koteos/RANDOM/10-EKOT-1074-170619A-UBF-PI/DOC/WhatsApp Image 2026-09-30 at 3.54.33 PM.jpeg

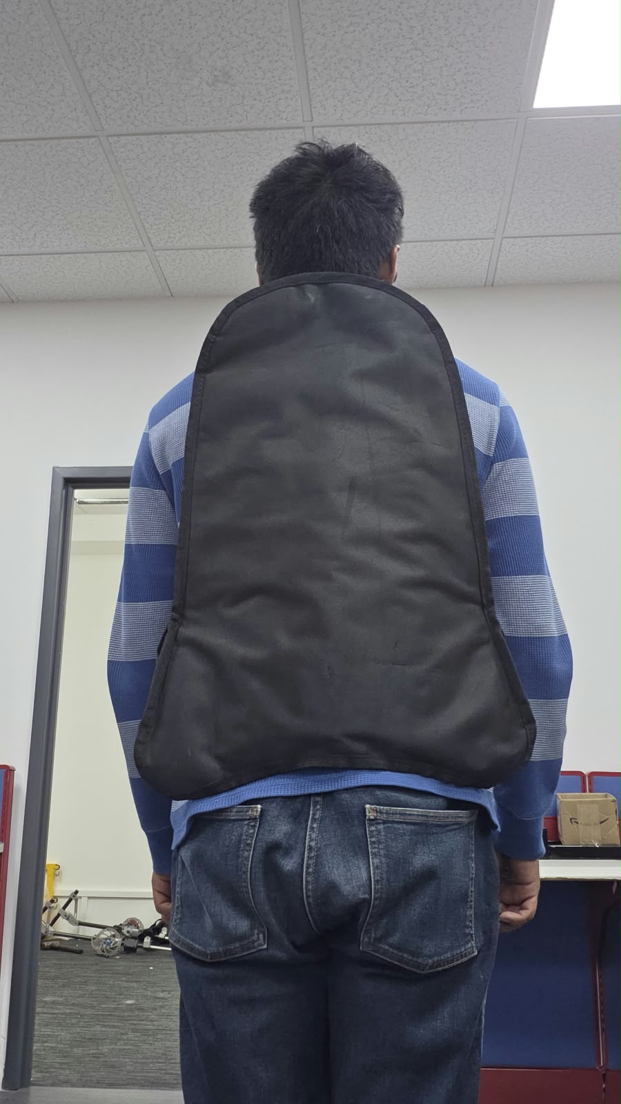
10-EKOT-1074-170619A-UBF-PI/DOC/WhatsApp Image 2026-09-30 at 3.54.33 PM.jpeg
