koteos/RANDOM/10-EKOT-1074-170619A-UBF-PI/V1.6_PANACEA/readme-and-terms-of-use-3d-cad-models.docx

EN Your CAD data on 13.03.2026 from Festo:

Dear customer,

attached please find the following file of our 2D/3D-CAD download portal powered by CADENAS:

identification number: 2674 SG-M10

STEP, 2674 SG-M10, 2674_SG-M10.stp

Please also check terms of use at:

https://www.cadenas.de/terms-of-use-3d-cad-models

Best regards

Festo SE & Co. KG

CAD Service

design_tool@festo.com
