koteos/RANDOM/10-EKOT-1074-170619A-UBF-PI/V1.4_SE_FABRICO/3D/LISTA_TORNILLERIA.txt

TORNILLERIA

- 10 Tornillo  M2 x 12 o 15

- 25 Tornillo  M3 x 5
- 10 Tornillo  M3 x 10
- 10 Tornillo  M3 x 16

- 4  Tornillo  M4 x 5
- 4  Tornillo  M4 x 10
- 10 Tornillo  M4 x 12

- 5  Tornillos M5 x 30

- 10 Tornillos M6 x 20
- 2  Tornillo  M6 x 25

- 4 hombros 6  x 25
- 4 Hombros 6  x 20 
- 2 Hombros 12 x 10

- 2 Prisionero M3

- 2  Tuercas M10
- 20 Tuercas M5

- 8 bujes roscados interior m6
- broca 2mm
- caja de prisioneros
