koteos/RANDOM/10-EKOT-1074-170619A-UBF-PI/V1.0/DOC/Kotemah® COBHAN - Propuesta Técnica -.pptx

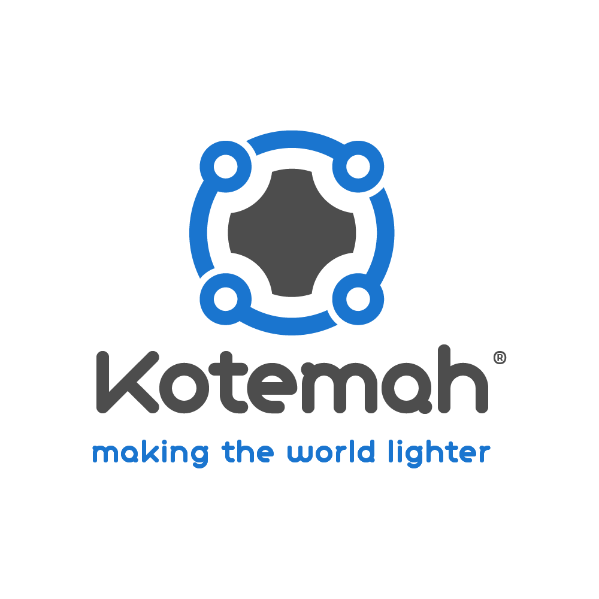
[picture p9: figure]

## Slide 2

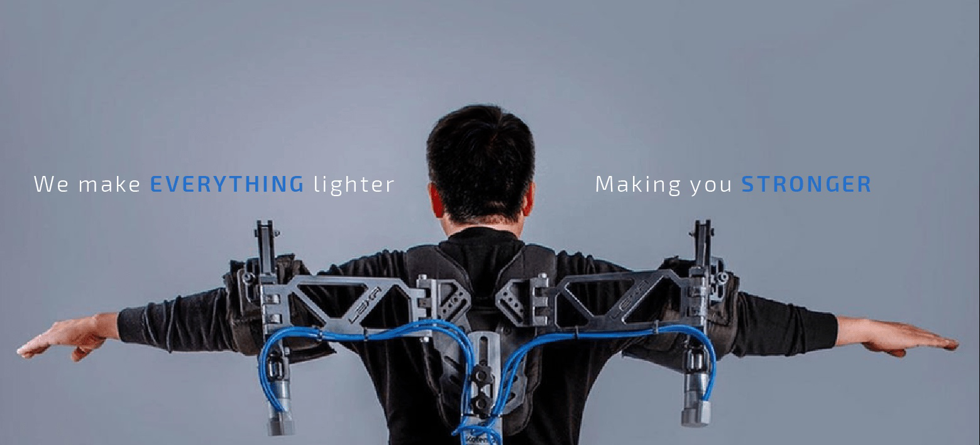
[picture p10: figure]

## Slide 3

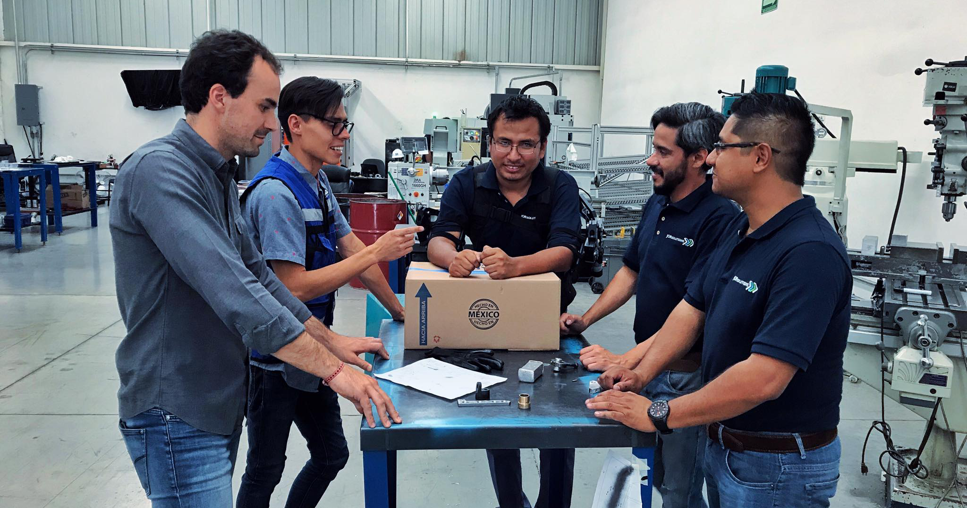
[picture p11: figure]

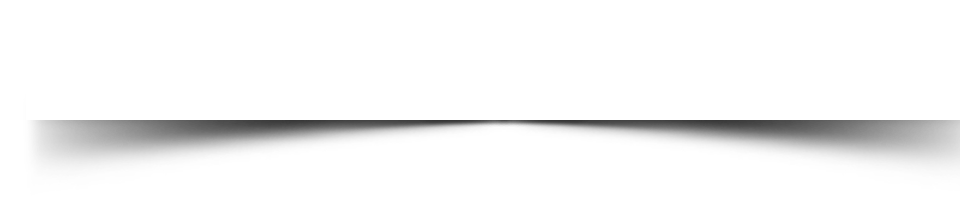
[picture p12: figure]

5 años

haciendo a México más ligero °

## Slide 4

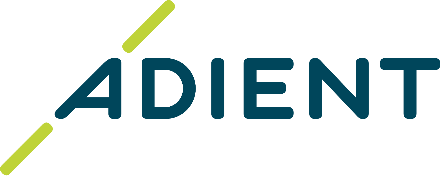
[picture p13: figure]
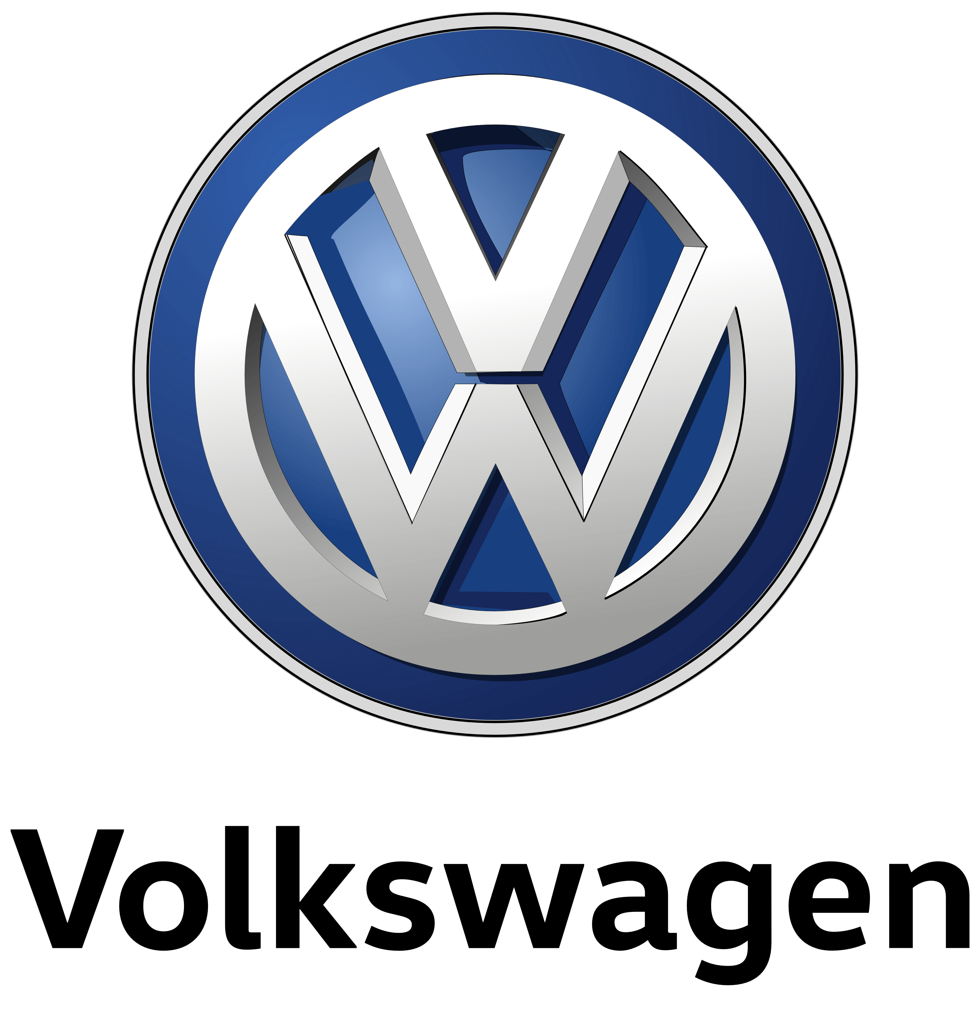
[picture p14: figure]
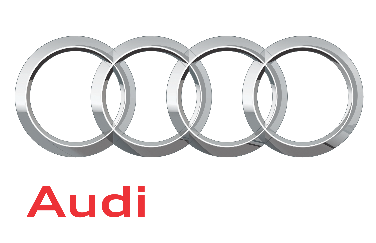
[picture p15: figure]
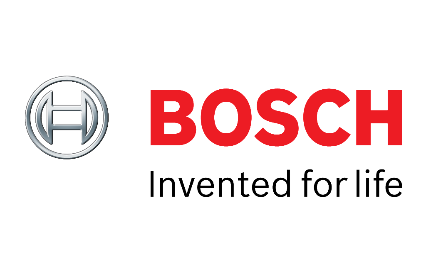
[picture p16: figure]
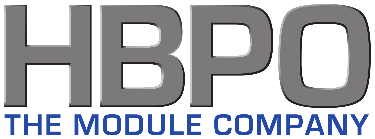
[picture p17: figure]
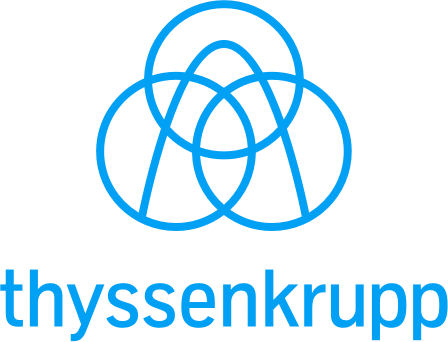
[picture p18: figure]

## Slide 5

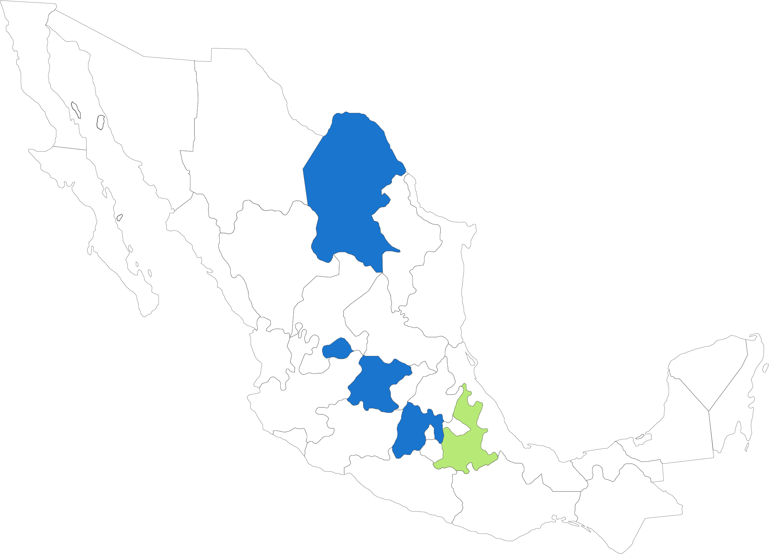
[picture p19: figure]
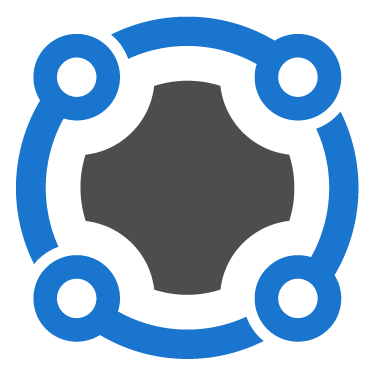
[picture p20: figure]

México

## Slide 6

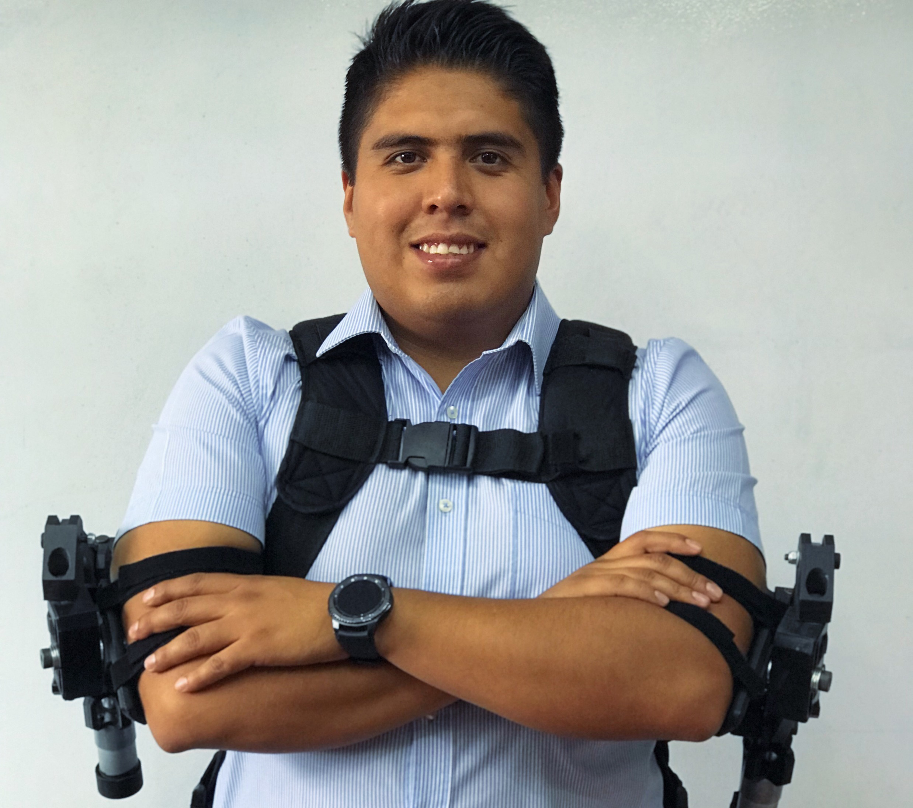
[picture p21: figure]
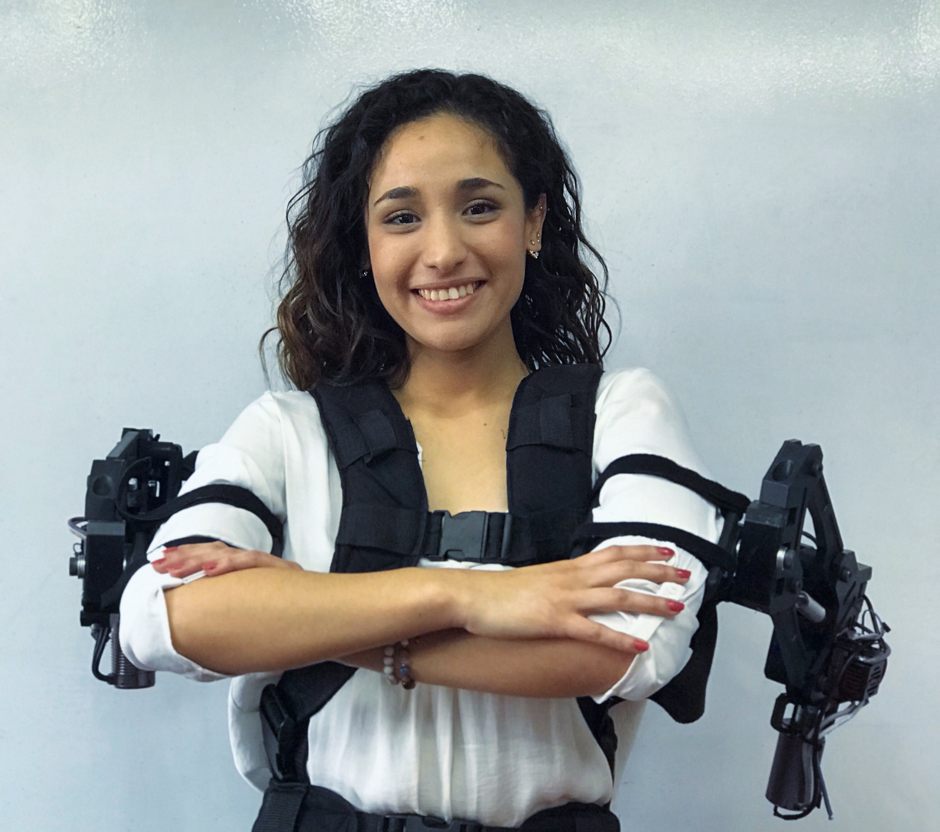
[picture p22: figure]
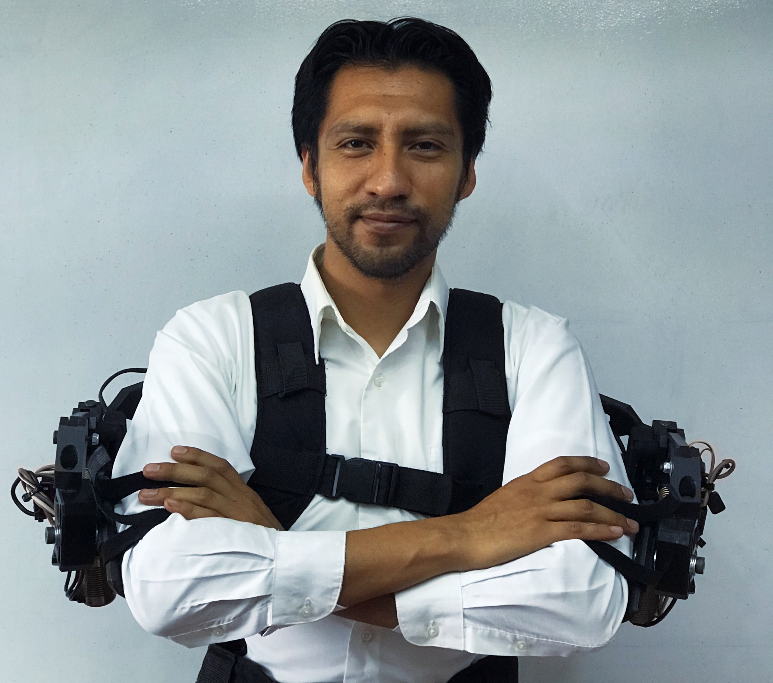
[picture p23: figure]
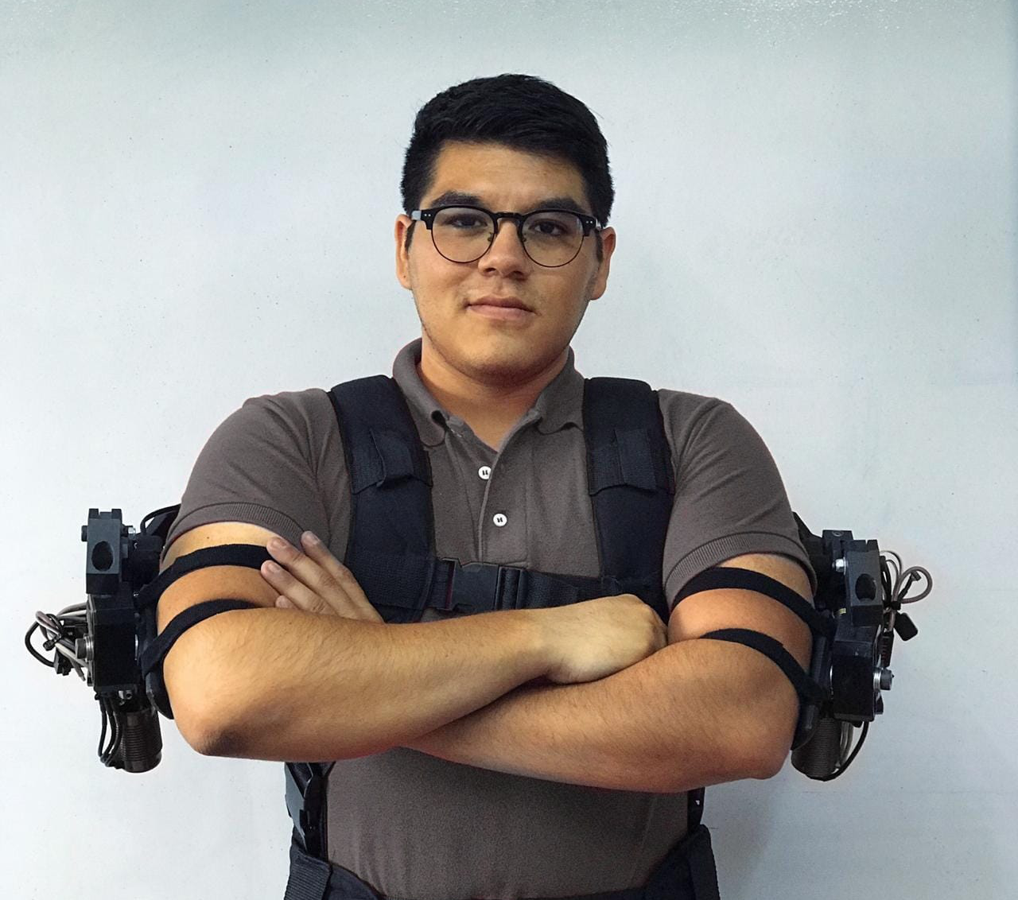
[picture p24: figure]
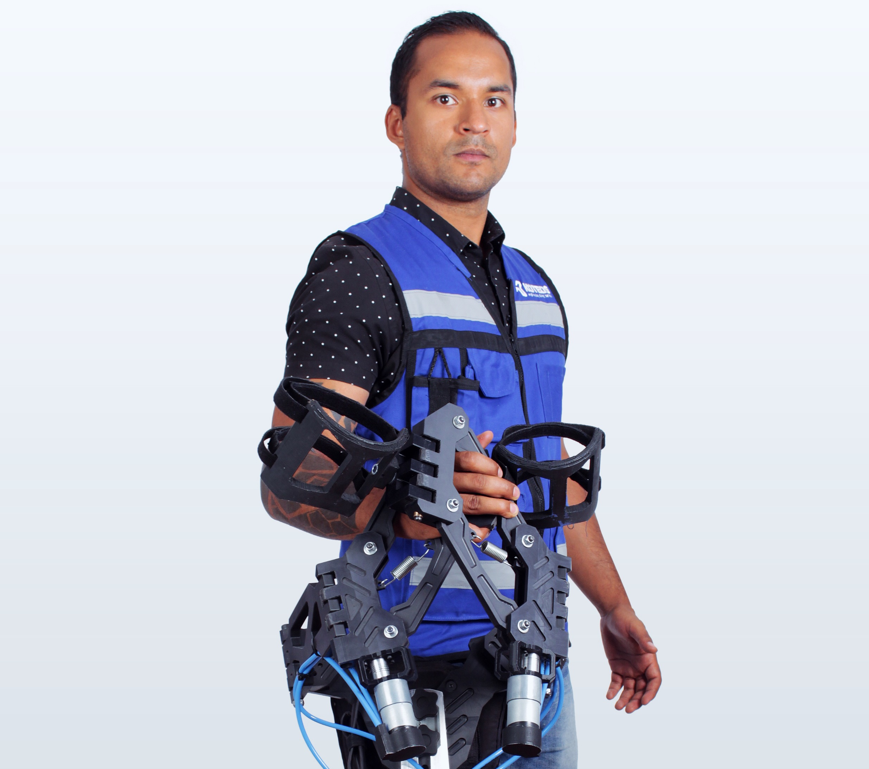
[picture p25: figure]

SOMOS EXPERTOS

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
Martín
Ventas Consultivas

Lizeth
Ergonomía

Antonio
Análisis

Carlos
Investigación y Desarrollo

Abissai
Proyectos

EN LIFTING

## Slide 7

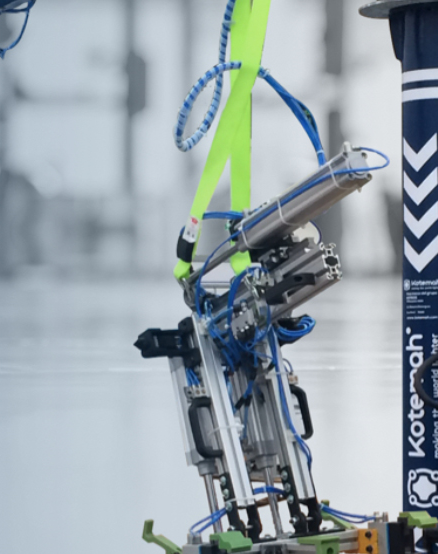
[picture p26: figure]

ASISTENTE DE CARGA

PARA BANCA FRONTAL CONDUCTOR

Ing. Josafat E. Badillo Gallegos
Advanced Manufacturing Engineer
ADIENT

## Slide 8

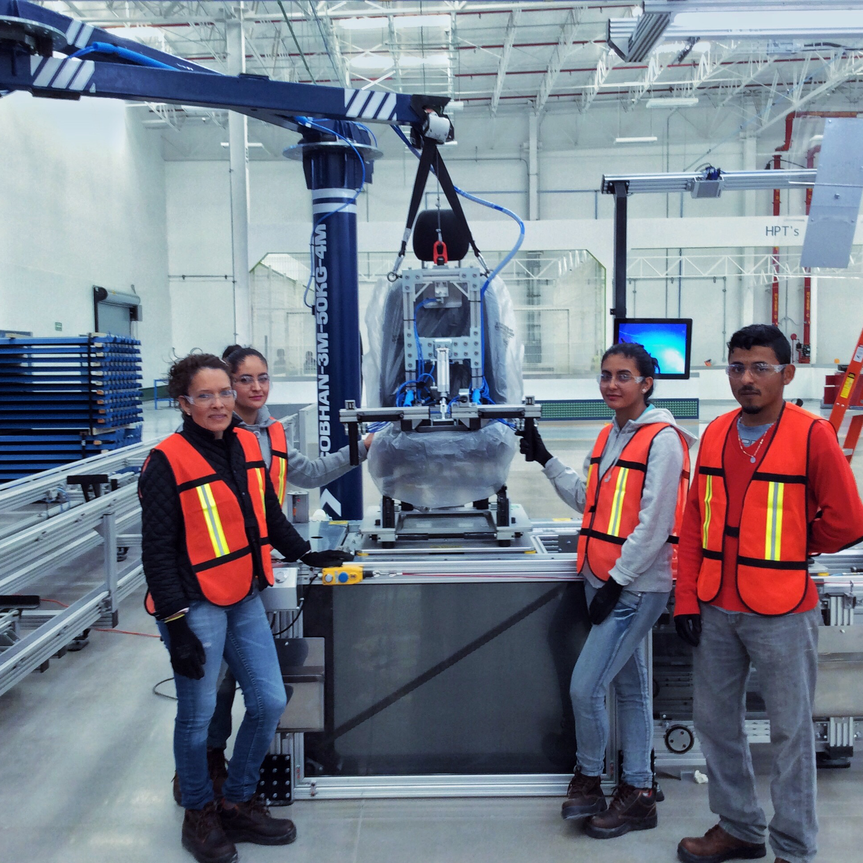
[picture p27: figure]

COBHAn

El favorito para líneas de ensamble

Asistencia: Hasta 200 Kg
Altura: Hasta 4 metros
Alcance: Hasta 6 metros
Área de Manipulación: 320°

## Slide 9

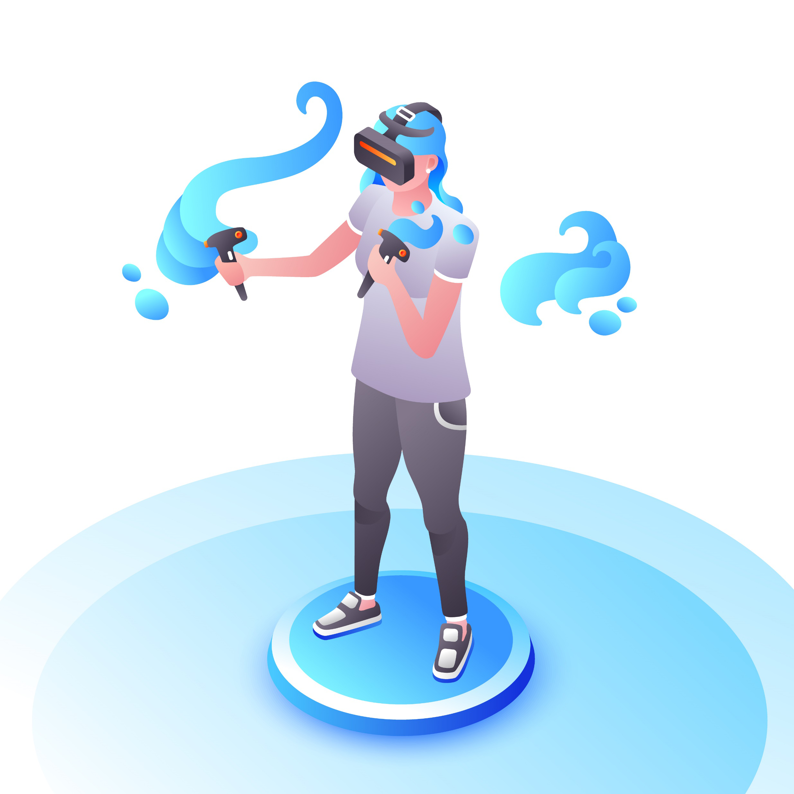
[picture p28: figure]
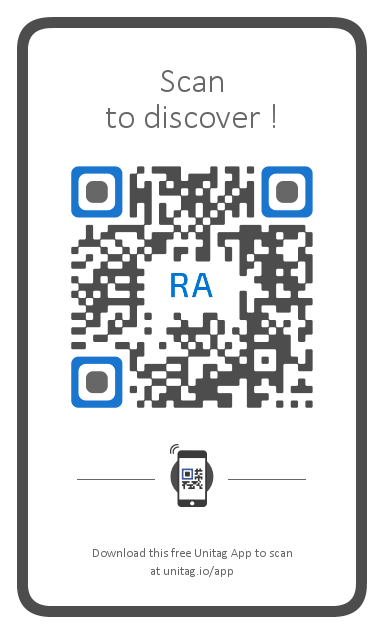
[picture p29: figure]

## Slide 10

COBHAn

El favorito para líneas de ensamble

VISTA GENERAL

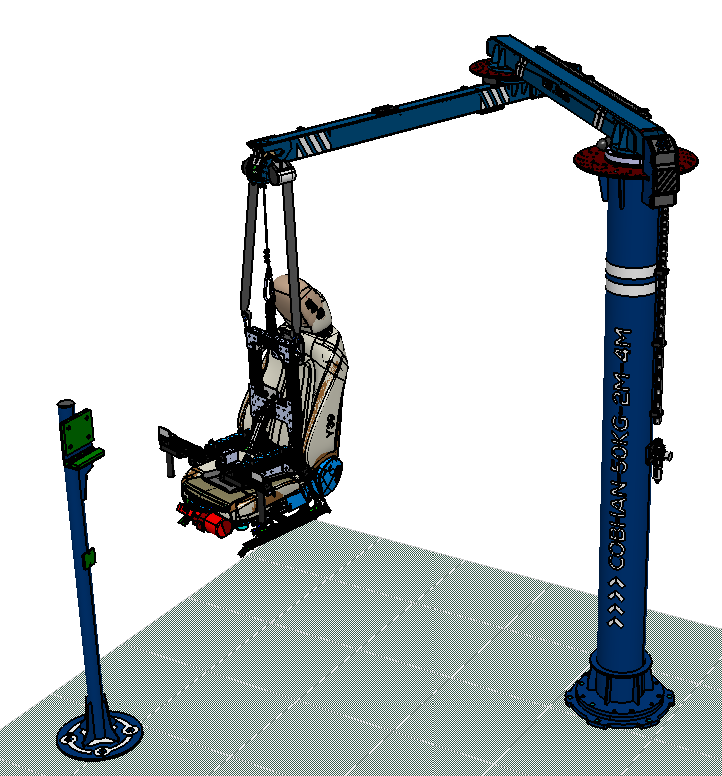
[picture p30: figure]

*AQUI VA LA CAPTURA DE PANTALLA
DE TU MANIPULADOR EN VISTA GENERAL*
*SIN COTAS*

## Slide 11

COBHAn

El favorito para líneas de ensamble

COMPONENTES PRINCIPALES

*AQUI VA TU CAPTURA DE PANTALLA QUE INDIQUE LOS COMPONENTES DE TU MANIPULADOR*
*CON COTAS*

## Slide 12

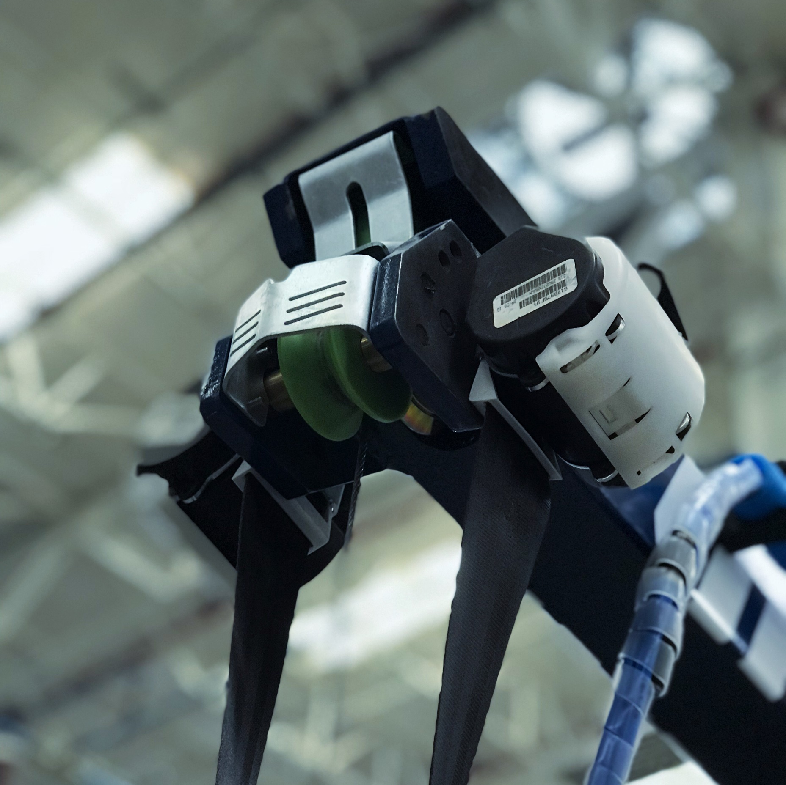
[picture p31: figure]

SEGURIDAD

## Slide 13

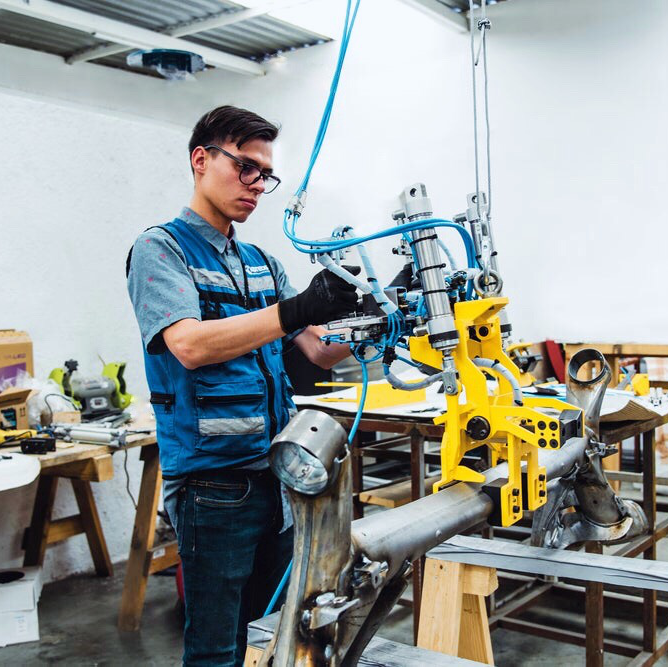
[picture p32: figure]

Gripper

## Slide 14

Gripper

VISTA GENERAL

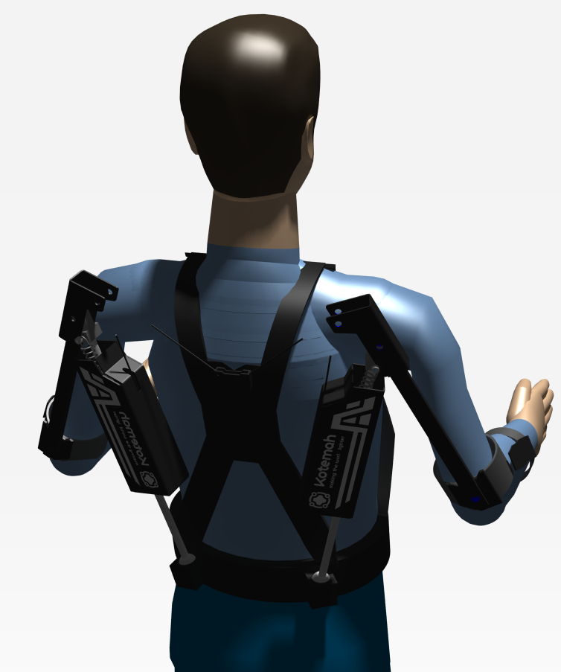
[picture p33: figure]

LeXA LiGHT

## Slide 15

Gripper

COMPONENTES PRINCIPALES

NUEVA EXTENSIÓN DE ALUMINIO QUE PERMITIRÁ MANTENER EL GRIPPER A UNA DISTANCIA NO MAYOR DE 30CM DEL CUERPO Y A UNA ALTURA DE 105 CM DEL PISO.

REUBICACIÓN DE BOTONERAS

REUBICACIÓN DE SELECTORES

REUBICACIÓN DE BOTONERAS

## Slide 16

## Slide 17

Gripper

DESCRIPCION DE PROPUESTA

CONTARÁ CON DOS PARES DE MANUBRIOS/BOTONERAS.

CON LOS MANUBRIOS “A” SE MANIPULARÁ EL GRIPPER PARA LLEGAR AL RACK Y CARGAR EL PRODUCTO. (POSICIÓN BAJA)

UNA VEZ SUJETO EL PRODUCTO, EL OPERADOR PRESIONARÁ EL BOTÓN SUBIR, Y PROCEDERÁ A TOMAR EL GRIPPER CON LOS MANUBRIOS “B”
(POSICIÓN ALTA).

ALTERNAR EL USO DE LOS MANDOS EVITARÁ QUE EL OPERADOR ESTIRE LOS BRAZOS ARRIBA DE LOS 107 CM.

A

B

## Slide 18

Gripper

AUMENTO DE AREA DE PRESION (BOTONES)

PROPUESTA 1.:
VULCANIZAR GATILLOS PARA LOGRAR ENSANCHAR EL AREA DE PRESION DE LA BOTONERA.
(SUJETO A PREUBAS DE ADHERENCIA DEL VULCANIZADO AL GATILLO).

PROPUESTA 2:
FABRICACION DE GATILLOS PERSONALIZADOS.
PODRÍA IMPLICAR COSTO MAYOR.

## Slide 19

¡Gracias!
Juntos podemos hacer a
ADIENT más ligero

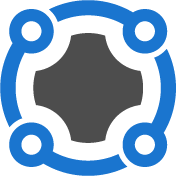
[picture p34: figure]
