koteos/RANDOM/10-EKOT-1074-170619A-UBF-PI/DOC/BOTONES.JPG

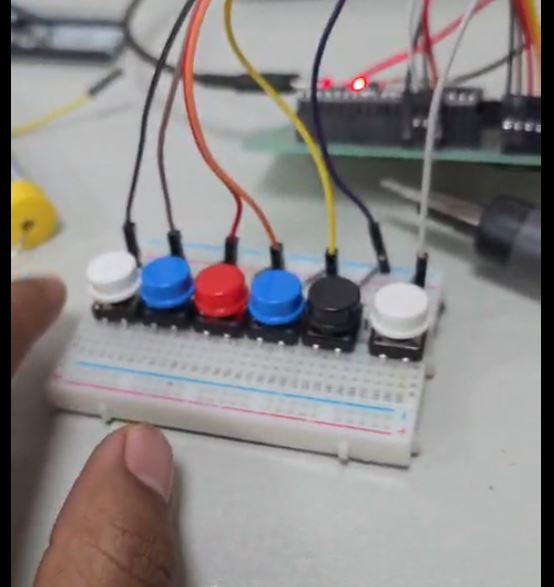
10-EKOT-1074-170619A-UBF-PI/DOC/BOTONES.JPG
