koteos/RANDOM/10-EKOT-1074-170619A-UBF-PI/DOC/LEXA_CHALECO.jpg

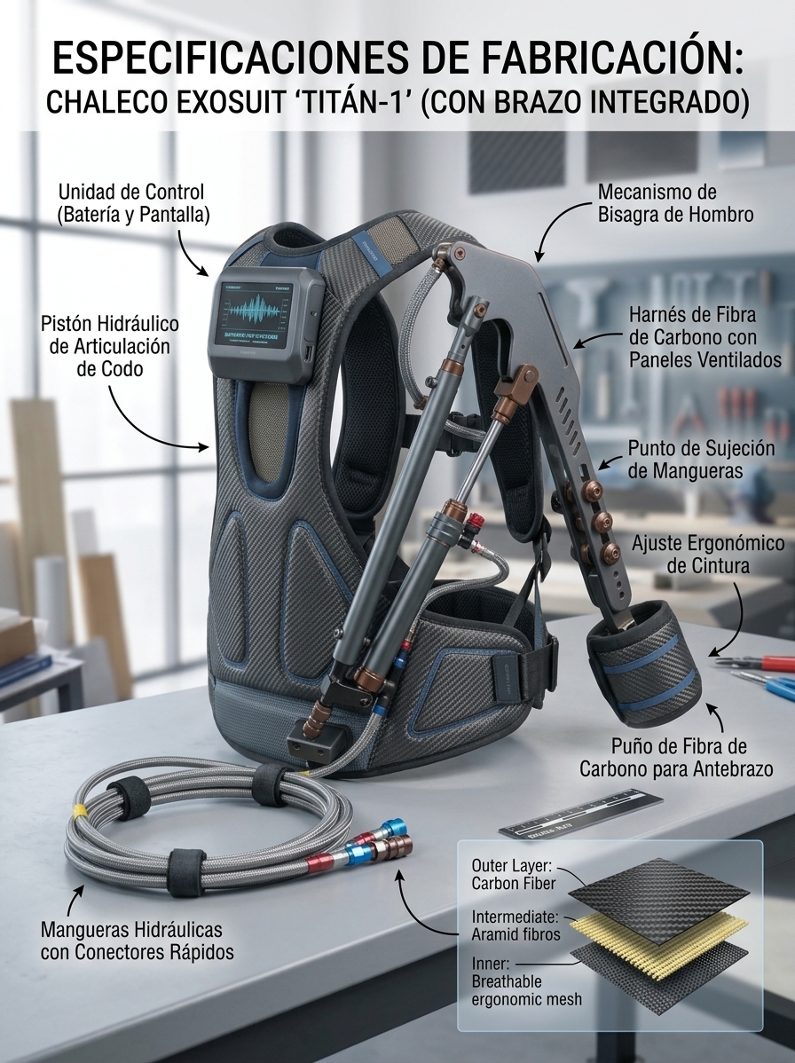
10-EKOT-1074-170619A-UBF-PI/DOC/LEXA_CHALECO.jpg
