koteos/RANDOM/10-EKOT-1074-170619A-UBF-PI/DOC/WhatsApp Image 2026-09-28 at 1.29.09 PM.jpeg

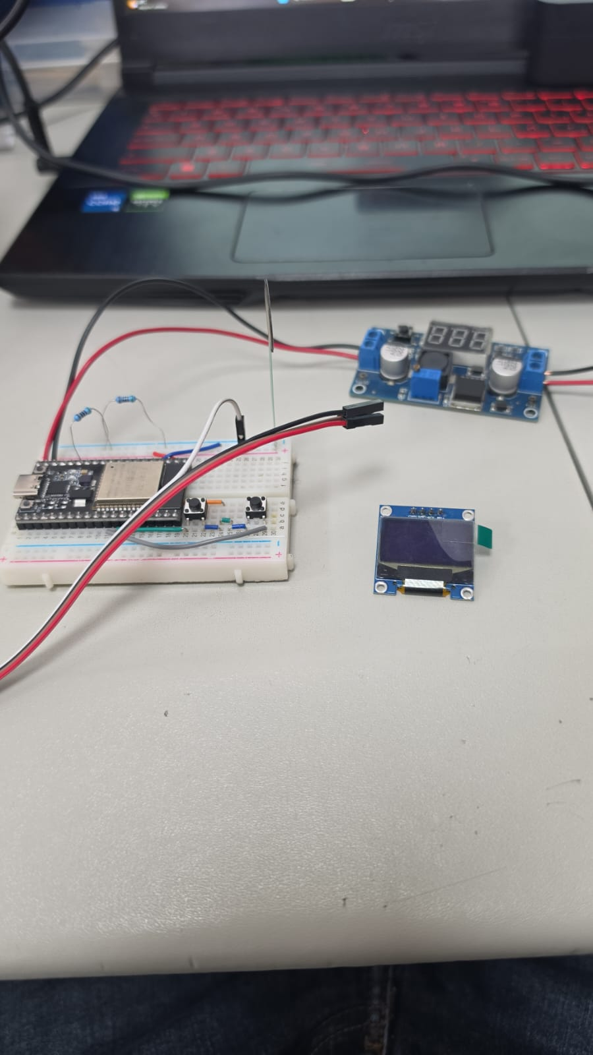
10-EKOT-1074-170619A-UBF-PI/DOC/WhatsApp Image 2026-09-28 at 1.29.09 PM.jpeg
