koteos/RANDOM/10-EKOT-1074-170619A-UBF-PI/DOC/WhatsApp Image 2026-09-29 at 4.07.12 PM.jpeg

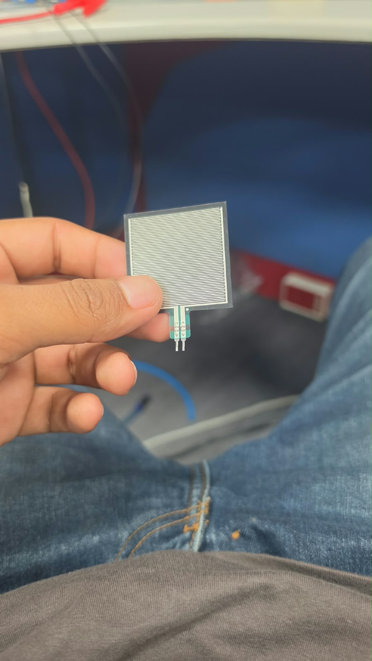
10-EKOT-1074-170619A-UBF-PI/DOC/WhatsApp Image 2026-09-29 at 4.07.12 PM.jpeg
