koteos/RANDOM/10-EKOT-1074-170619A-UBF-PI/V1.4_SE_FABRICO/DOC/RESORTE_CALCULO_55_ESPIRAS.JPG

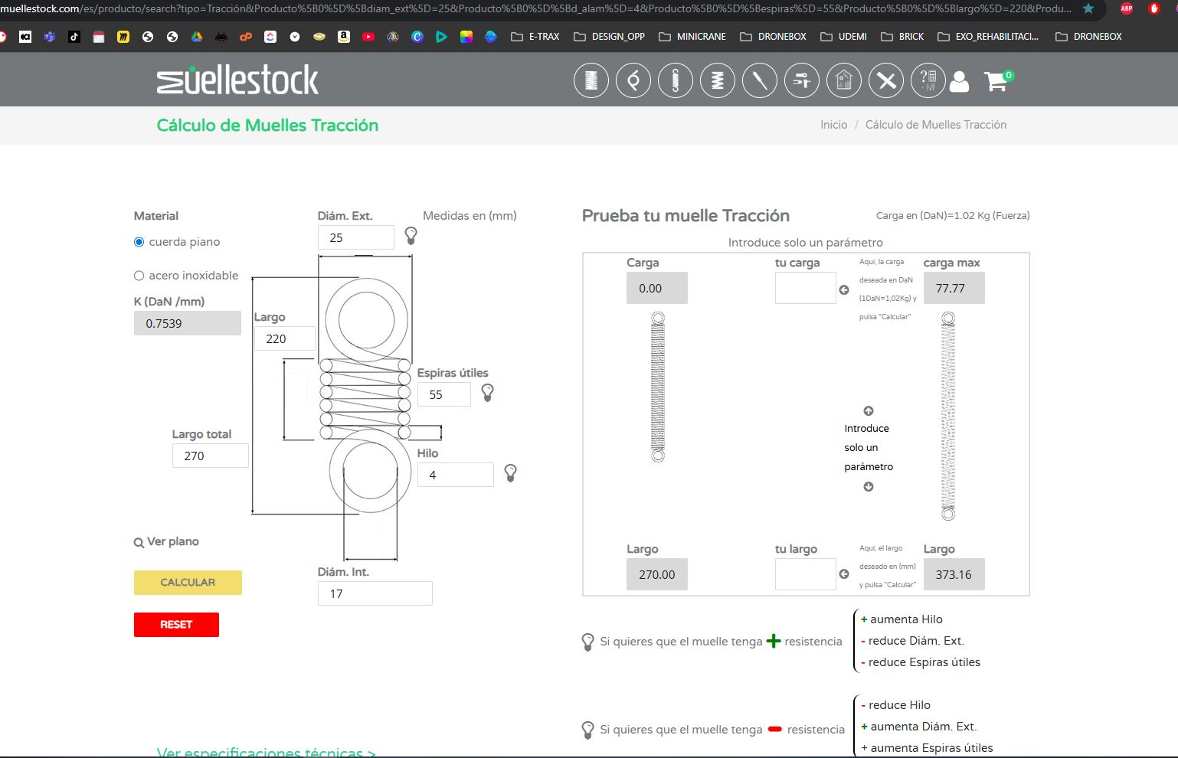
10-EKOT-1074-170619A-UBF-PI/V1.4_SE_FABRICO/DOC/RESORTE_CALCULO_55_ESPIRAS.JPG
