koteos/RANDOM/EKOT-1360-170921A-LEXA_WAIST_SUPPORT/V.06/DOC/RENDER2/COSTAL_HOMBRO.jpg

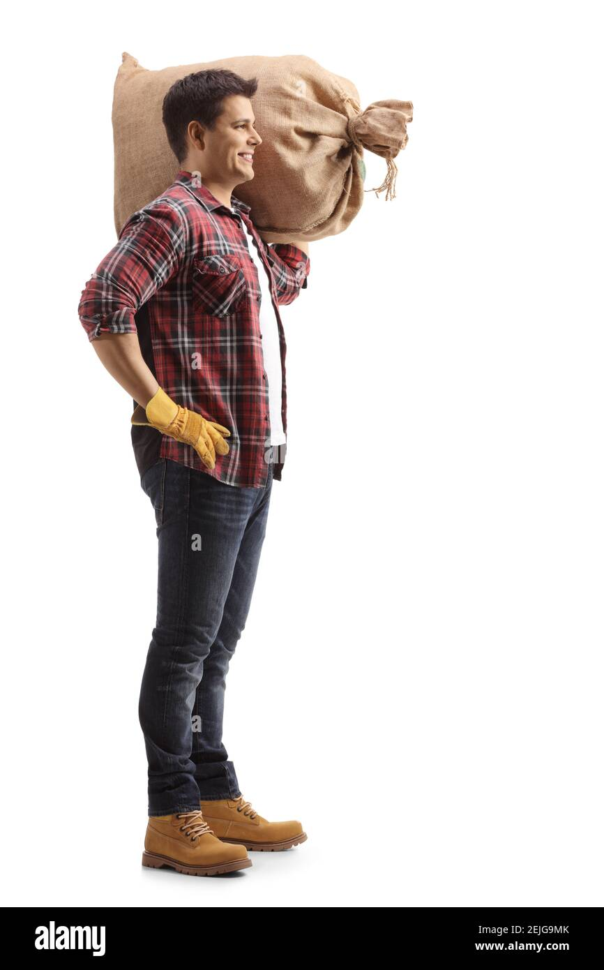
EKOT-1360-170921A-LEXA_WAIST_SUPPORT/V.06/DOC/RENDER2/COSTAL_HOMBRO.jpg
