koteos/RANDOM/EKOT-1360-170921A-LEXA_WAIST_SUPPORT/V.06/DOC/RENDER2/D4.JPG

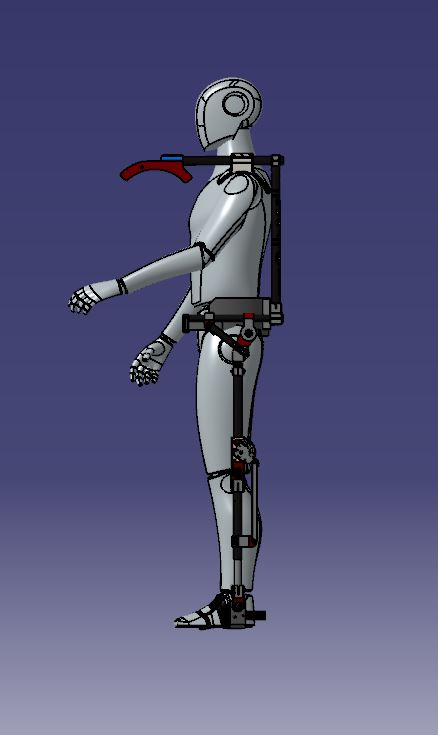
EKOT-1360-170921A-LEXA_WAIST_SUPPORT/V.06/DOC/RENDER2/D4.JPG
