koteos/RANDOM/EKOT-1360-170921A-LEXA_WAIST_SUPPORT/V.06/DOC/RENDER/EXO_COMPLETE.png

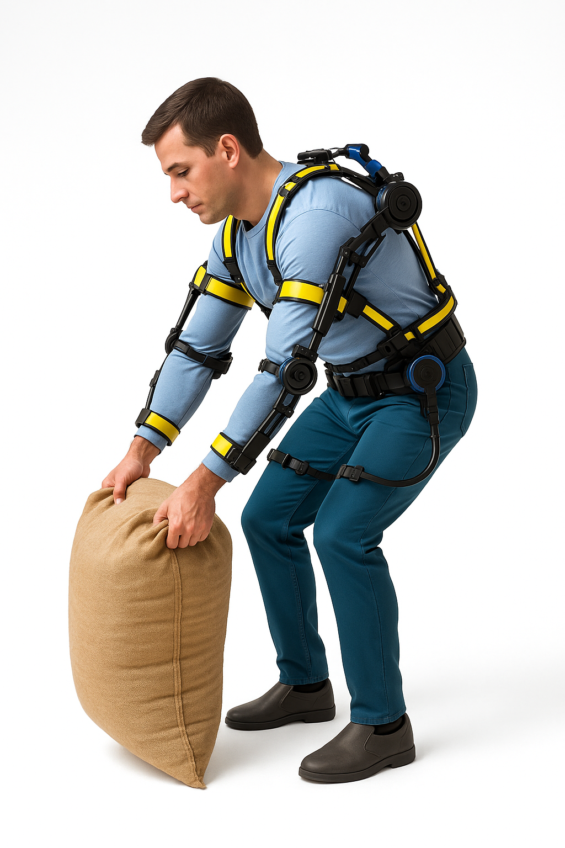
EKOT-1360-170921A-LEXA_WAIST_SUPPORT/V.06/DOC/RENDER/EXO_COMPLETE.png
