koteos/RANDOM/Gravedad_Cero_Electrico_filtro_v1/gravedad_cero.jpeg

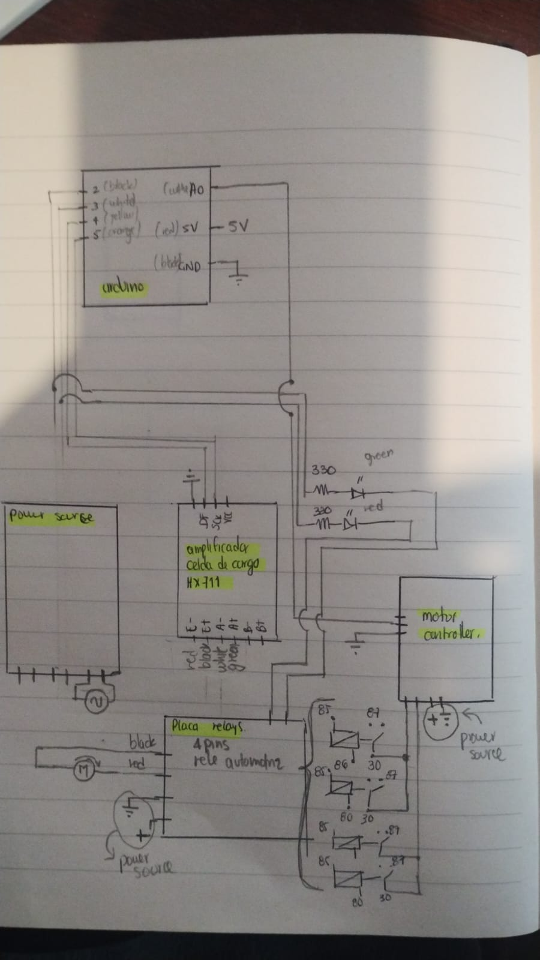
Gravedad_Cero_Electrico_filtro_v1/gravedad_cero.jpeg
