koteos/RANDOM/IMAGE_CLEAR/fotos_originales/motor.JPG

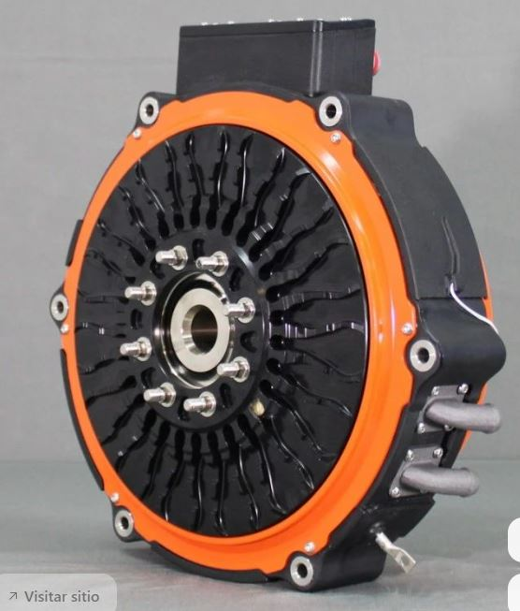
IMAGE_CLEAR/fotos_originales/motor.JPG
