koteos/RANDOM/INICIO.jpg

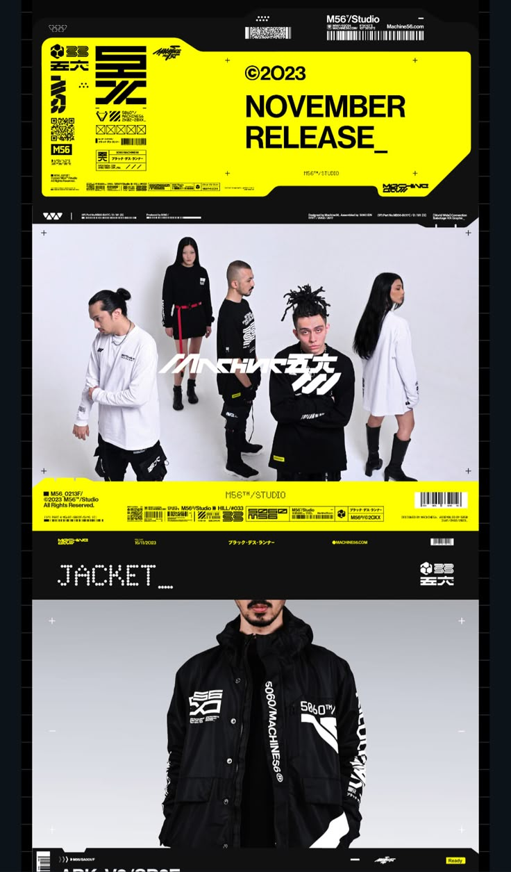
INICIO.jpg
