koteos/RANDOM/pancho.jpeg

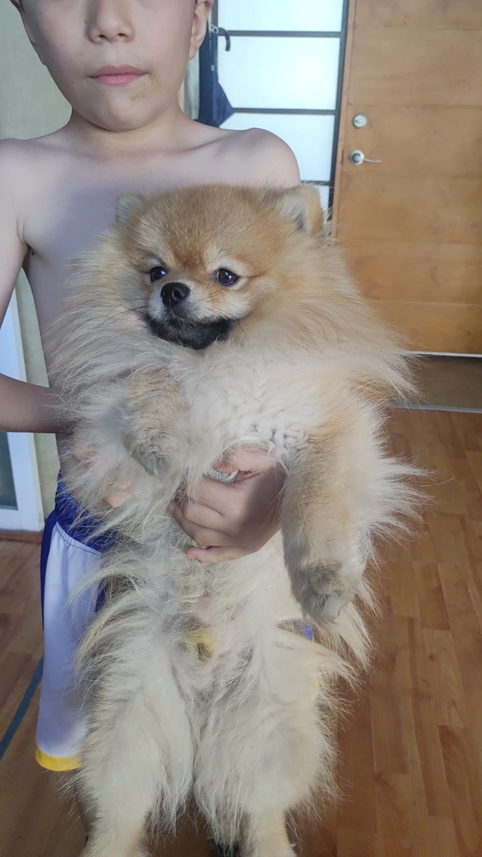
pancho.jpeg
