koteos/RANDOM/PIERNAS_EXO/Against Reference Model.png

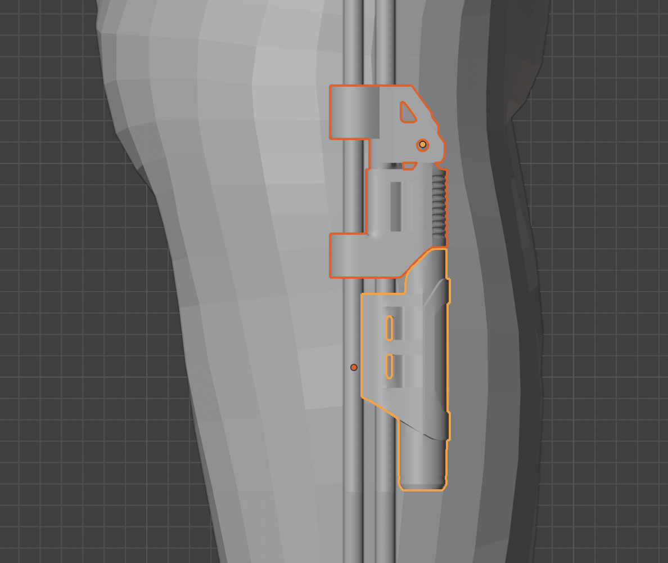
PIERNAS_EXO/Against Reference Model.png
