koteos/RANDOM/PIERNAS_EXO/Exploded Diagram.png

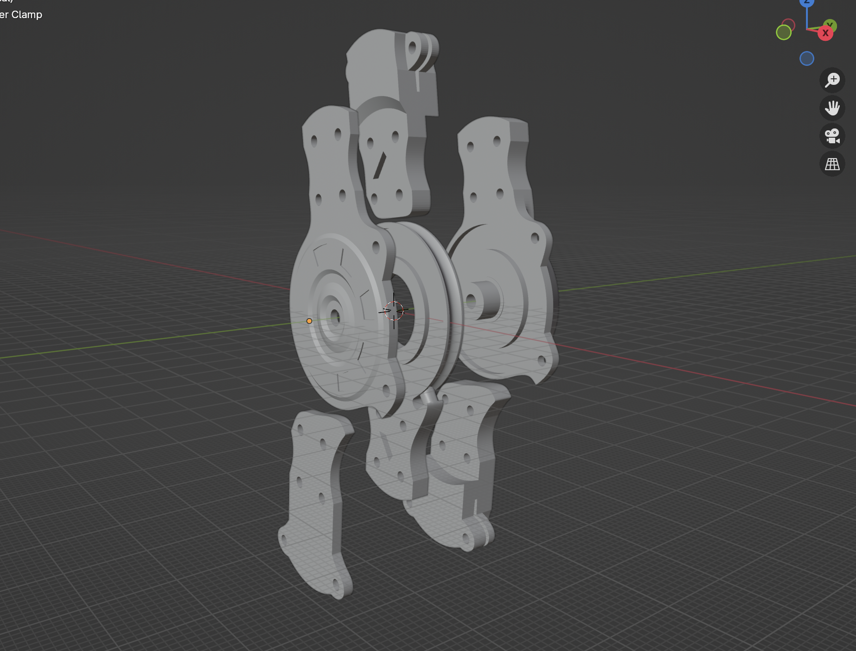
PIERNAS_EXO/Exploded Diagram.png
