koteos/RANDOM/PIERNAS_EXO/Files.png

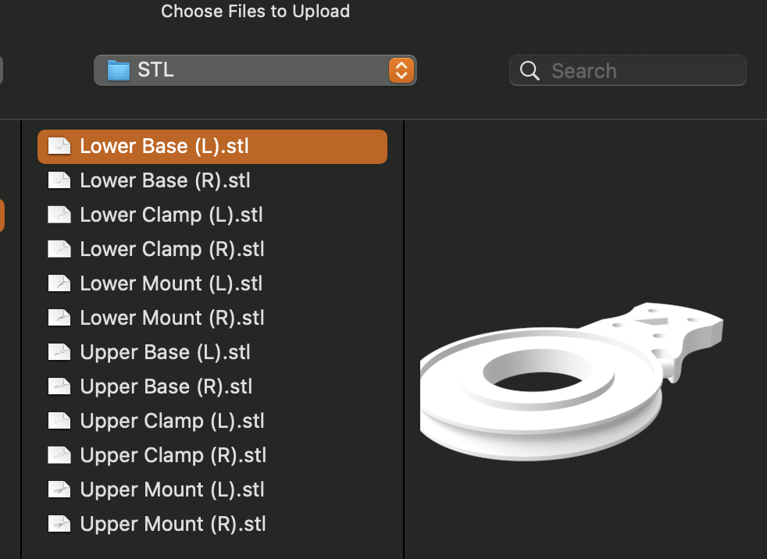
PIERNAS_EXO/Files.png
