koteos/RANDOM/PIERNAS_EXO/Image of Blender.png

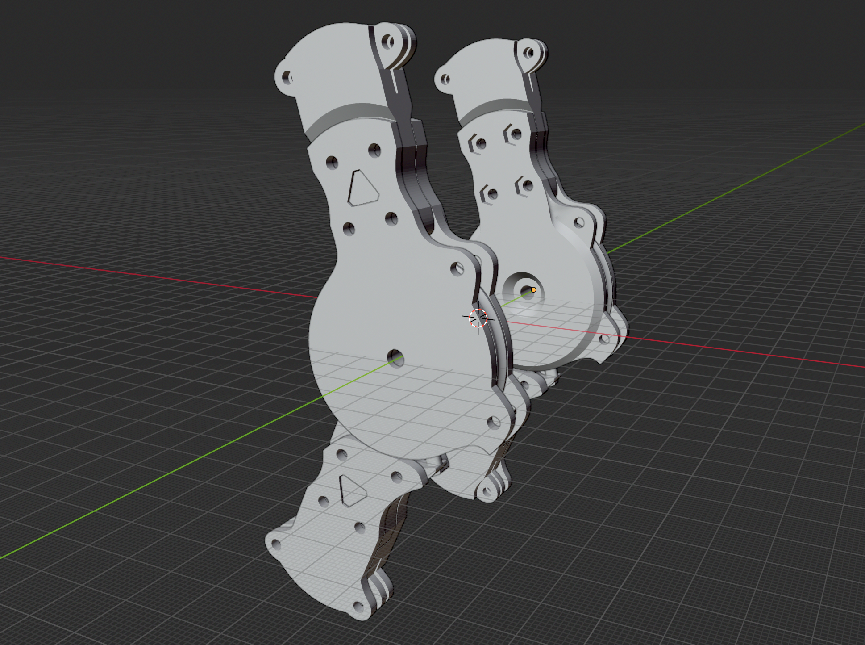
PIERNAS_EXO/Image of Blender.png
