koteos/RANDOM/PIERNAS_EXO/Knee Wire Frame (1).png

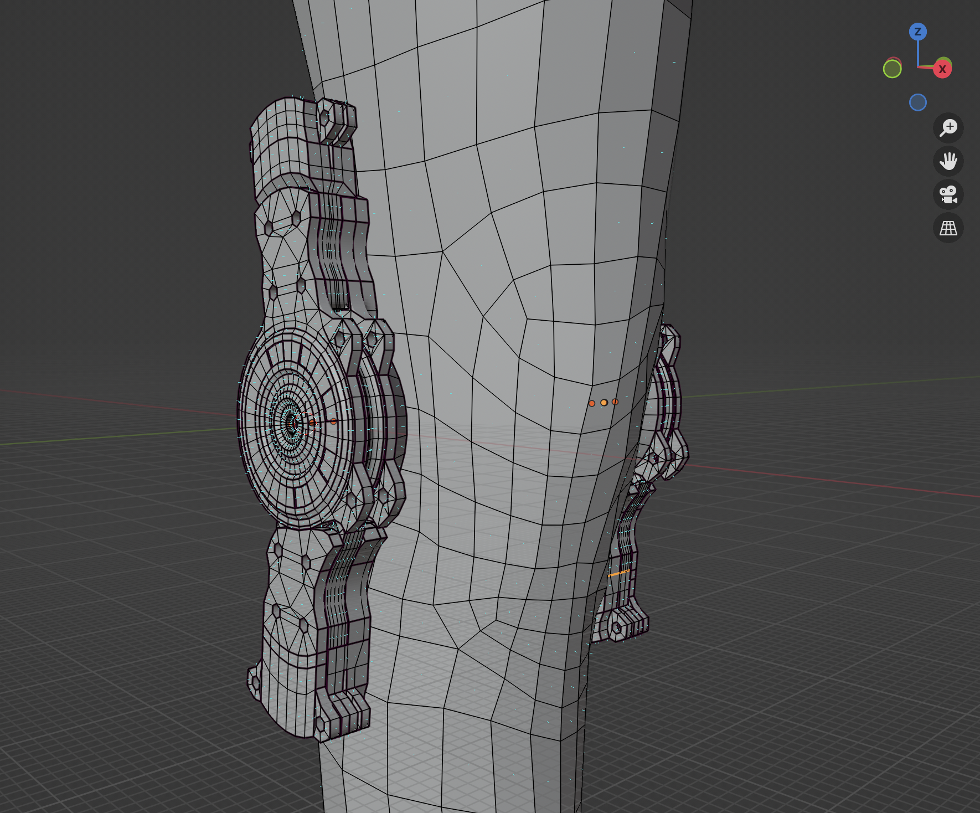
PIERNAS_EXO/Knee Wire Frame (1).png
