koteos/RANDOM/PIERNAS_EXO/Recommended Slicing Layout (R).png

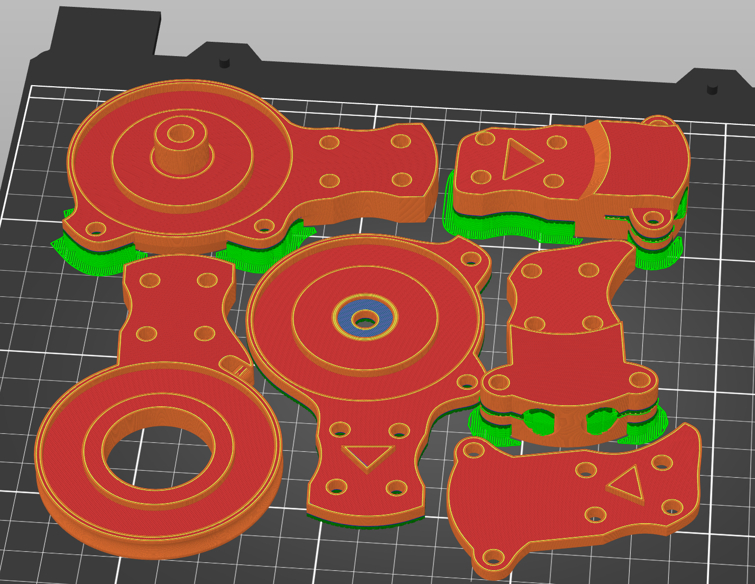
PIERNAS_EXO/Recommended Slicing Layout (R).png
