koteos/RANDOM/PIERNAS_EXO/Spring Covers & Mount.png

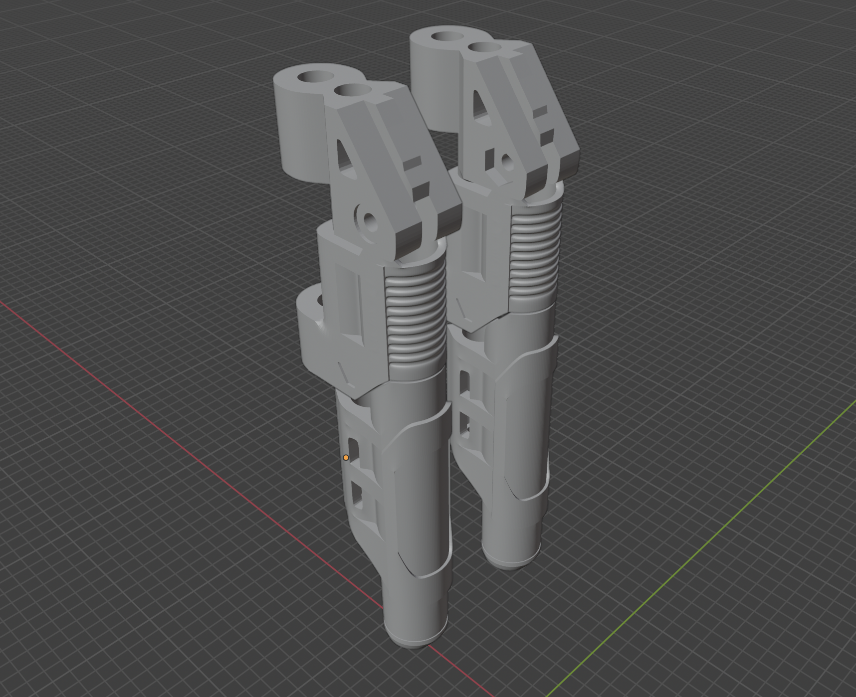
PIERNAS_EXO/Spring Covers & Mount.png
