koteos/RANDOM/PIERNAS_EXO/Spring No Extend.jpg

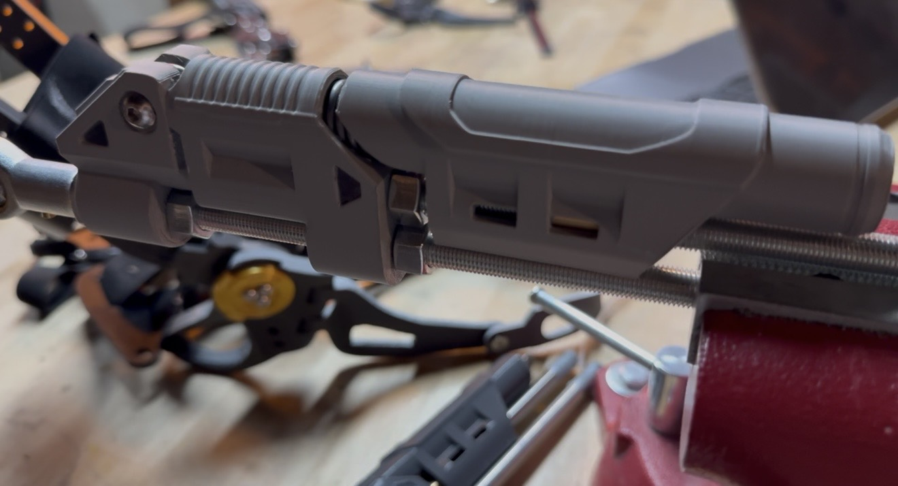
PIERNAS_EXO/Spring No Extend.jpg
