koteos/RANDOM/PIERNAS_EXO/Spring Slight Extend.jpg

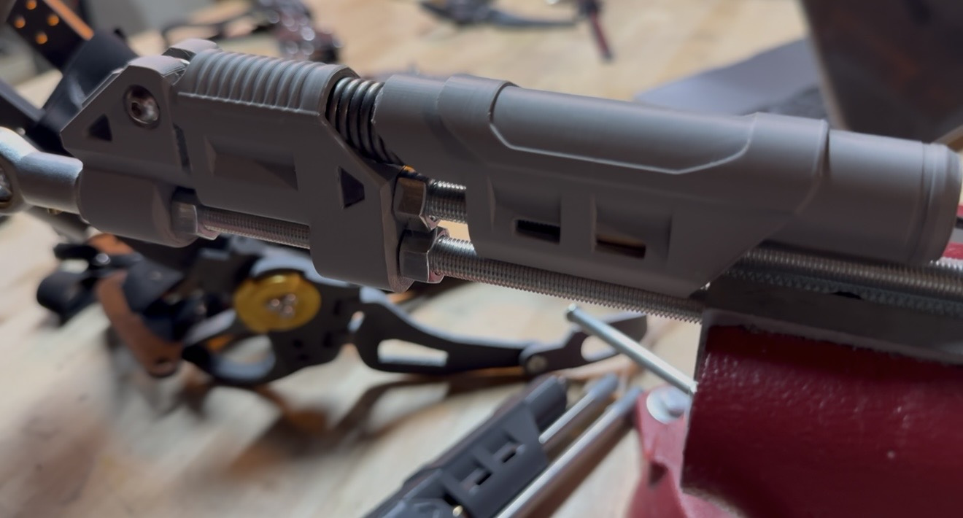
PIERNAS_EXO/Spring Slight Extend.jpg
