koteos/RANDOM/PIERNAS_EXO/tempImageO1IdrG.jpg

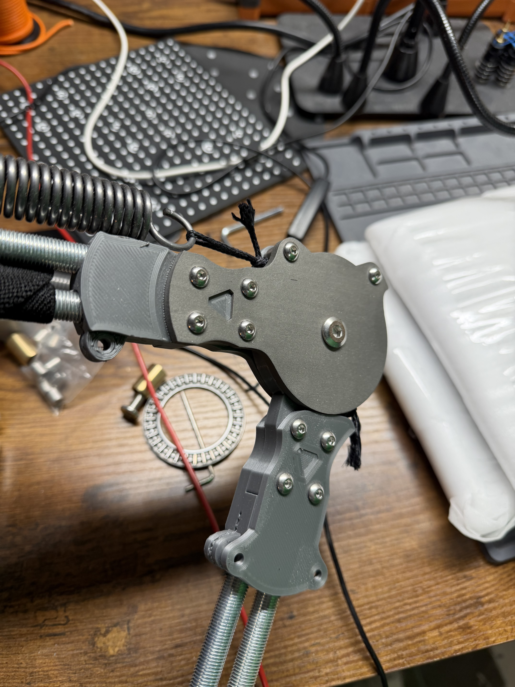
PIERNAS_EXO/tempImageO1IdrG.jpg
