koteos/RANDOM/PIERNAS_EXO/tempImagePTBHhn.jpg

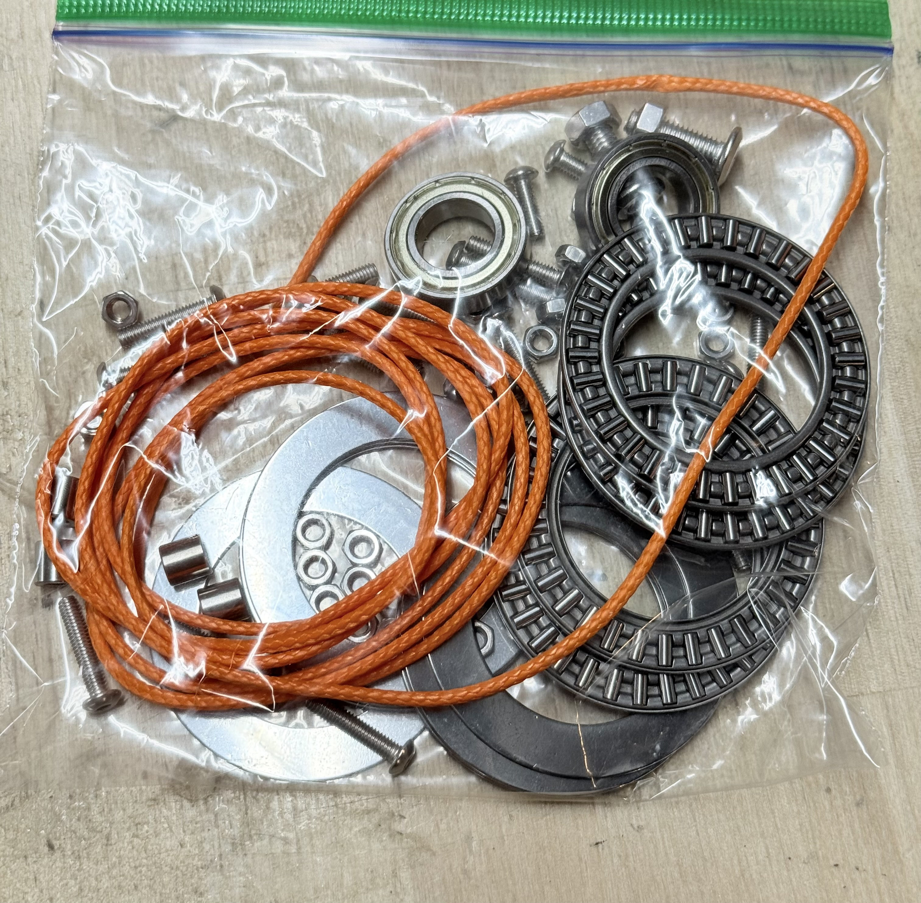
PIERNAS_EXO/tempImagePTBHhn.jpg
