koteos/RANDOM/PIMP-1889-250226A-AWARETRACK/V1.0/DOC/AWARETRACK_RENDER_01.png

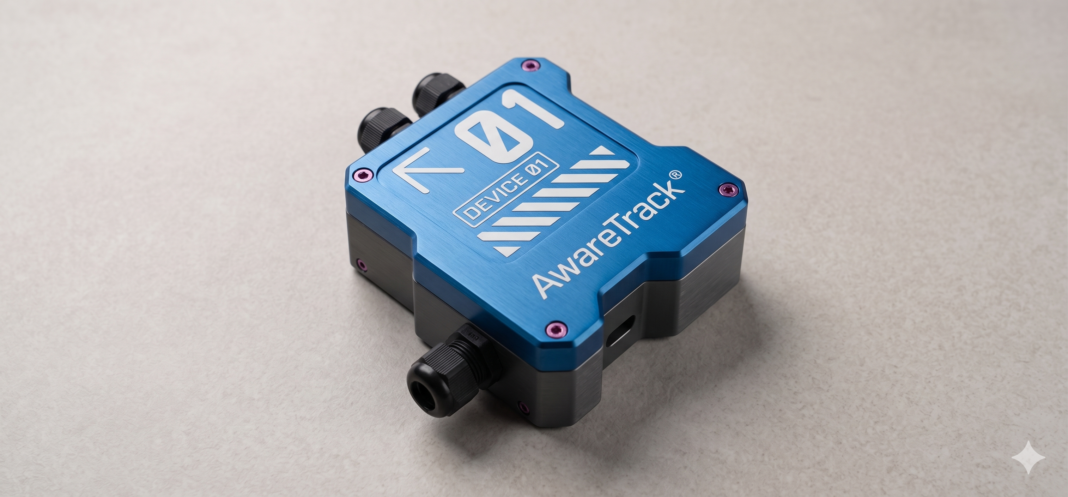
PIMP-1889-250226A-AWARETRACK/V1.0/DOC/AWARETRACK_RENDER_01.png
