koteos/RANDOM/sign1.JPG

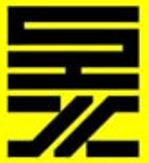
sign1.JPG
