koteos/RANDOM/sign3.jpg

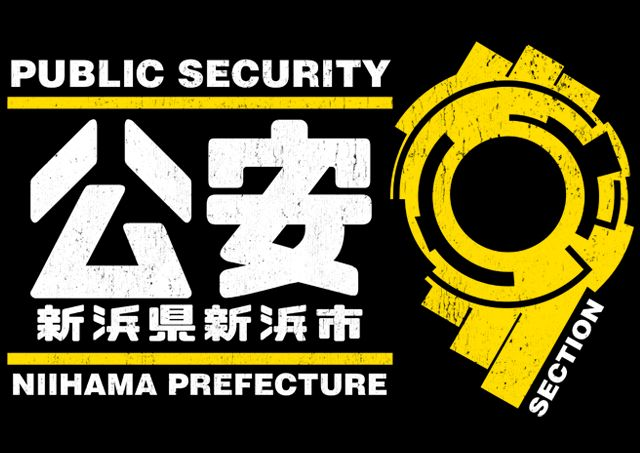
sign3.jpg
