koteos/RANDOM/EKOT-1360-170921A-LEXA_WAIST_SUPPORT/DOC/COSTEO LEXA.xlsx

Sheet: RESUMEN
 |  | COSTOS LEXA 1069 Y 1360
CONCEPTO | MONTO
MATERIAL | $7720.87
FABRICACION | $21561.24
DISEÑO (R&D) | $42531.50
ENSAMBLE (R&D) | $81092.00
MONTAJE
GASTOS
COVID
EPP
TOTAL | $152905.61

Sheet: MATERIAL
 |  |  | MATERIAL
FECHA | A FAVOR DE | CONCEPTO | MONTO
2021-08-19 | ROD | MATERIAL | $208.00
2021-08-26 | ROD | COMPONENTES GUITARRA EXO | $275.00
2021-08-26 | IGUS | MATERIAL | $4994.22
2021-08-27 | MISUMI | MATERIAL | $1082.97
2021-09-09 | AMAZON | TENSOR DE ALAMBRE M5 | $242.50
2021-09-09 | COMEX | LATAS PINTURA SPRAY NEGRO,TRANSPARENTE, AZUL CIELO | $267.00
2021-09-10 | RESORTES | RESORTES TENSOR 6 | $90.00
2021-09-10 | FERRETERIA | CABLE ACERO | $33.00
2021-09-10 | FERRETERIA | PERROS PARA CABLE | $84.00
2021-09-10 | FERRETERIA | TUERCAS MARIPOSAS | $100.00
2021-09-28 | RAM | TORLLERÍA | $149.00
2021-09-28 | PINTURAS Y MUROS | ESTOPA | $26.00
2021-09-28 | RETENES Y BALEROS | ROTULA GE12E | $45.00
2021-09-28 | LBO | SOLERA 6063 T-5 3.18X50.8MM | $124.18
 |  | TOTAL | $7720.87

Sheet: FABRICACIÓN
 |  |  | FABRICACIÓN
FECHA | A FAVOR DE | CONCEPTO | MONTO
2021-08-25 | DANIELA | 50% CHALECO ANTICIPO | $1000.00
2021-08-27 | MIPSA | CORTE LASER | $3593.68
2021-09-01 | DANIELA | 50% CHALECO FINIQUITO | $1000.00
2021-09-14 | FENIX | PRE21_202 | $500.00
2021-09-10 | MIPSA | COT 301648 | $1167.00
2021-09-20 | MIPSA | COT 301808 | $540.56
2021-09-06 | ERNESTO ASYS | ANTICIPO | $5000.00
 | ERNESTO ASYS | FINIQUITO | $8760.00
 |  | TOTAL | $21561.24

Sheet: DISEÑO
 |  |  | FABRICACIÓN
FECHA | A FAVOR DE | HORAS | MONTO
SEM 34 Y 35 2021 | ANTONIO | 56 | $11704.00
2021-08-20 | MARIO | 4 | $836.00
2021-08-23 | MARIO | 9.5 | $1985.50
2021-08-24 | MARIO | 9 | $1881.00
2021-08-25 | MARIO | 9 | $1881.00
2021-08-26 | MARIO | 9 | $1881.00
2021-08-27 | MARIO | 9 | $1881.00
2021-08-30 | MARIO | 3 | $627.00
2021-08-31 | MARIO | 9 | $1881.00
2021 | MARCO | 56 | $11704.00
2021 | JOSE R | 30 | $6270.00
 |  | TOTAL | $42531.50

Sheet: ENSAMBLE
 |  |  | FABRICACIÓN
FECHA | A FAVOR DE | HORAS | MONTO
2021 | ANTONIO | 110 | $22990.00
2021 | MARIO | 115 | $24035.00
2021 | MARCO | 113 | $23617.00
2021 | JOSE R | 50 | $10450.00
 |  | TOTAL | $81092.00
