koteos/RANDOM/EKOT-1360-170921A-LEXA_WAIST_SUPPORT/DOC/AVANCE DE FABRICACIÓN 1360.xlsm

Sheet: PORTADA
 |  |  | SEGUIMIENTO DE FABRICACIÓN |  |  |  | Instrucciones de uso y recomendaciones:
 |  |  |  |  |  |  | 1. Llena los campos generales de las celdas grises.
Proyecto | 1360 | Descripción | Exoesqueleto Waist Support |  |  |  | 2. Selecciona del cuadro el tipo de producto ( Si el producto no se encuentra en la lista deja el cuadro con "-", todo deberá llenarse manualmente)
Fecha | 07.12.2021 | Cliente | KOTEOS |  | Realizó | M.Gutiérrez | 3. Confirma dando click en el cuadro que corresponda
 |  |  |  |  |  |  | 4. Las celdas de porcentaje de avance y total$ se irán actualizando conforme se vayan llenando los campos de las hojas en cuestión, puedes acceder a ellas dando click en los botones verdes
SELECCIONAR TIPO DE PRODUCTO: |  |  | Exoesqueleto
FABRICACIÓN EXOESQUELETO |  |  |  |  | 77.27% |  | 5. Algunas de las paginas que se llenan automáticamente son : COLUMNA, BRAZO, ANTEBRAZO, NEUMATICA ACCESORIOS Y TORNILLERÍA. | ASYS
 |  |  |  |  |  |  |  | DISPOMEX
 |  |  |  |  |  |  | 6. Algunos de los campos que se llenan en cada hoja automaticamente son: # de pieza/serie, Denominación, Foto, Cantidad, Precio y Total | MAQUINADOS SERRA (INTERMAQ)
 |  |  |  |  |  |  |  | DIMSA
 |  |  |  |  |  |  | 7. ABSOLUTAMENTE TODOS LOS CAMPOS SE PUEDEN LLENAR Y MODIFCAR MANUALMENTE
 |  |  |  |  |  |  | 8. El modulo de avance de fabricación se debe llenar con "1" si ya está completada la fase y "0" si aún no está completada la fase
 |  |  |  |  |  |  | ESTE EXCEL SIRVE DE BASE/ MACHOTE, NO EXISTE UN COMANDO QUE BORRE REGISTROS PASADOS SOLO CON SELECCIONAR Y CONFIRMAR UN PRODUCTO DIFERENTE CADA QUE SE REALICE PARA UN NUEVO PROYECTO, POR LO QUE SE RECOMIENDA DESCARGAR ESTE DOCUMENTO BASE EN BLANCO CADA QUE SE NECESITE LLENAR PARA UN NUEVO PROYECTO.
ACCESORIOS |  |  |  |  | 50.00%
TORNILLERÍA |  |  |  |  | 50.00%
AVANCE TOTAL |  |  |  |  | 59.09%
TOTAL $ |  |  |  |  | #REF!
Nombre, firma y fecha del Líder de Proyecto |  |  |  | Nombre, firma y fecha del Líder de Op.

Sheet: 1360
SEGUIMIENTO DE FABRICACIÓN: MAQUINADOS
Proyecto No. |  | 1370 |  |  |  | Descripción | Exoesqueleto Waist Support
Fecha |  | 07.12.2021 |  |  |  | Cliente | KOTEOS |  |  | Realizó |  | M.Gutiérrez
FABRICACIÓN EXOESQUELETO |  |  |  |  |  |  | AVANCE TOTAL |  |  |  |  | 77.27 |  | % | TOTAL $ | $0.00
# PIEZA | DENOMINACIÓN | AVANCE DE FABRICACIÓN |  |  |  |  | FOTO | Número de Dibujo Interno | Cantidad | Fecha INICIO | Fecha ESTIMADA | Fecha ENTREGA | Proveedor | Precio | Total | Observaciones
 |  | Corte | Maquinado | Barrenado | Acabado | TOTAL
 |  | 25% | 50% | 75% | 100%
101 | AJUSTE DE TALLA | 1 | 1 | 0 | 0 | 50 |  |  | 1 |  |  |  |  |  | $0.00 |  | 50
102 | PLACA PECHO | 1 | 1 | 1 | 1 | 100 |  |  | 1 |  |  |  |  |  | $0.00 | Falta entregar soportes para adaptación de textil | 100
103 | TUBO SUPERIOR | 1 | 1 | 1 | 1 | 100 |  |  | 2 |  |  |  |  |  | $0.00 | Esta en taller, falta cortar dimensión exacta | 100
104 | CONJUNTO BASE | 1 | 1 | 0 | 0 | 50 |  |  | 2 |  |  |  |  |  | $0.00 |  | 50
105 | RESORTE | 1 | 1 | 1 | 1 | 100 |  |  |  |  |  |  |  |  | $0.00 |  | 100
106 | TAMBOR | 1 | 1 | 1 | 1 | 100 |  |  |  |  |  |  |  |  | $0.00 |  | 100
107 | XRU1008 | 1 | 1 | 1 | 1 | 100 |  |  |  |  |  |  |  |  | $0.00 |  | 100
108 | BISAGRA | 1 | 1 | 0 | 0 | 50 |  |  |  |  |  |  |  |  | $0.00 |  | 50
109 | CONTRA BISAGRA | 1 | 1 | 0 | 0 | 50 |  |  |  |  |  |  |  |  | $0.00 |  | 50
110 | SOPORTE MUSLO | 1 | 1 | 1 | 1 | 100 |  |  |  |  |  |  |  |  | $0.00 |  | 100
111 | SOPORTE COJIN | 1 | 1 | 0 | 0 | 50 |  |  |  |  |  |  |  |  | $0.00 |  | 50
112 |  |  |  |  |  | 0 |  |  |  |  |  |  |  |  | $0.00 |  | 0
113 |  |  |  |  |  | 0 |  |  |  |  |  |  |  |  | $0.00 |  | 0
124 |  |  |  |  |  | 0 |  |  |  |  |  |  |  |  | $0.00 |  | 0
124 |  |  |  |  |  | 0 |  |  |  |  |  |  |  |  | $0.00 |  | 0
124 |  |  |  |  |  | 0 |  |  |  |  |  |  |  |  | $0.00 |  | 0
124 |  |  |  |  |  | 0 |  |  |  |  |  |  |  |  | $0.00 |  | 0
124 |  |  |  |  |  | 0 |  |  |  |  |  |  |  |  | $0.00 |  | 0

Sheet: ACCESORIOS
SEGUIMIENTO DE FABRICACIÓN: ACCESORIOS
Proyecto No. |  | 1360 |  |  |  | Descripción | Exoesqueleto Waist Support
Fecha |  | 07.12.2021 |  |  |  | Cliente | KOTEOS |  |  | Realizó |  | M.Gutiérrez
0 |  |  |  |  |  |  | AVANCE TOTAL |  |  |  |  | 50.00 |  | % | TOTAL $ | $0.00
# SERIE | DENOMINACIÓN | AVANCE DE FABRICACIÓN |  |  |  |  | FOTO | Número de Dibujo Interno | Cantidad | Fecha INICIO | Fecha ESTIMADA | Fecha ENTREGA | Proveedor |  |  | Observaciones
 |  | Pedido | En proceso | Enviado | Recibido | TOTAL |  |  |  |  |  |  |  | Precio | Total
 |  | 25% | 50% | 75% | 100%
1 | RODILLERA | 1 | 1 | 1 | 1 | 100 |  |  |  |  |  |  |  |  | $0.00 |  | 100
2 | TEXTILES | X | X | X | X | 0 |  |  |  |  |  |  |  |  | $0.00 |  | 0
3 |  |  |  |  |  | 0 |  |  |  |  |  |  |  |  | $0.00 |  | 0
4 |  |  |  |  |  | 0 |  |  |  |  |  |  |  |  | $0.00 |  | 0
 |  |  |  |  |  | 0 |  |  |  |  |  |  |  |  | $0.00 |  | 0
 |  |  |  |  |  | 0 |  |  |  |  |  |  |  |  | $0.00 |  | 0
 |  |  |  |  |  | 0 |  |  |  |  |  |  |  |  | $0.00 |  | 0
 |  |  |  |  |  | 0 |  |  |  |  |  |  |  |  | $0.00 |  | 0
 |  |  |  |  |  | 0 |  |  |  |  |  |  |  |  | $0.00 |  | 0
 |  |  |  |  |  | 0 |  |  |  |  |  |  |  |  | $0.00 |  | 0
 |  |  |  |  |  | 0 |  |  |  |  |  |  |  |  | $0.00 |  | 0
 |  |  |  |  |  | 0 |  |  |  |  |  |  |  |  | $0.00 |  | 0
 |  |  |  |  |  | 0 |  |  |  |  |  |  |  |  | $0.00 |  | 0
 |  |  |  |  |  | 0 |  |  |  |  |  |  |  |  | $0.00 |  | 0
 |  |  |  |  |  | 0 |  |  |  |  |  |  |  |  | $0.00 |  | 0
 |  |  |  |  |  | 0 |  |  |  |  |  |  |  |  | $0.00 |  | 0
 |  |  |  |  |  | 0 |  |  |  |  |  |  |  |  | $0.00 |  | 0
 |  |  |  |  |  | 0 |  |  |  |  |  |  |  |  | $0.00
 |  |  |  |  |  | 0 |  |  |  |  |  |  |  |  | $0.00
 |  |  |  |  |  | 0 |  |  |  |  |  |  |  |  | $0.00
 |  |  |  |  |  | 0 |  |  |  |  |  |  |  |  | $0.00
 |  |  |  |  |  | 0 |  |  |  |  |  |  |  |  | $0.00
 |  |  |  |  |  | 0 |  |  |  |  |  |  |  |  | $0.00
 |  |  |  |  |  | 0 |  |  |  |  |  |  |  |  | $0.00
 |  |  |  |  |  | 0 |  |  |  |  |  |  |  |  | $0.00
 |  |  |  |  |  | 0 |  |  |  |  |  |  |  |  | $0.00
 |  |  |  |  |  | 0 |  |  |  |  |  |  |  |  | $0.00
 |  |  |  |  |  | 0 |  |  |  |  |  |  |  |  | $0.00

Sheet: TORNILLERÍA
SEGUIMIENTO DE FABRICACIÓN: TORNILLERÍA
Proyecto No. |  | 1360 |  |  |  | Descripción | Exoesqueleto Waist Support
Fecha |  | 07.12.2021 |  |  |  | Cliente | KOTEOS |  |  | Realizó |  | M.Gutiérrez
0 |  |  |  |  |  |  | AVANCE TOTAL |  |  |  |  | 50.00 |  | % | TOTAL $ | $0.00
# SERIE | DENOMINACIÓN | AVANCE DE FABRICACIÓN |  |  |  |  | FOTO | Número de Dibujo Interno | Cantidad | Fecha INICIO | Fecha ESTIMADA | Fecha ENTREGA | Proveedor |  |  | Observaciones
 |  | Pedido | En proceso | Enviado | Recibido | TOTAL |  |  |  |  |  |  |  | Precio | Total
 |  | 25% | 50% | 75% | 100%
1 | TORNILLERIA | 1 | 1 | 0 | 0 | 50 |  |  |  |  |  |  |  |  | $0.00 |  | 50
 |  |  |  |  |  | 0 |  |  |  |  |  |  |  |  | $0.00 |  | 0
 |  |  |  |  |  | 0 |  |  |  |  |  |  |  |  | $0.00 |  | 0
 |  |  |  |  |  | 0 |  |  |  |  |  |  |  |  | $0.00 |  | 0
 |  |  |  |  |  | 0 |  |  |  |  |  |  |  |  | $0.00 |  | 0
 |  |  |  |  |  | 0 |  |  |  |  |  |  |  |  | $0.00 |  | 0
 |  |  |  |  |  | 0 |  |  |  |  |  |  |  |  | $0.00 |  | 0
 |  |  |  |  |  | 0 |  |  |  |  |  |  |  |  | $0.00 |  | 0
 |  |  |  |  |  | 0 |  |  |  |  |  |  |  |  | $0.00 |  | 0
 |  |  |  |  |  | 0 |  |  |  |  |  |  |  |  | $0.00 |  | 0
 |  |  |  |  |  | 0 |  |  |  |  |  |  |  |  | $0.00 |  | 0
 |  |  |  |  |  | 0 |  |  |  |  |  |  |  |  | $0.00 |  | 0
 |  |  |  |  |  | 0 |  |  |  |  |  |  |  |  | $0.00 |  | 0
 |  |  |  |  |  | 0 |  |  |  |  |  |  |  |  | $0.00 |  | 0
 |  |  |  |  |  | 0 |  |  |  |  |  |  |  |  | $0.00 |  | 0
 |  |  |  |  |  | 0 |  |  |  |  |  |  |  |  | $0.00 |  | 0
 |  |  |  |  |  | 0 |  |  |  |  |  |  |  |  | $0.00 |  | 0
 |  |  |  |  |  | 0 |  |  |  |  |  |  |  |  | $0.00
 |  |  |  |  |  | 0 |  |  |  |  |  |  |  |  | $0.00
 |  |  |  |  |  | 0 |  |  |  |  |  |  |  |  | $0.00
 |  |  |  |  |  | 0 |  |  |  |  |  |  |  |  | $0.00
 |  |  |  |  |  | 0 |  |  |  |  |  |  |  |  | $0.00
 |  |  |  |  |  | 0 |  |  |  |  |  |  |  |  | $0.00
 |  |  |  |  |  | 0 |  |  |  |  |  |  |  |  | $0.00
 |  |  |  |  |  | 0 |  |  |  |  |  |  |  |  | $0.00
 |  |  |  |  |  | 0 |  |  |  |  |  |  |  |  | $0.00
 |  |  |  |  |  | 0 |  |  |  |  |  |  |  |  | $0.00
 |  |  |  |  |  | 0 |  |  |  |  |  |  |  |  | $0.00
 |  |  |  |  |  | 0 |  |  |  |  |  |  |  |  | $0.00
