koteos/RANDOM/10-EKOT-1074-170619A-UBF-PI/V1.4_SE_FABRICO/FAB/CORTE_DOBLEZ/1074.000.000.000.ENSAMBLE_GENERAL_Y01.dxf

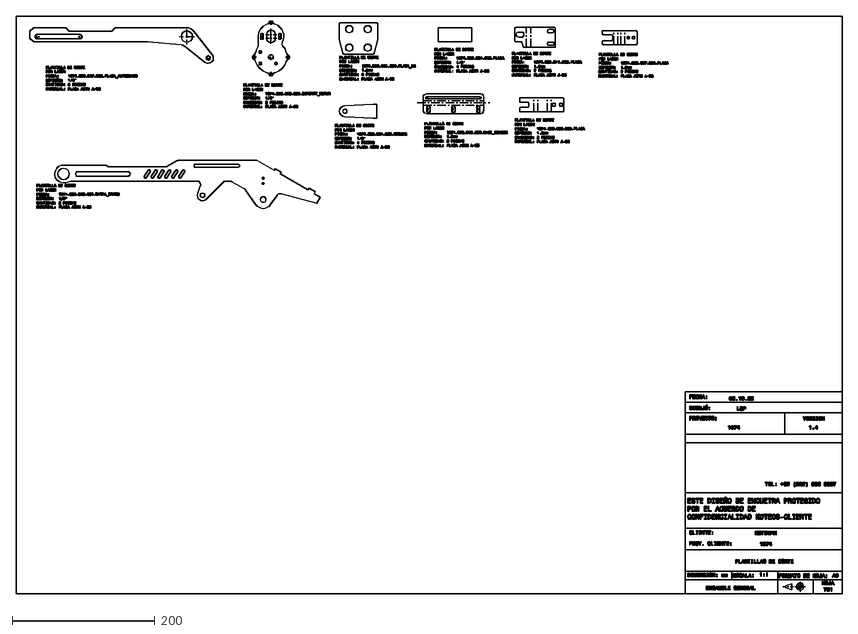
[picture p93: CAD file, 2026-03-17]
10-EKOT-1074-170619A-UBF-PI/V1.4_SE_FABRICO/FAB/CORTE_DOBLEZ/1074.000.000.000.ENSAMBLE_GENERAL_Y01.dxf
1159.0 x 810.8
