koteos/RANDOM/EKOT-1360-170921A-LEXA_WAIST_SUPPORT/3DN/1360.000.000.000.ENSAMBLE_GENERAL.stp

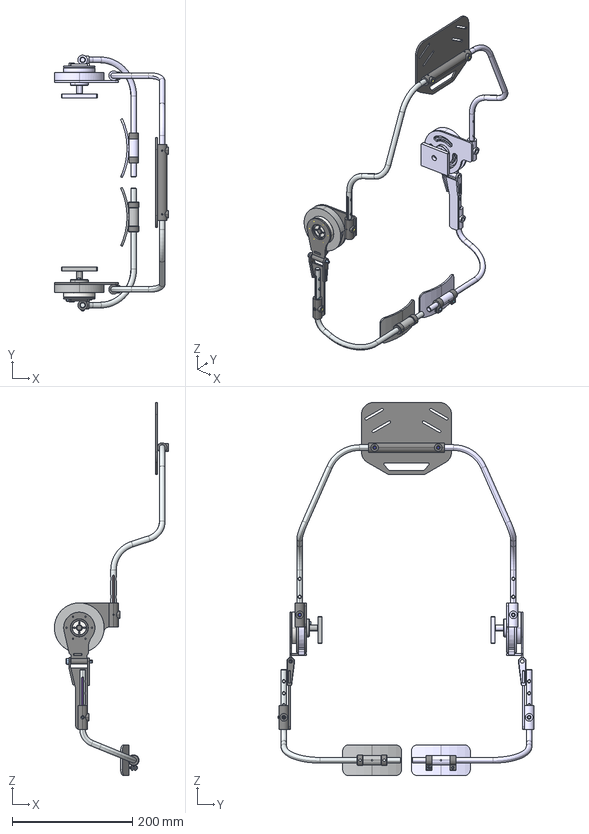
[picture p94: CAD file, 2026-03-27]
EKOT-1360-170921A-LEXA_WAIST_SUPPORT/3DN/1360.000.000.000.ENSAMBLE_GENERAL.stp
190.3 x 425.9 x 621.1 mm
1360.000.001.001.BASE
1360.000.001.002.REDONDO
1360.000.001.003.TOPE
1360.000.007.004.001.BUJE.1
1360.000.007.004.002.BROCHE_TALLA
1360.000.002.000.RESORTE_HELICOIDAL
1360.000.003.000.TAMBOR
1360.000.004.001.BISAGRA
1360.000.004.003.BISAGRA_BUJE
EJES x 2
1360.000.004.002.BISAGRA_TOPE
1360.000.005.001.PLACA
1360.000.005.002.PLACA
1360.000.005.003.SM
1360.000.007.004.001.BUJE
1360.000.005.004.002.REDONDO
1360.000.006.000.SOPORTE_MUSLO
1360.000.007.001.ROLADO_COJIN
1360.000.007.002.BUJE
1360.000.008.001.TUBO
1360.000.008.002.PLACA_PECHO
1360.000.008.003.BUJE_TALLA
1360.000.008.003.REDONDO x 2
Symmetry of 1360.000.008.001.TUBO
1360.000.009.000.COP_CADERA
1360.000.010.000.PLACA_FAJA
1360.000.011.000.BUJE_AJUSTE x 2
1360.000.012.000.ABRAZADERA x 2
item_8000760_tornillo_gota_de_sebo_m3x8_detalle_3 x 2
tornillo_iso_7379-m5x30
tornillo_din_7991-m3x10-8_8
din_912-m3x0_5-30-10_9
tornillo_iso_7380-m4x10-12_9
X RU1008 CRBF108 AT UU CC0P5 Cross Roller Bearing (DISCO_EXTERIOR)
X RU1008 CRBF108 AT UU CC0P5 Cross Roller Bearing (DISCO_INTERIOR)
X RU1008 CRBF108 AT UU CC0P5 Cross Roller Bearing (EMPAQUE)
Symmetry of 1360.000.010.000.PLACA_FAJA
Symmetry of 1360.000.009.000.COP_CADERA
Symmetry of 1360.000.001.001.BASE
Symmetry of 1360.000.001.002.REDONDO
Symmetry of 1360.000.001.003.TOPE
Symmetry of 1360.000.007.004.001.BUJE.1
Symmetry of 1360.000.007.004.002.BROCHE_TALLA
Symmetry of 1360.000.002.000.RESORTE_HELICOIDAL
Symmetry of 1360.000.003.000.TAMBOR
Symmetry of 1360.000.004.001.BISAGRA
Symmetry of 1360.000.004.003.BISAGRA_BUJE
Symmetry of EJES
Symmetry of 1360.000.004.002.BISAGRA_TOPE
Symmetry of 1360.000.005.001.PLACA
Symmetry of 1360.000.005.002.PLACA
Symmetry of 1360.000.005.003.SM
Symmetry of 1360.000.007.004.001.BUJE
Symmetry of 1360.000.005.004.002.REDONDO
Symmetry of 1360.000.006.000.SOPORTE_MUSLO
Symmetry of 1360.000.007.001.ROLADO_COJIN
Symmetry of 1360.000.007.002.BUJE
Symmetry of X RU1008 CRBF108 AT UU CC0P5 Cross Roller Bearing (DISCO_EXTERIOR)
Symmetry of X RU1008 CRBF108 AT UU CC0P5 Cross Roller Bearing (DISCO_INTERIOR)
Symmetry of X RU1008 CRBF108 AT UU CC0P5 Cross Roller Bearing (EMPAQUE)
