koteos/RANDOM/10-EKOT-1074-170619A-UBF-PI/V1.4_SE_FABRICO/FAB/IMPRESION/1074.000.016.000.TAPA_MOTOR.stp

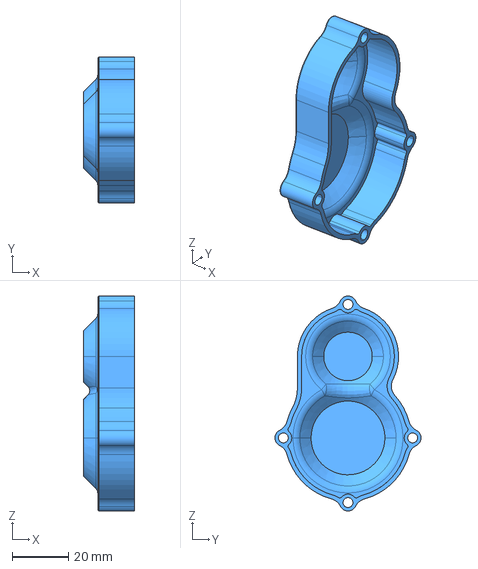
[picture p95: CAD file, 2026-03-17]
10-EKOT-1074-170619A-UBF-PI/V1.4_SE_FABRICO/FAB/IMPRESION/1074.000.016.000.TAPA_MOTOR.stp
18.0 x 52.0 x 76.5 mm
