koteos/RANDOM/10-EKOT-1074-170619A-UBF-PI/V1.4_SE_FABRICO/FAB/MAQUINADO_SOLDADURA/1074.000.026.000.BRAZO.igs

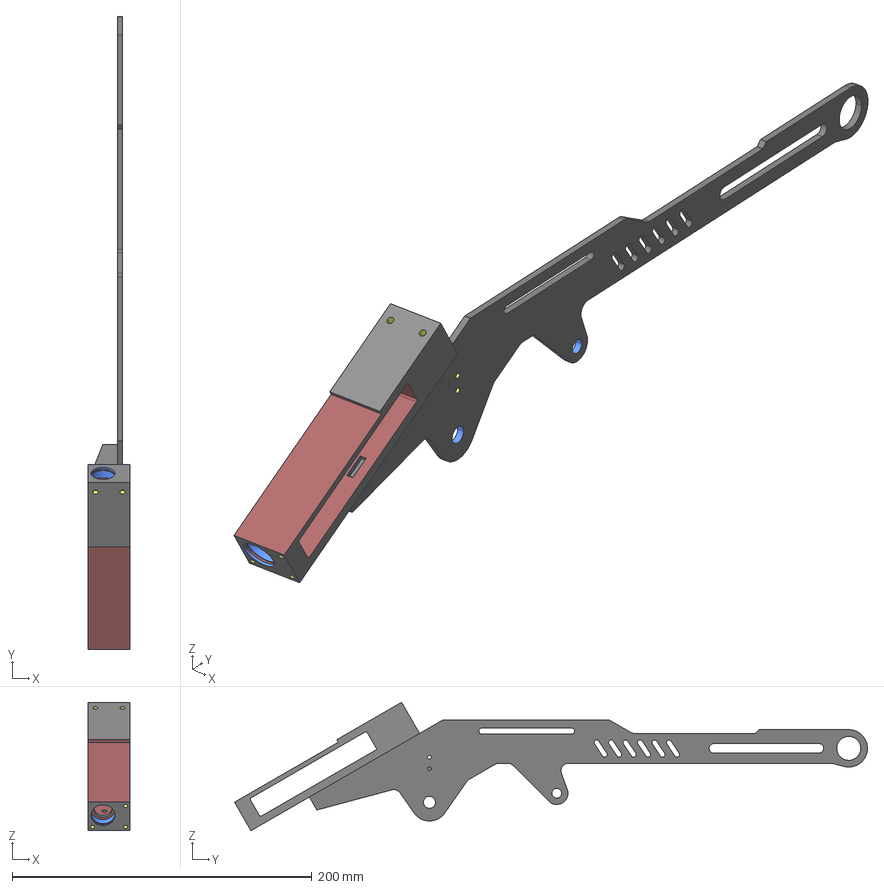
[picture p96: CAD file, 2026-03-17]
10-EKOT-1074-170619A-UBF-PI/V1.4_SE_FABRICO/FAB/MAQUINADO_SOLDADURA/1074.000.026.000.BRAZO.igs
28.0 x 422.7 x 85.8 mm
