koteos/RANDOM/10-EKOT-1074-170619A-UBF-PI/V1.5_CON_TAPAS_MOTOR/FAB/MAQUINADO_SOLDADURA/1074.000.028.000.TUERCA_HUSILLO1.igs

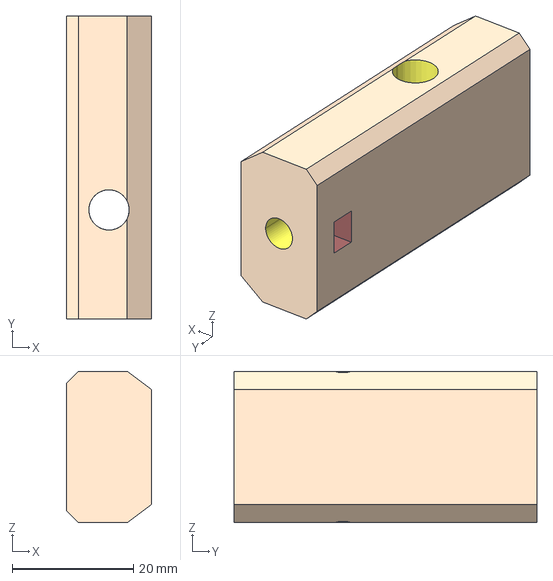
[picture p97: CAD file, 2026-03-17]
10-EKOT-1074-170619A-UBF-PI/V1.5_CON_TAPAS_MOTOR/FAB/MAQUINADO_SOLDADURA/1074.000.028.000.TUERCA_HUSILLO1.igs
14.0 x 50.0 x 25.0 mm
