koteos/RANDOM/10-EKOT-1074-170619A-UBF-PI/V1.6_PANACEA/PIEZA_26.dxf

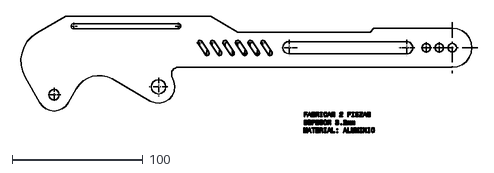
[picture p98: CAD file, 2026-03-27]
10-EKOT-1074-170619A-UBF-PI/V1.6_PANACEA/PIEZA_26.dxf
353.5 x 89.0
