koteos/RANDOM/10-EKOT-1074-170619A-UBF-PI/V1.8_PANACEA_LIGTH/FAB/CORTE_DOBLEZ/1074.000.000.000.1_Y01.dxf

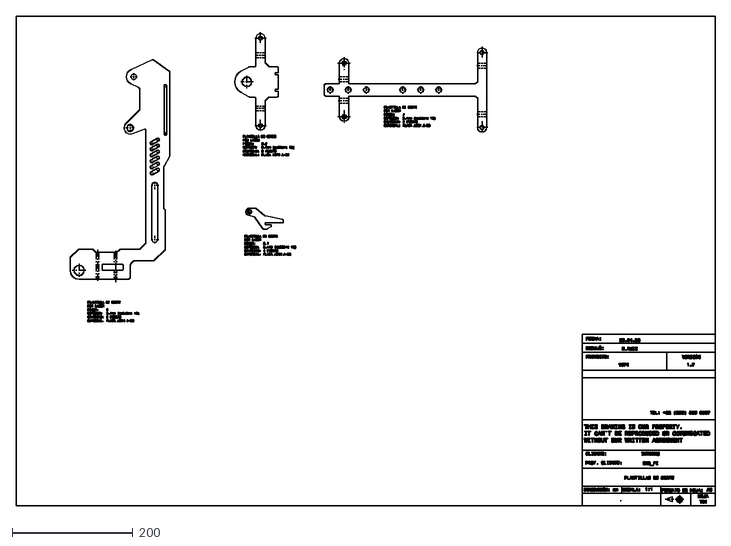
[picture p99: CAD file, 2026-04-23]
10-EKOT-1074-170619A-UBF-PI/V1.8_PANACEA_LIGTH/FAB/CORTE_DOBLEZ/1074.000.000.000.1_Y01.dxf
1159.0 x 810.8
