koteos/RANDOM/EKOT-1360-170921A-LEXA_WAIST_SUPPORT/3DN/1360.001.000.000.SOPORTE_POLEA_PIERNA_VERSION_LIGAS.stp

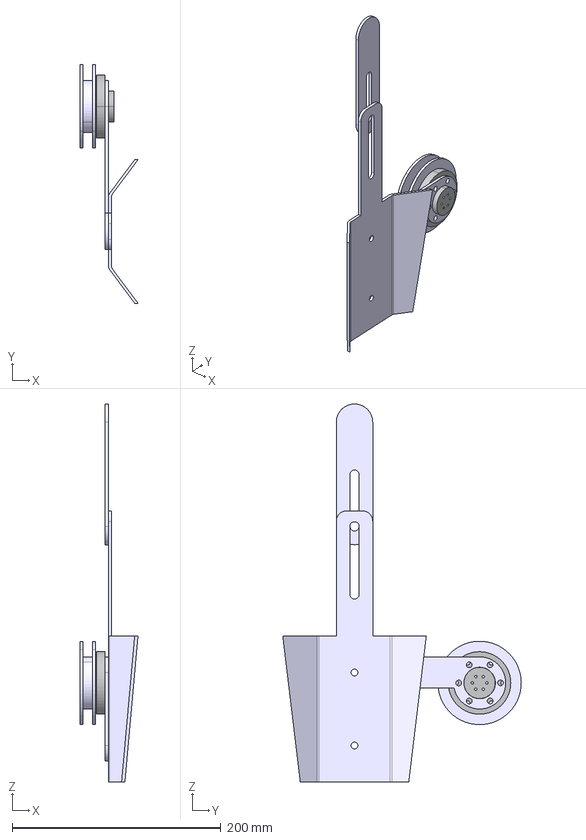
[picture p100: CAD file, 2026-03-27]
EKOT-1360-170921A-LEXA_WAIST_SUPPORT/3DN/1360.001.000.000.SOPORTE_POLEA_PIERNA_VERSION_LIGAS.stp
55.6 x 228.7 x 362.5 mm
1360.001.001.000.SOPORTE_PIERNA
1360.001.002.000.ESLABON
1360.001.003.000.SOPORTE_POLEA
1360.001.004.000.POLEA
1069F.201.001.000.ANILLO_EXTERIOR
1069F.201.002.000.BUJE x 2
1069F.201.003.000.NUCLEO_ENTERO.1
1069F.201.004.000.TAPA
