koteos/RANDOM/EKOT-1360-170921A-LEXA_WAIST_SUPPORT/DXF/1360.000.000.000.C.WAIST_SUPPORT_Y01.dxf

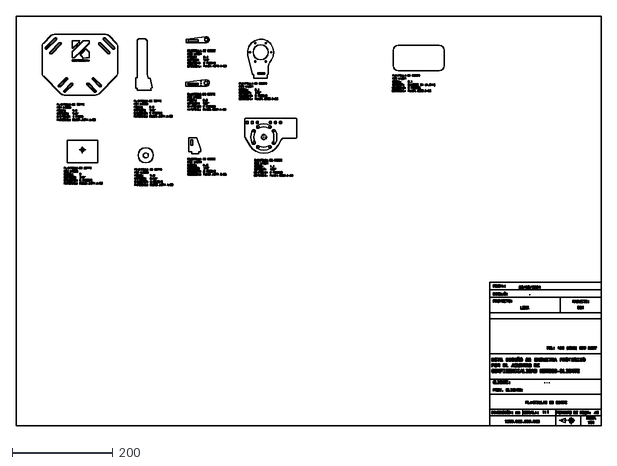
[picture p101: CAD file, 2026-03-27]
EKOT-1360-170921A-LEXA_WAIST_SUPPORT/DXF/1360.000.000.000.C.WAIST_SUPPORT_Y01.dxf
1159.0 x 810.8
