koteos/RANDOM/EKOT-1360-170921A-LEXA_WAIST_SUPPORT/FAB/FAB_A/1360 CORTE/PLANTILLA DE CORTE PLACA PECHO.dxf

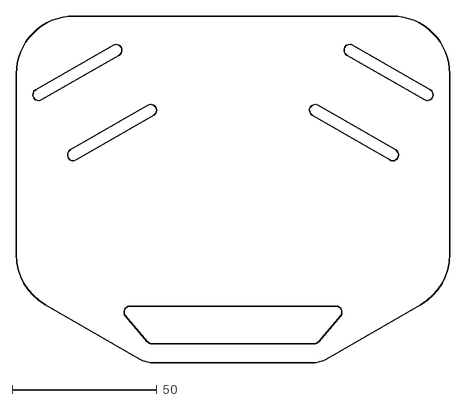
[picture p102: CAD file, 2026-03-27]
EKOT-1360-170921A-LEXA_WAIST_SUPPORT/FAB/FAB_A/1360 CORTE/PLANTILLA DE CORTE PLACA PECHO.dxf
150.0 x 120.0
