koteos/RANDOM/EKOT-1360-170921A-LEXA_WAIST_SUPPORT/FAB/FAB_A/1360 PLANOS DE FABRICACION/FAB/FAB/1360.000.007.000.SOPORTE_COJIN.stp

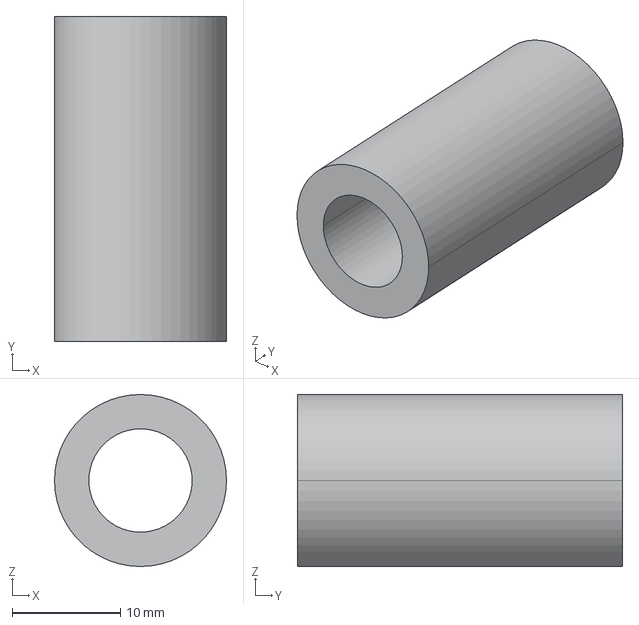
[picture p103: CAD file, 2026-03-27]
EKOT-1360-170921A-LEXA_WAIST_SUPPORT/FAB/FAB_A/1360 PLANOS DE FABRICACION/FAB/FAB/1360.000.007.000.SOPORTE_COJIN.stp
15.9 x 30.0 x 15.9 mm
