koteos/RANDOM/EKOT-1360-170921A-LEXA_WAIST_SUPPORT/FAB/FAB_A/2D FINAL VERSION/1360 PLANTILLAS DE CORTE/1360 PLANTILLAS DE CORTE DXF/1360.000.010.000.PLACA_FAJA.dxf

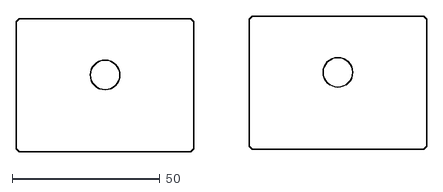
[picture p104: CAD file, 2026-03-27]
EKOT-1360-170921A-LEXA_WAIST_SUPPORT/FAB/FAB_A/2D FINAL VERSION/1360 PLANTILLAS DE CORTE/1360 PLANTILLAS DE CORTE DXF/1360.000.010.000.PLACA_FAJA.dxf
138.7 x 45.9
