koteos/RANDOM/EKOT-1360-170921A-LEXA_WAIST_SUPPORT/FAB/FAB_B/1360.000.006.000.SOPORTE_MUSLO.stp

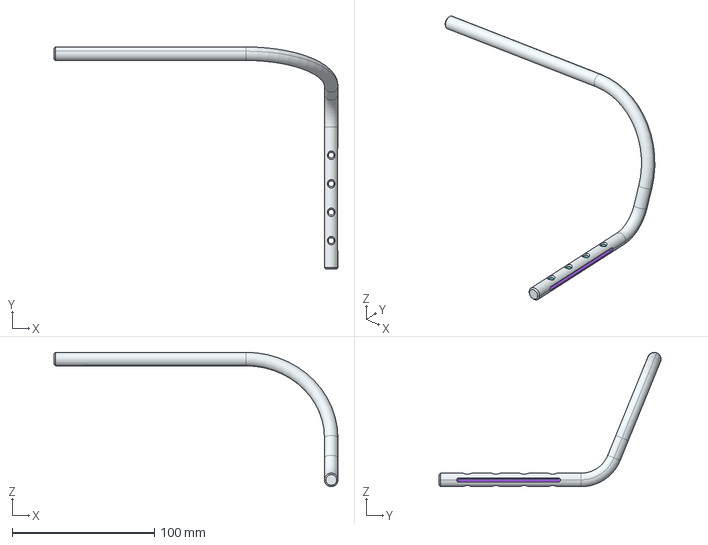
[picture p105: CAD file, 2026-03-27]
EKOT-1360-170921A-LEXA_WAIST_SUPPORT/FAB/FAB_B/1360.000.006.000.SOPORTE_MUSLO.stp
199.8 x 156.2 x 94.5 mm
