koteos/RANDOM/EKOT-1360-170921A-LEXA_WAIST_SUPPORT/FAB/FAB_C/PDF/MAQUINADO/1360.000.011.000.BUJE_AJUSTE.stp

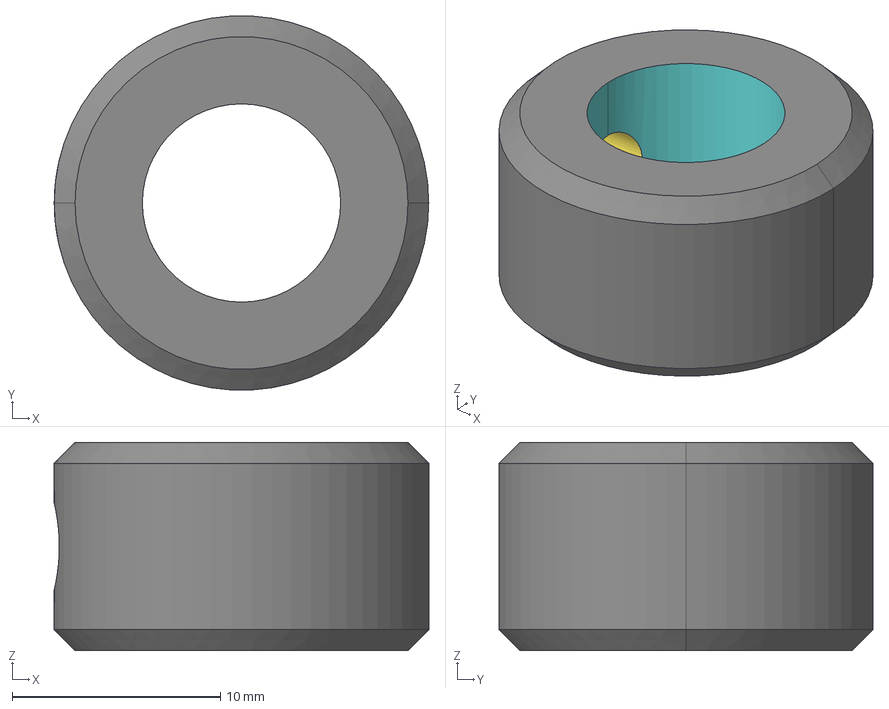
[picture p106: CAD file, 2026-03-27]
EKOT-1360-170921A-LEXA_WAIST_SUPPORT/FAB/FAB_C/PDF/MAQUINADO/1360.000.011.000.BUJE_AJUSTE.stp
18.0 x 18.0 x 10.0 mm
