koteos/RANDOM/EKOT-1360-170921A-LEXA_WAIST_SUPPORT/V.06/3D/1360.000.004.003.BISAGRA_BUJE_2.stp

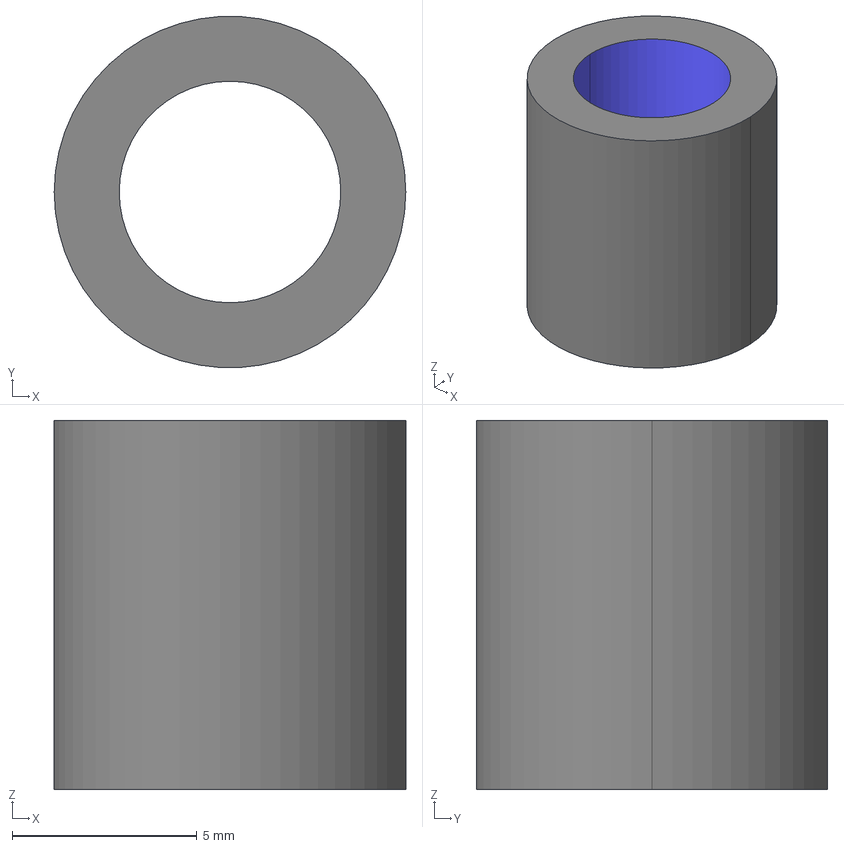
[picture p107: CAD file, 2026-03-27]
EKOT-1360-170921A-LEXA_WAIST_SUPPORT/V.06/3D/1360.000.004.003.BISAGRA_BUJE_2.stp
9.53 x 9.51 x 10.0 mm
