koteos/RANDOM/meca/DS3225MG Servo 25Kg 4.8-6.8V.stp

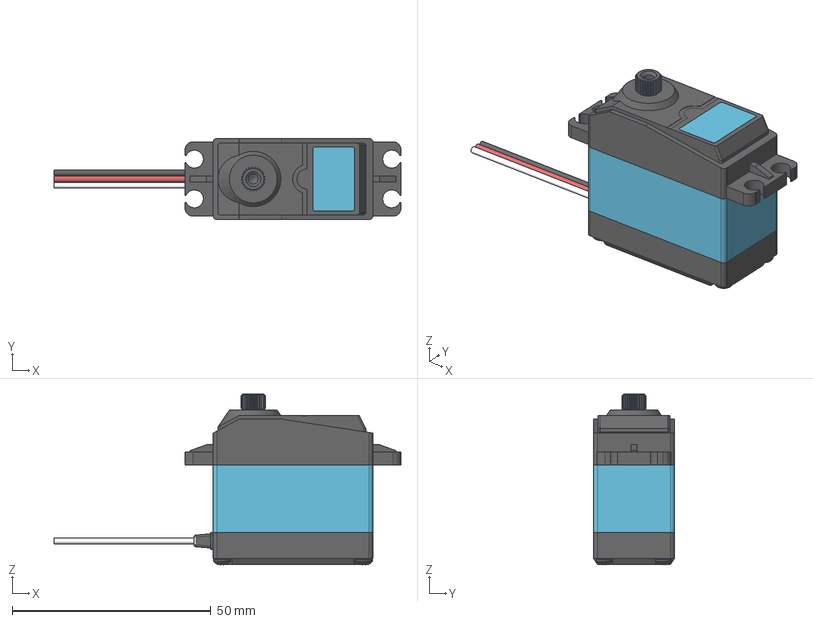
[picture p108: CAD file, 2026-04-16]
meca/DS3225MG Servo 25Kg 4.8-6.8V.stp
87.3 x 20.4 x 42.9 mm
DS3225MG Servo 25Kg 4.8-6.8V B
DS3225MG Servo 25Kg 4.8-6.8V A
DS3225MG Servo 25Kg 4.8-6.8V C
