koteos/RANDOM/PIMP-1889-250226A-AWARETRACK/V1.0/3D/Iot.step

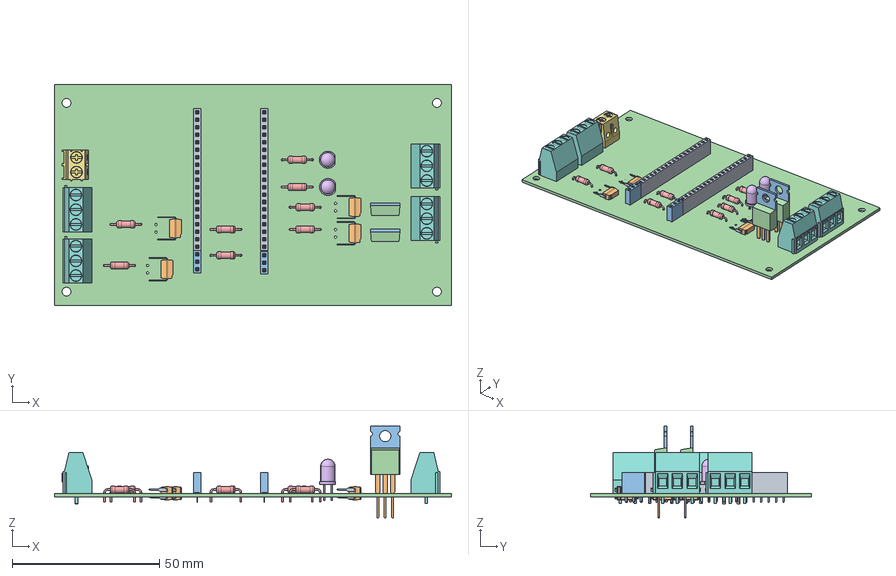
[picture p109: CAD file, 2026-04-24]
PIMP-1889-250226A-AWARETRACK/V1.0/3D/Iot.step
135.0 x 75.0 x 31.2 mm
PinSocket_1x19_P2.54mm_Vertical-0db596d1-55c3-28c1-18af-f82cbaa1225c x 2
IRFZ44N-4d37f16c-336c-42d5-8360-7415362b12d3 x 2
R_Axial_DIN0207_L6.3mm_D2.5mm_P10.16mm_ Horizontal-5166aa6c-8f45-0fb1-e29e-71f9febf2783 x 8
LED_D5.0mm_Clear-05f4eba5-0c33-40eb-93a9-e309eb9c0945 x 2
TerminalBlock_Phoenix_PT-1-5-2-5.0-H_1x02_P5.00mm_ Horizontal-2d875738-b5fe-9cfa-1978-01004715d104
TerminalBlock_Phoenix_MKDS-1-5-3_1x03_P5.00mm_ Horizontal-2d2700c7-ca6f-310f-d351-b4efa0657d20 x 4
PC817C-62996353-893c-e76a-cdd7-db5e73d3f657 x 4
PinSocket_1x03_P2.54mm_Vertical-a906dbb4-6de9-a0dc-971a-3532e6a25d7b x 2
input_PCB
