koteos/RANDOM/PIMP-1889-250226A-AWARETRACK/V1.0/FAB/IMP/1889.000.007.000.BASE_2_PCB_MONTAJE.stl

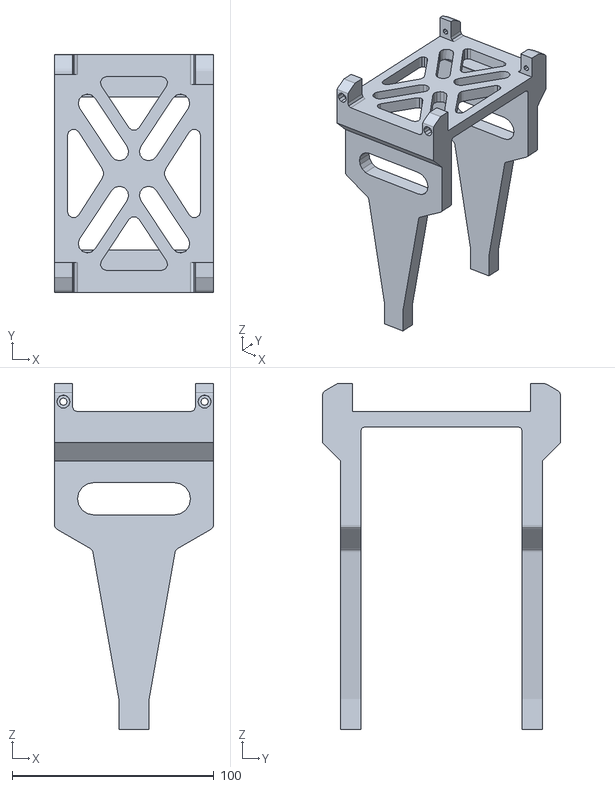
[picture p110: CAD file, 2026-06-07]
PIMP-1889-250226A-AWARETRACK/V1.0/FAB/IMP/1889.000.007.000.BASE_2_PCB_MONTAJE.stl
79.0 x 118.0 x 171.5
