koteos/RANDOM/PIMP-1889-250226A-AWARETRACK/V1.0/FAB/MAQ/1889.000.001.000.CASE_FEMALE.stp

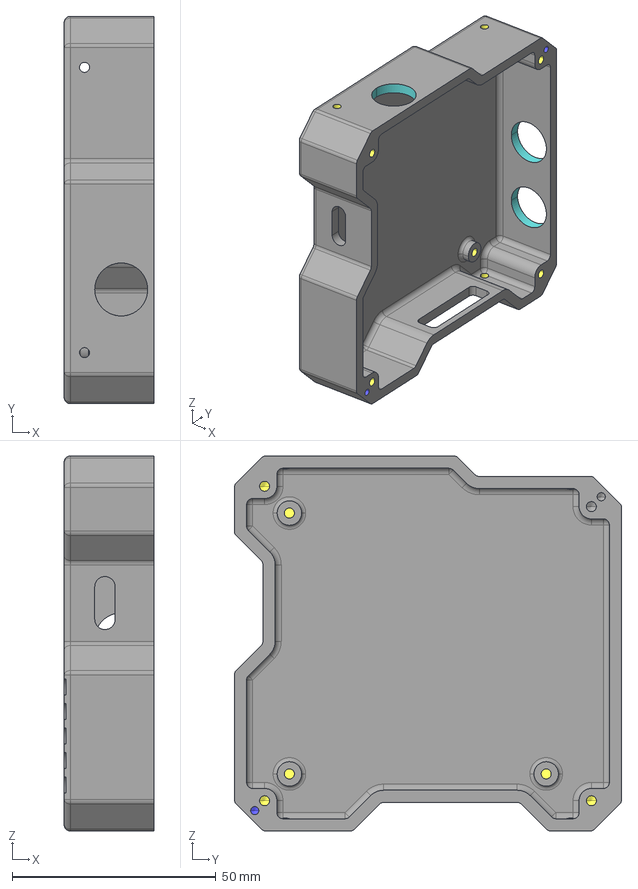
[picture p111: CAD file, 2026-04-27]
PIMP-1889-250226A-AWARETRACK/V1.0/FAB/MAQ/1889.000.001.000.CASE_FEMALE.stp
22.0 x 95.0 x 92.0 mm
