koteos/RANDOM/Self Balancing Robot Files/STL Files/Standoffs 1.stl

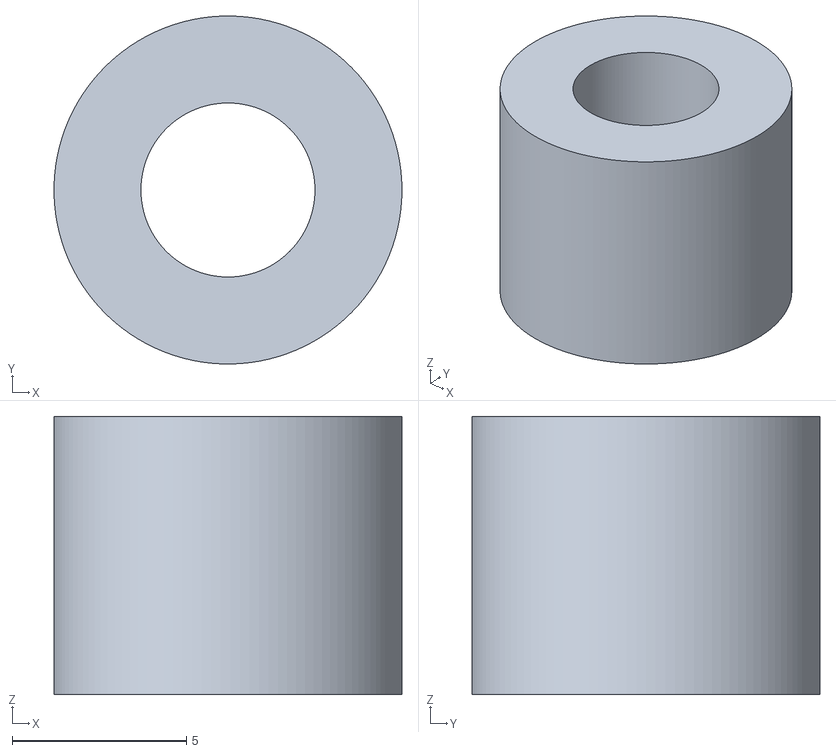
[picture p112: CAD file, 2025-05-05]
Self Balancing Robot Files/STL Files/Standoffs 1.stl
10.00 x 10.00 x 8.00
