koteos/RANDOM/sign2.dxf

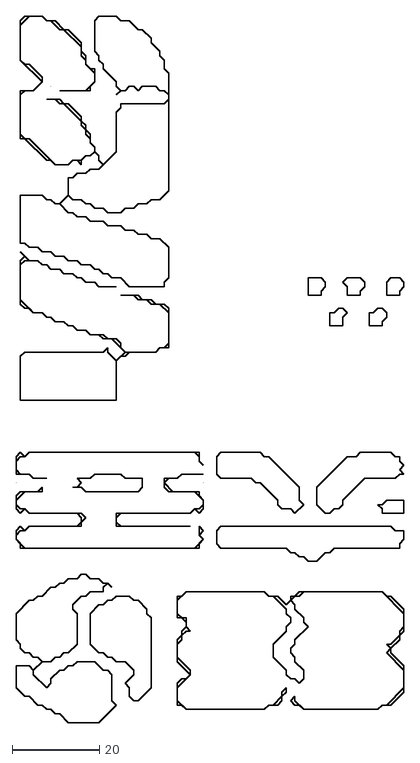
[picture p113: CAD file, 2025-05-05]
sign2.dxf
89.0 x 162.0
