koteos/RANDOM/10-EKOT-1074-170619A-UBF-PI/V1.4_SE_FABRICO/FAB/MAQUINADO_SOLDADURA/1074.000.025.000.REDONDO_ROTULA.igs

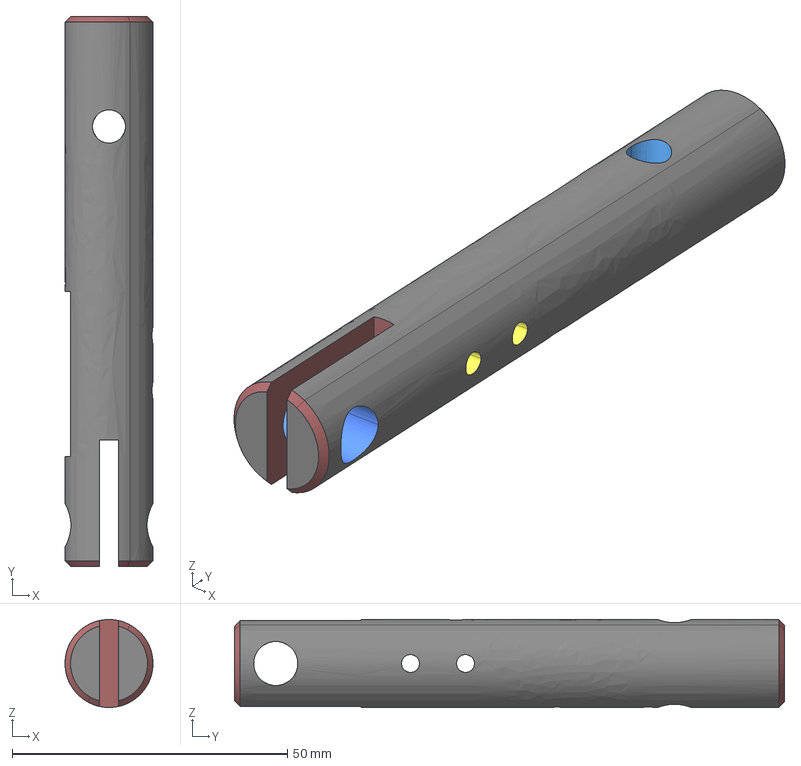
[picture p114: CAD file, 2026-03-17]
10-EKOT-1074-170619A-UBF-PI/V1.4_SE_FABRICO/FAB/MAQUINADO_SOLDADURA/1074.000.025.000.REDONDO_ROTULA.igs
16.0 x 100.0 x 16.0 mm
