koteos/RANDOM/10-EKOT-1074-170619A-UBF-PI/V1.6_PANACEA/2674_SG-M10.stp

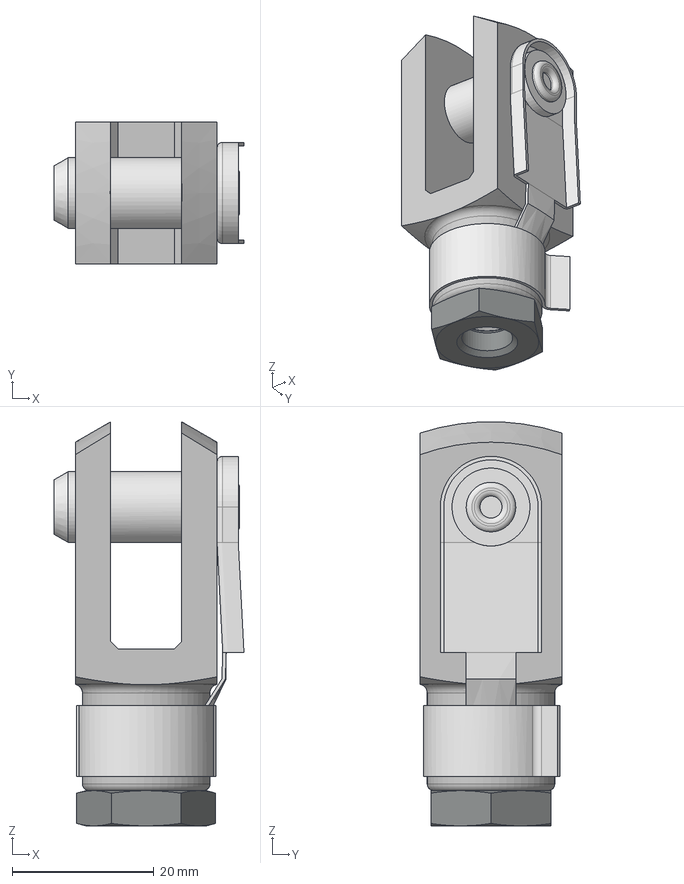
[picture p115: CAD file, 2026-03-17]
10-EKOT-1074-170619A-UBF-PI/V1.6_PANACEA/2674_SG-M10.stp
26.8 x 20.0 x 57.0 mm
2674 SG-M10---(GK)
DIN-439-B - M10(F)
200063 FKB-10X20
