koteos/RANDOM/contornos.dxf

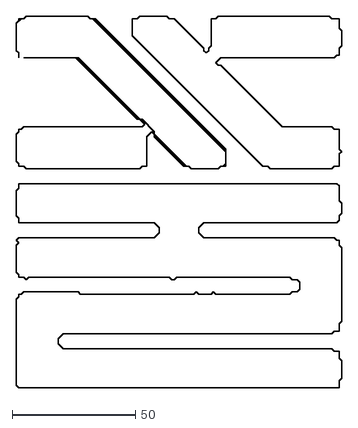
[picture p116: CAD file, 2025-05-05]
contornos.dxf
132.0 x 151.0
