koteos/RANDOM/EKOT-1360-170921A-LEXA_WAIST_SUPPORT/FAB/FAB_A/1360 CORTE/1360.000.004.001.BISAGRA.stp

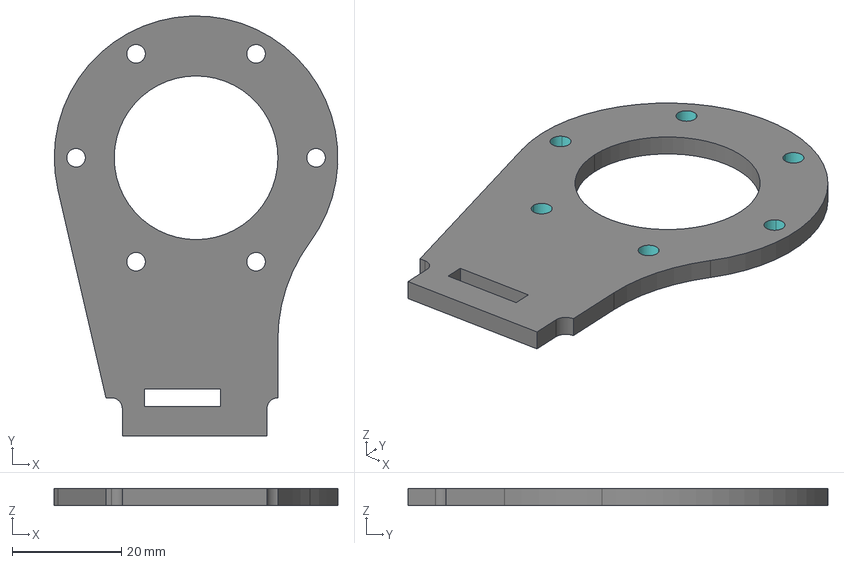
[picture p117: CAD file, 2026-03-27]
EKOT-1360-170921A-LEXA_WAIST_SUPPORT/FAB/FAB_A/1360 CORTE/1360.000.004.001.BISAGRA.stp
52.0 x 77.0 x 3.18 mm
