koteos/RANDOM/EKOT-1360-170921A-LEXA_WAIST_SUPPORT/FAB/FAB_A/1360 PLANOS DE FABRICACION/FAB/FAB/1360.000.003.000.TAMBOR.stp

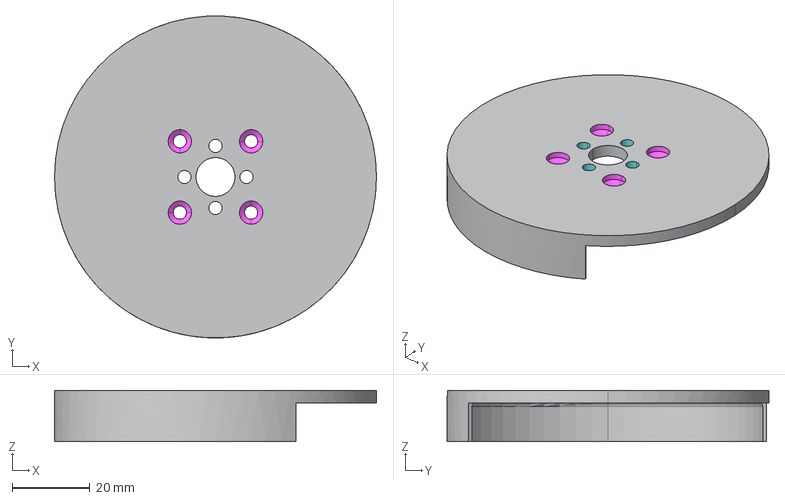
[picture p118: CAD file, 2026-03-27]
EKOT-1360-170921A-LEXA_WAIST_SUPPORT/FAB/FAB_A/1360 PLANOS DE FABRICACION/FAB/FAB/1360.000.003.000.TAMBOR.stp
83.0 x 83.0 x 13.2 mm
