koteos/RANDOM/EKOT-1360-170921A-LEXA_WAIST_SUPPORT/FAB/FAB_A/2D FINAL VERSION/1360 PLANTILLAS DE CORTE/1360 PLANTILLAS DE CORTE DXF/PLANTILLA DE CORTE 1360 WAIST.dxf

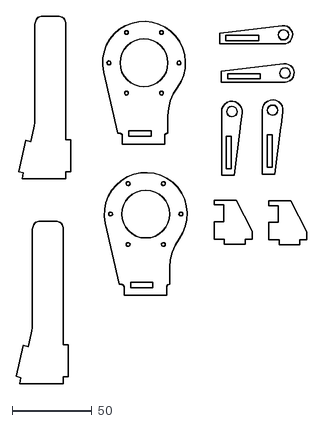
[picture p119: CAD file, 2026-03-27]
EKOT-1360-170921A-LEXA_WAIST_SUPPORT/FAB/FAB_A/2D FINAL VERSION/1360 PLANTILLAS DE CORTE/1360 PLANTILLAS DE CORTE DXF/PLANTILLA DE CORTE 1360 WAIST.dxf
182.4 x 230.5
