koteos/RANDOM/EKOT-1360-170921A-LEXA_WAIST_SUPPORT/FAB/FAB_C/PDF/MAQUINADO/1360.000.010.000.ENGRAE.stp

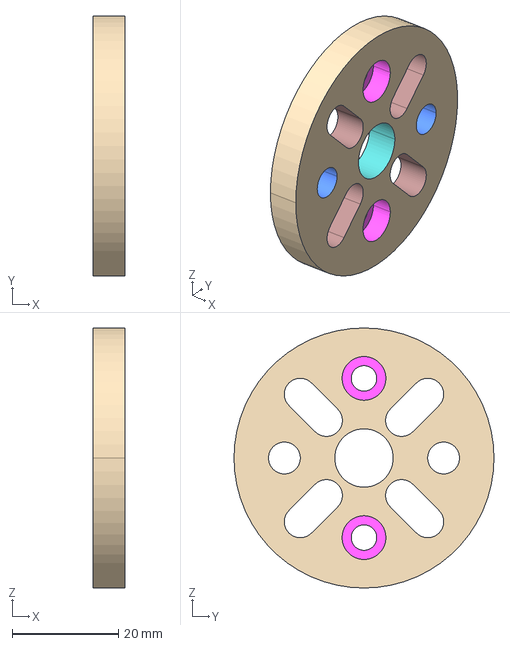
[picture p120: CAD file, 2026-03-27]
EKOT-1360-170921A-LEXA_WAIST_SUPPORT/FAB/FAB_C/PDF/MAQUINADO/1360.000.010.000.ENGRAE.stp
6.00 x 49.0 x 49.0 mm
