koteos/RANDOM/EKOT-1360-170921A-LEXA_WAIST_SUPPORT/V.06/3D/1360.000.004.001.SIMETRIA_BISAGRA.stp

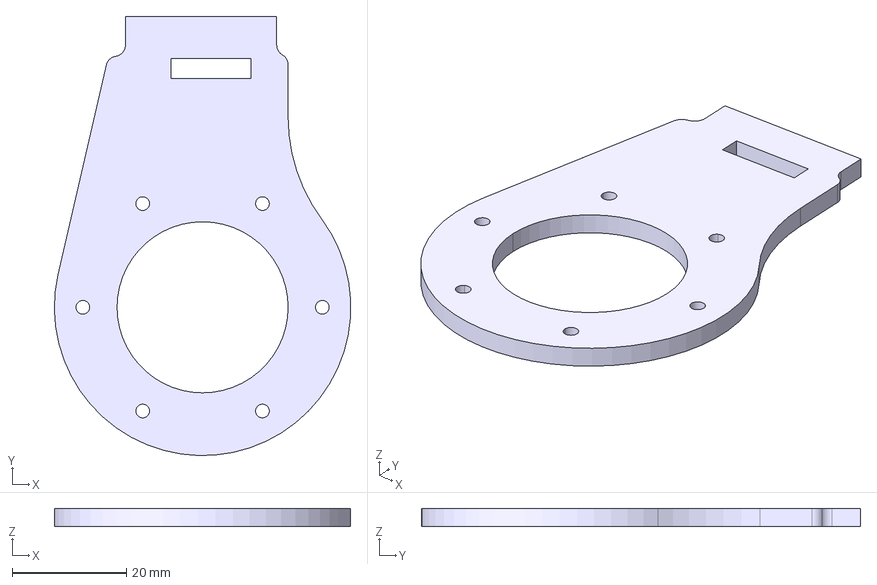
[picture p121: CAD file, 2026-03-27]
EKOT-1360-170921A-LEXA_WAIST_SUPPORT/V.06/3D/1360.000.004.001.SIMETRIA_BISAGRA.stp
52.0 x 77.0 x 3.18 mm
