koteos/RANDOM/PIMP-1889-250226A-AWARETRACK/V1.0/3D/PCB_REF.step

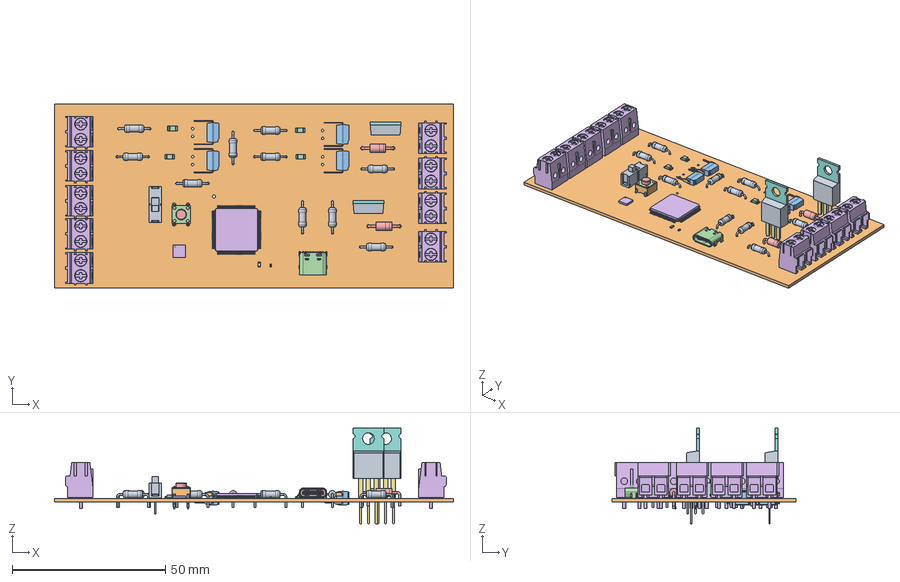
[picture p122: CAD file, 2026-04-23]
PIMP-1889-250226A-AWARETRACK/V1.0/3D/PCB_REF.step
130.0 x 60.0 x 31.2 mm
R_Axial_DIN0207_L6.3mm_D2.5mm_P10.16mm_ Horizontal-5166aa6c-8f45-0fb1-e29e-71f9febf2783 x 10
PC817C-62996353-893c-e76a-cdd7-db5e73d3f657 x 4
LED_1206_3216Metric-485a2445-00ce-3ac5-f31c-eaeb511a541f x 4
D_DO-41_SOD81_P10.16mm_Horizontal-65efd259-b7a1-01ec-8197-4aadee25570c x 2
TerminalBlock_Phoenix_PT-1-5-2-5.0-H_1x02_P5.00mm_ Horizontal-3D-eb60da0b-d3be-fbfa-3bab-c3a3de31dae9 x 9
IRFZ44N-4d37f16c-336c-42d5-8360-7415362b12d3 x 2
TS6-THT_H-5.0-a60c15cd-2c66-47f2-b23b-38e66273c034
LQFP-100_14x14mm_P0.5mm-3D-e05139a7-b315-2cf6-a5a7-8c1b7e4da9ad
USB4105GFA_USB4105GFA
QFN-24-1EP_4x4mm_P0.5mm_ EP2.6x2.6mm-dbd4e911-9064-217b-1aeb-9a9a2d840735
3DSMD_0603_1608Metric-e9e0c079-dac5-361b-03ae-a1496ca997ab
3DSMD_0402_1005Metric-d919a960-746f-c955-fbea-1b7ba0394ff3
EG1218-d69fe676-55df-43e3-b9d4-cdf9e30d4cab
input_PCB
