koteos/RANDOM/PIMP-1889-250226A-AWARETRACK/V1.0/FAB/IMP/1889.000.008.000.BASE_3_PCB_MONTAJE.stl

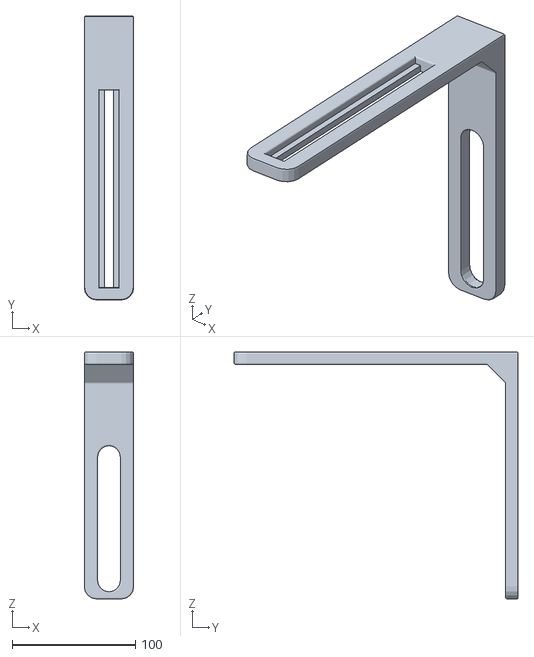
[picture p123: CAD file, 2026-06-07]
PIMP-1889-250226A-AWARETRACK/V1.0/FAB/IMP/1889.000.008.000.BASE_3_PCB_MONTAJE.stl
40.0 x 230.0 x 200.0
