koteos/RANDOM/Self Balancing Robot Files/STL Files/Chassis 1.stl

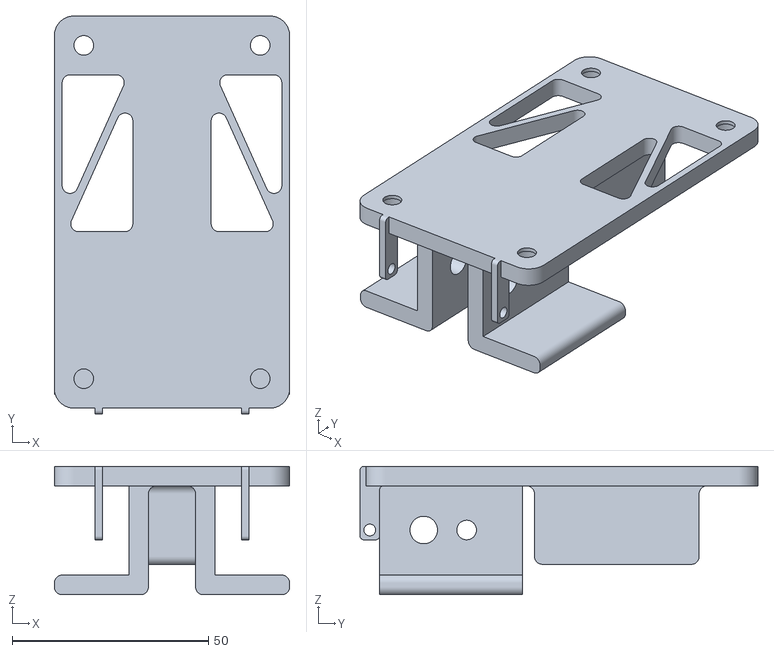
[picture p125: CAD file, 2025-05-05]
Self Balancing Robot Files/STL Files/Chassis 1.stl
60.0 x 101.5 x 32.8
