koteos/RANDOM/10-EKOT-1074-170619A-UBF-PI/V1.4_SE_FABRICO/FAB/MAQUINADO_SOLDADURA/1074.000.012.000.END_ROD.igs

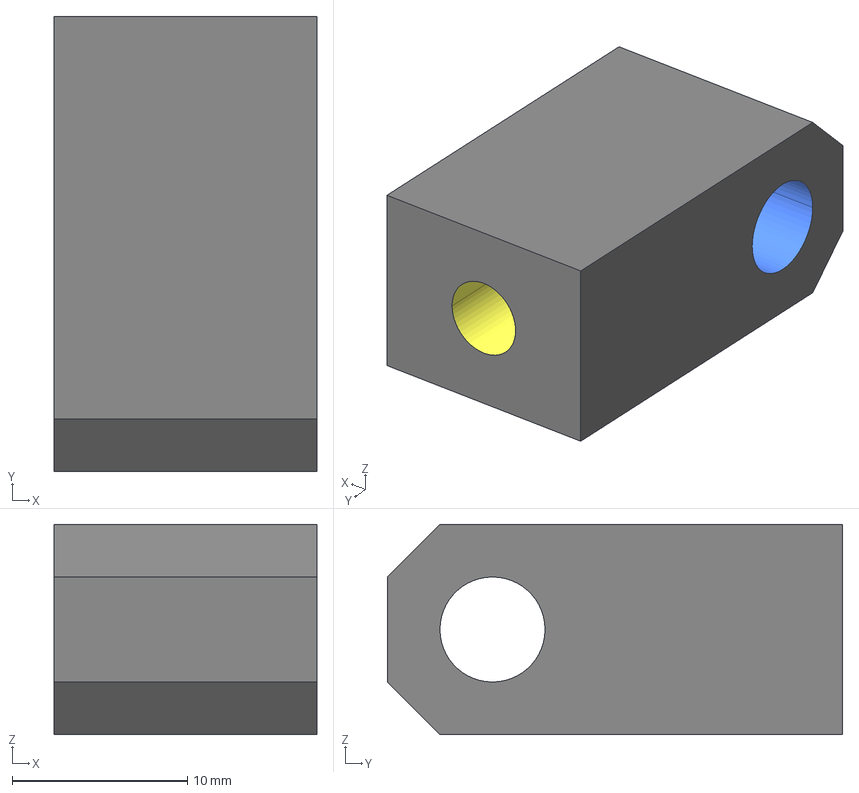
[picture p126: CAD file, 2026-03-17]
10-EKOT-1074-170619A-UBF-PI/V1.4_SE_FABRICO/FAB/MAQUINADO_SOLDADURA/1074.000.012.000.END_ROD.igs
15.0 x 26.0 x 12.0 mm
