koteos/RANDOM/10-EKOT-1074-170619A-UBF-PI/V1.5_CON_TAPAS_MOTOR/FAB/MAQUINADO_SOLDADURA/1074.000.013.000.ARANDELA.igs

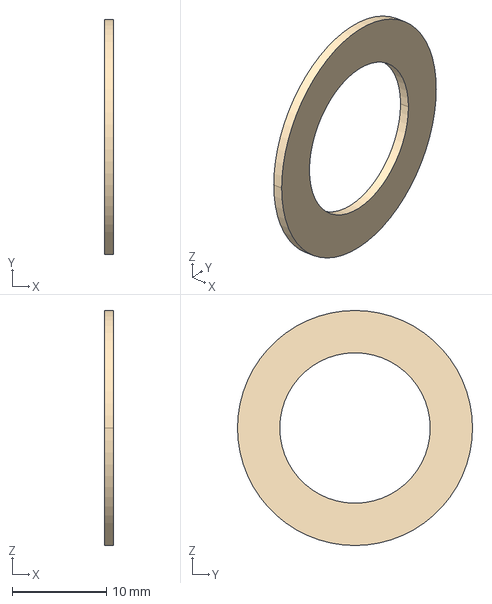
[picture p127: CAD file, 2026-03-17]
10-EKOT-1074-170619A-UBF-PI/V1.5_CON_TAPAS_MOTOR/FAB/MAQUINADO_SOLDADURA/1074.000.013.000.ARANDELA.igs
1.00 x 25.0 x 25.0 mm
