koteos/RANDOM/EKOT-1360-170921A-LEXA_WAIST_SUPPORT/3DN/1360.001.004.000.POLEA_3.stl

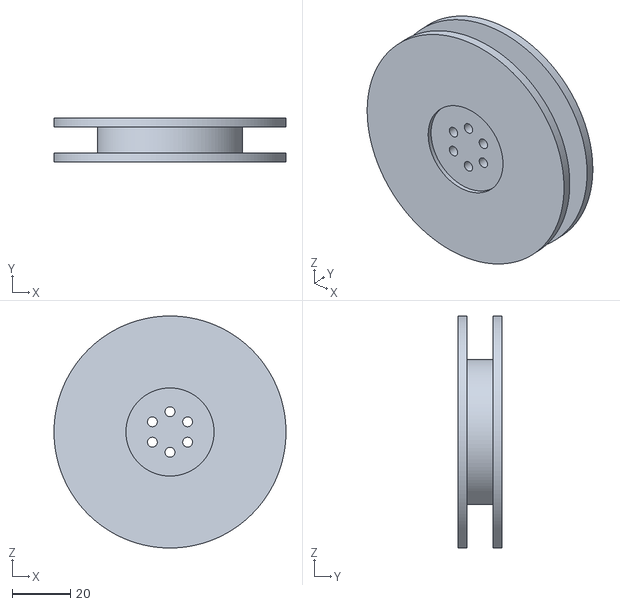
[picture p128: CAD file, 2026-03-27]
EKOT-1360-170921A-LEXA_WAIST_SUPPORT/3DN/1360.001.004.000.POLEA_3.stl
80.0 x 15.0 x 80.0
