koteos/RANDOM/EKOT-1360-170921A-LEXA_WAIST_SUPPORT/FAB/FAB_A/1360 CORTE/1360.000.005.001.PLACA.stp

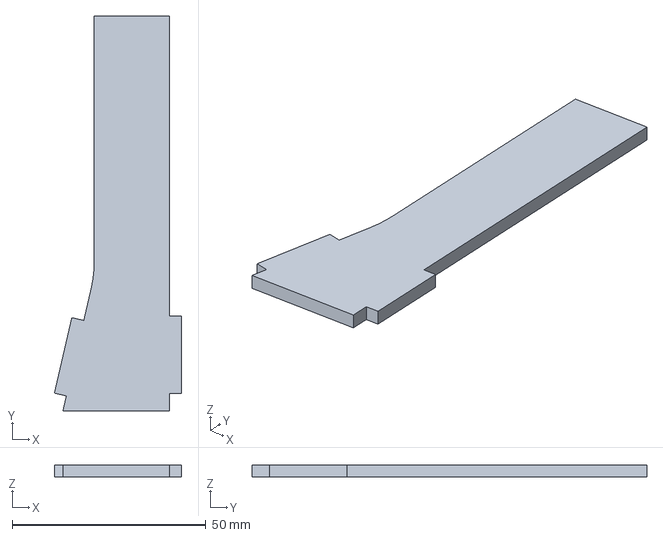
[picture p129: CAD file, 2026-03-27]
EKOT-1360-170921A-LEXA_WAIST_SUPPORT/FAB/FAB_A/1360 CORTE/1360.000.005.001.PLACA.stp
32.9 x 102.0 x 3.17 mm
