koteos/RANDOM/EKOT-1360-170921A-LEXA_WAIST_SUPPORT/FAB/FAB_C/PDF/MAQUINADO/1360.000.012.000.ARANDELA.stp

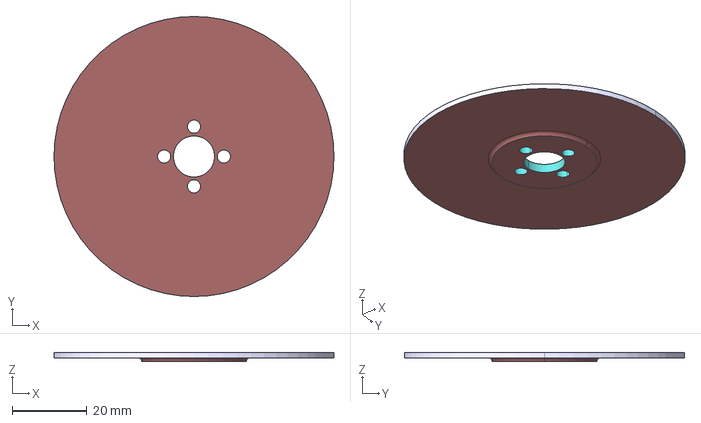
[picture p130: CAD file, 2026-03-27]
EKOT-1360-170921A-LEXA_WAIST_SUPPORT/FAB/FAB_C/PDF/MAQUINADO/1360.000.012.000.ARANDELA.stp
75.0 x 75.0 x 2.50 mm
