koteos/RANDOM/pancito.dxf

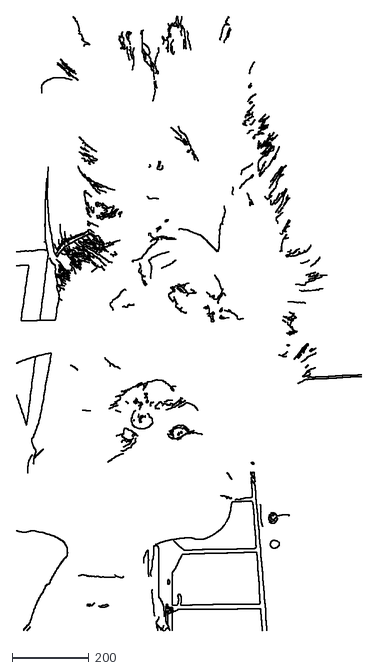
[picture p131: CAD file, 2025-05-05]
pancito.dxf
898.0 x 1598.0
