koteos/RANDOM/10-EKOT-1074-170619A-UBF-PI/V1.4_SE_FABRICO/FAB/MAQUINADO_SOLDADURA/1074.000.023.000.TUBO.igs

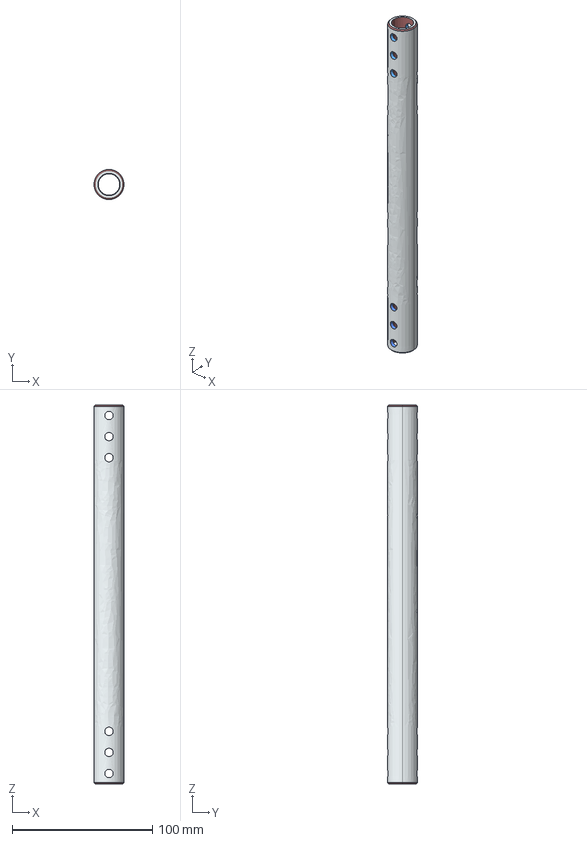
[picture p132: CAD file, 2026-03-17]
10-EKOT-1074-170619A-UBF-PI/V1.4_SE_FABRICO/FAB/MAQUINADO_SOLDADURA/1074.000.023.000.TUBO.igs
21.4 x 21.4 x 270.0 mm
