koteos/RANDOM/EKOT-1360-170921A-LEXA_WAIST_SUPPORT/3DN/1360.001.005.000.COPLE_POLEA.stl

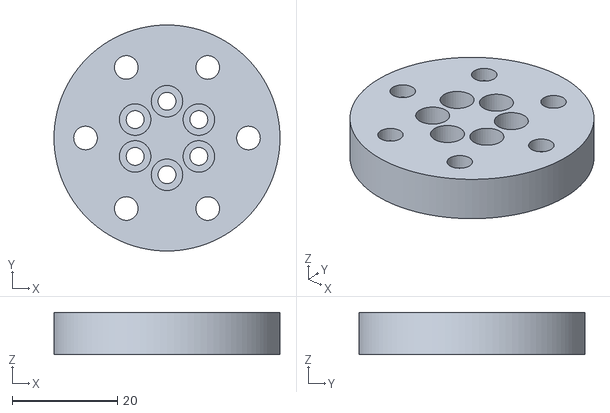
[picture p133: CAD file, 2026-03-27]
EKOT-1360-170921A-LEXA_WAIST_SUPPORT/3DN/1360.001.005.000.COPLE_POLEA.stl
43.0 x 43.0 x 8.00
