koteos/RANDOM/EKOT-1360-170921A-LEXA_WAIST_SUPPORT/FAB/FAB_A/1360 CORTE/1360.000.001.003.TOPE.dxf

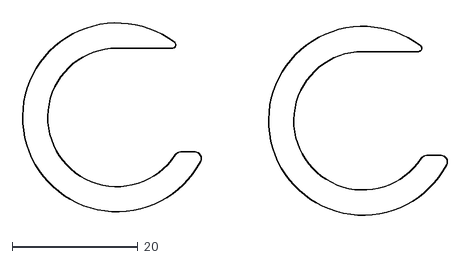
[picture p134: CAD file, 2026-03-27]
EKOT-1360-170921A-LEXA_WAIST_SUPPORT/FAB/FAB_A/1360 CORTE/1360.000.001.003.TOPE.dxf
68.5 x 32.3
