koteos/RANDOM/EKOT-1360-170921A-LEXA_WAIST_SUPPORT/FAB/FAB_A/2D FINAL VERSION/1360 PLANTILLAS DE CORTE/1360 PLANTILLAS DE CORTE DXF/1360.000.001.001.BASE.dxf

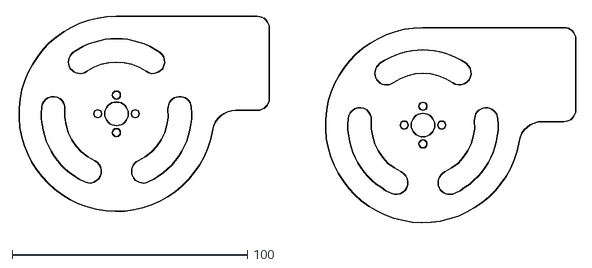
[picture p135: CAD file, 2026-03-27]
EKOT-1360-170921A-LEXA_WAIST_SUPPORT/FAB/FAB_A/2D FINAL VERSION/1360 PLANTILLAS DE CORTE/1360 PLANTILLAS DE CORTE DXF/1360.000.001.001.BASE.dxf
238.1 x 90.0
