koteos/RANDOM/EKOT-1360-170921A-LEXA_WAIST_SUPPORT/FAB/FAB_C/PDF/MAQUINADO/1360.000.009.000.TUBO.stp

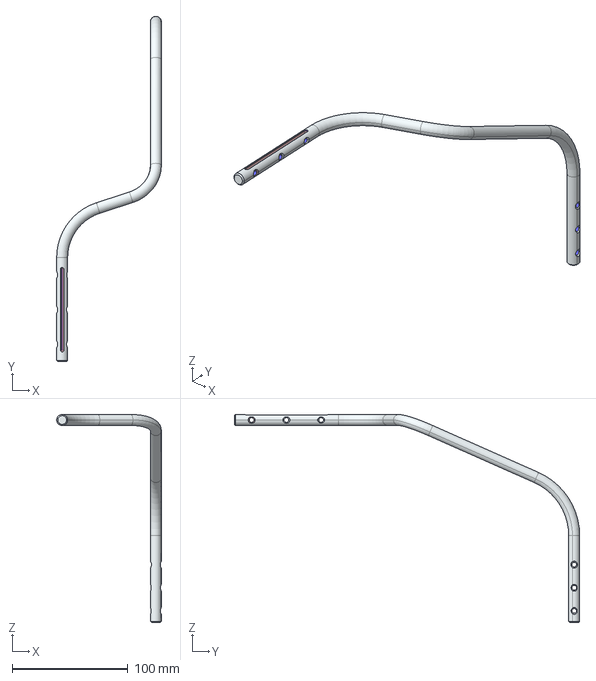
[picture p136: CAD file, 2026-03-27]
EKOT-1360-170921A-LEXA_WAIST_SUPPORT/FAB/FAB_C/PDF/MAQUINADO/1360.000.009.000.TUBO.stp
90.5 x 298.4 x 179.7 mm
