koteos/RANDOM/sign3.dxf

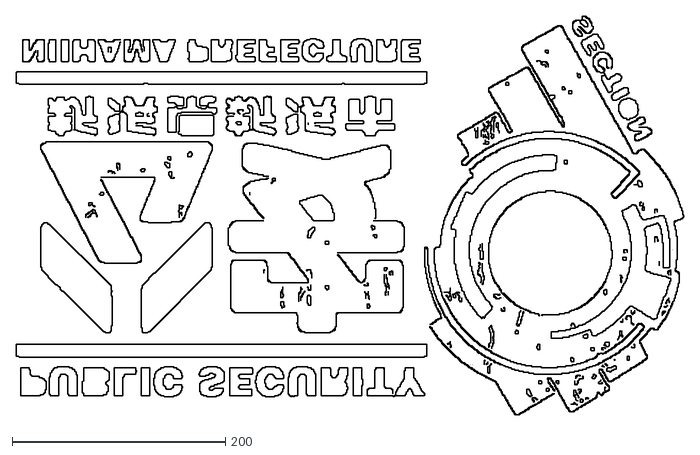
[picture p137: CAD file, 2025-05-05]
sign3.dxf
626.0 x 374.0
