koteos/RANDOM/10-EKOT-1074-170619A-UBF-PI/V1.4_SE_FABRICO/FAB/MAQUINADO_SOLDADURA/1074.000.022.000.BASE_ROTULA.igs

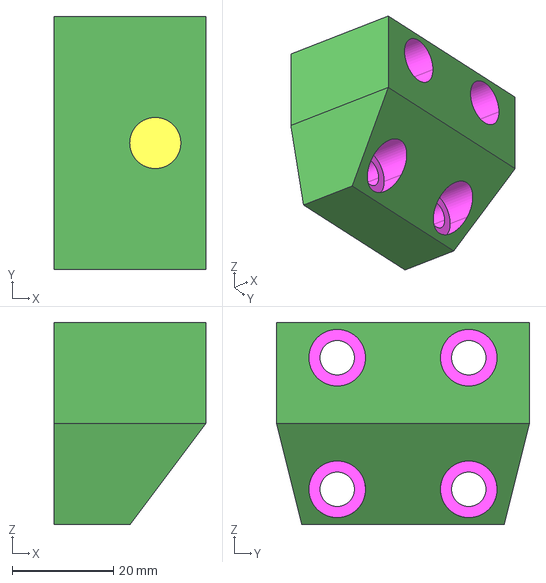
[picture p138: CAD file, 2026-03-17]
10-EKOT-1074-170619A-UBF-PI/V1.4_SE_FABRICO/FAB/MAQUINADO_SOLDADURA/1074.000.022.000.BASE_ROTULA.igs
30.0 x 50.0 x 40.0 mm
