koteos/RANDOM/10-EKOT-1074-170619A-UBF-PI/V1.5_CON_TAPAS_MOTOR/FAB/MAQUINADO_SOLDADURA/1074.000.024.000.BASE_CILINDRO_GAS.igs

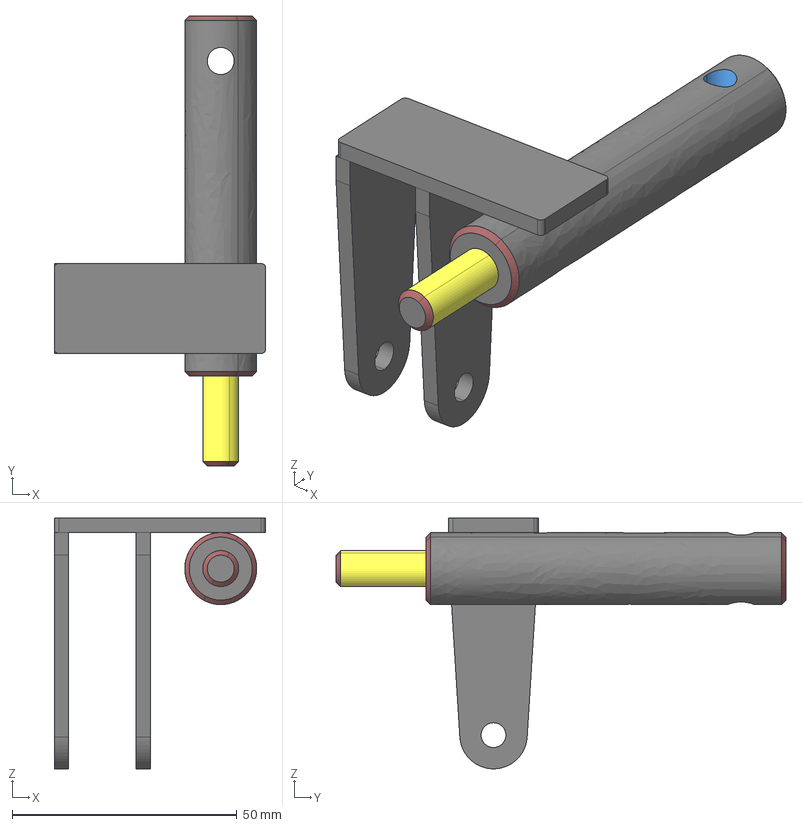
[picture p139: CAD file, 2026-03-17]
10-EKOT-1074-170619A-UBF-PI/V1.5_CON_TAPAS_MOTOR/FAB/MAQUINADO_SOLDADURA/1074.000.024.000.BASE_CILINDRO_GAS.igs
47.0 x 100.0 x 55.7 mm
