koteos/RANDOM/EKOT-1360-170921A-LEXA_WAIST_SUPPORT/3DN/1360.000.003.000.TAMBOR.stl

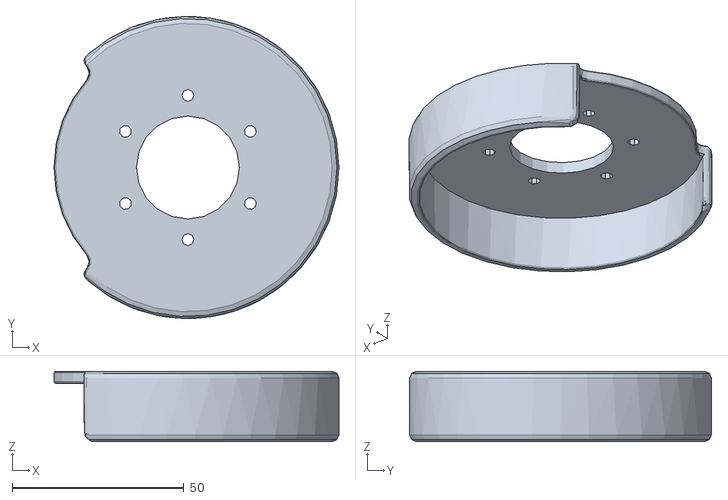
[picture p140: CAD file, 2026-03-27]
EKOT-1360-170921A-LEXA_WAIST_SUPPORT/3DN/1360.000.003.000.TAMBOR.stl
83.0 x 88.0 x 20.5
