koteos/RANDOM/EKOT-1360-170921A-LEXA_WAIST_SUPPORT/FAB/FAB_A/1360 CORTE/1360.000.004.002.BISAGRA_TOPE.stp

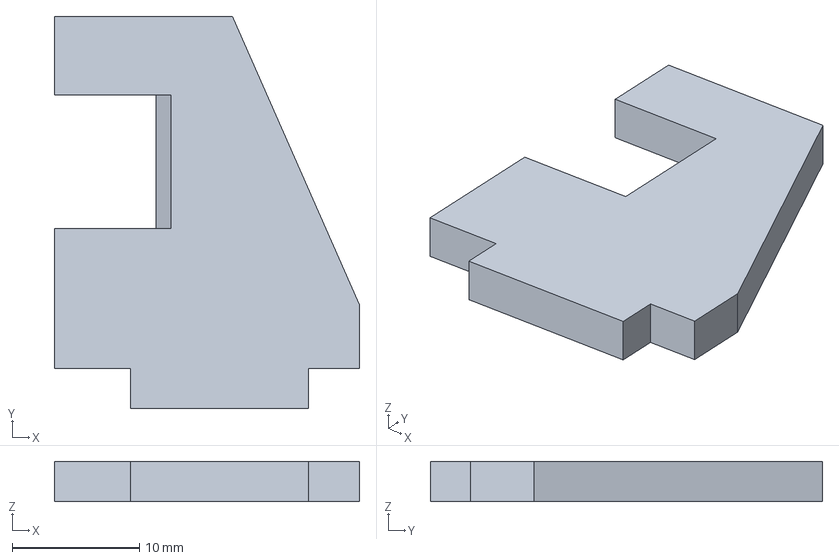
[picture p141: CAD file, 2026-03-27]
EKOT-1360-170921A-LEXA_WAIST_SUPPORT/FAB/FAB_A/1360 CORTE/1360.000.004.002.BISAGRA_TOPE.stp
24.0 x 30.9 x 3.18 mm
