koteos/RANDOM/EKOT-1360-170921A-LEXA_WAIST_SUPPORT/FAB/FAB_C/PDF/MAQUINADO/1360.000.003.000.FLECHA.stp

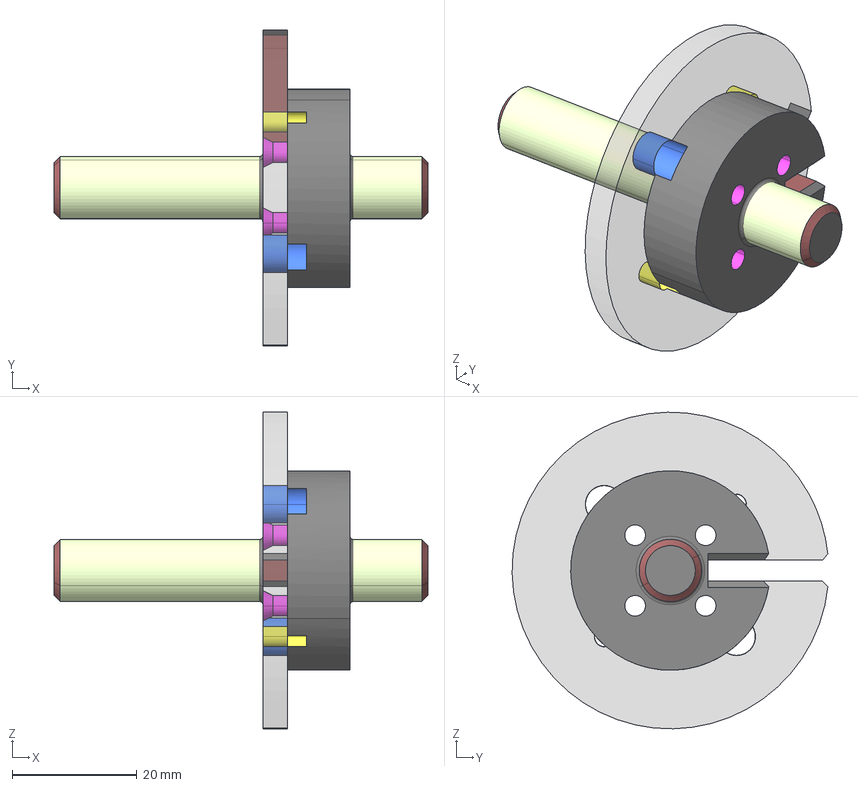
[picture p142: CAD file, 2026-03-27]
EKOT-1360-170921A-LEXA_WAIST_SUPPORT/FAB/FAB_C/PDF/MAQUINADO/1360.000.003.000.FLECHA.stp
60.0 x 50.7 x 50.8 mm
