koteos/RANDOM/EKOT-1360-170921A-LEXA_WAIST_SUPPORT/FAB/FAB_C/PDF/MAQUINADO/1360.000.002.000.BASE_SIN_FIN.stp

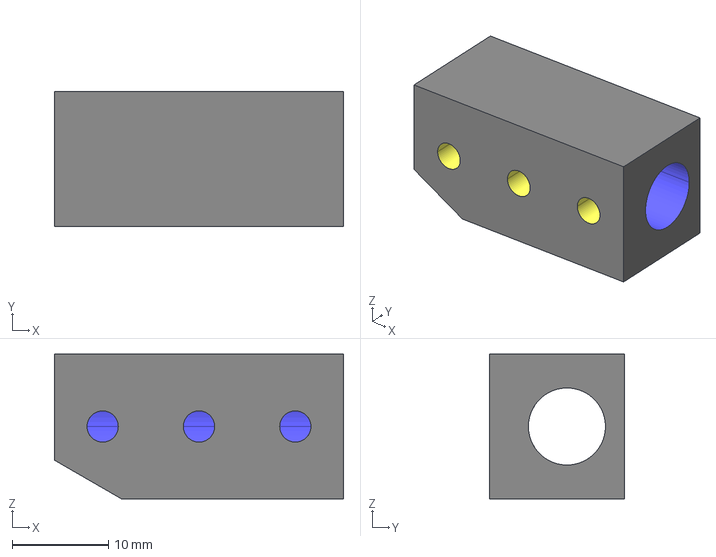
[picture p147: CAD file, 2026-03-27]
EKOT-1360-170921A-LEXA_WAIST_SUPPORT/FAB/FAB_C/PDF/MAQUINADO/1360.000.002.000.BASE_SIN_FIN.stp
30.0 x 14.0 x 15.0 mm
