koteos/RANDOM/10-EKOT-1074-170619A-UBF-PI/V1.5_CON_TAPAS_MOTOR/FAB/MAQUINADO_SOLDADURA/1074.000.027.000.HUSILLO.igs

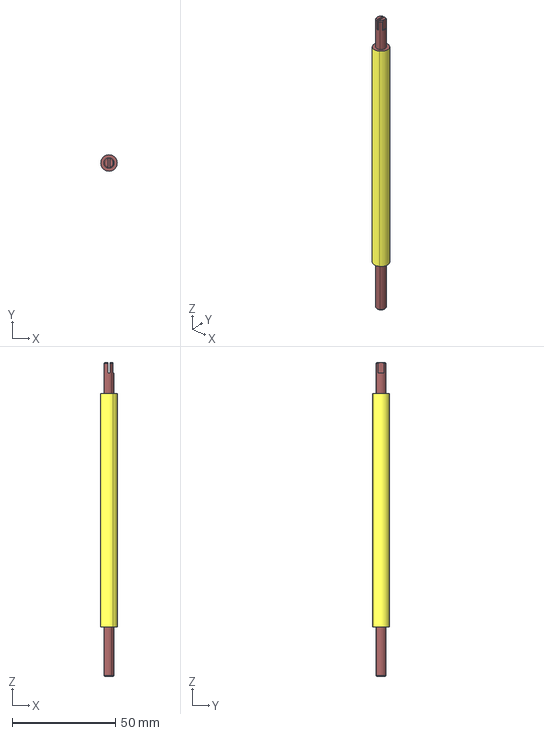
[picture p148: CAD file, 2026-03-17]
10-EKOT-1074-170619A-UBF-PI/V1.5_CON_TAPAS_MOTOR/FAB/MAQUINADO_SOLDADURA/1074.000.027.000.HUSILLO.igs
8.00 x 8.00 x 152.0 mm
