koteos/RANDOM/EKOT-1360-170921A-LEXA_WAIST_SUPPORT/FAB/FAB_A/1360 CORTE/1360.000.005.002.PLACA.stp

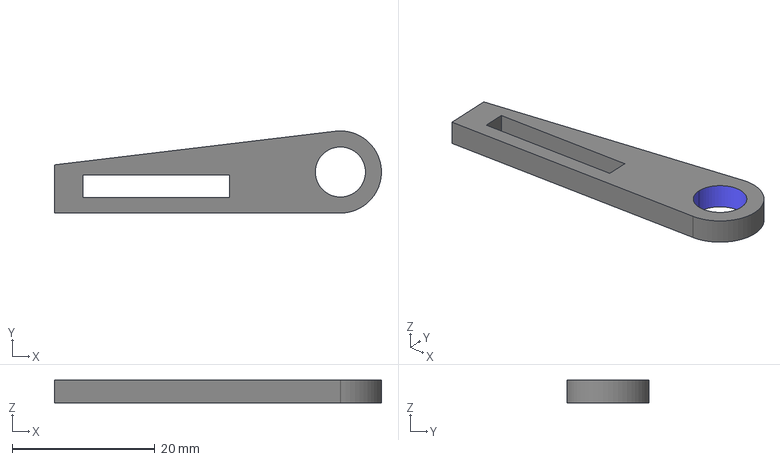
[picture p149: CAD file, 2026-03-27]
EKOT-1360-170921A-LEXA_WAIST_SUPPORT/FAB/FAB_A/1360 CORTE/1360.000.005.002.PLACA.stp
45.7 x 11.5 x 3.20 mm
