koteos/RANDOM/10-EKOT-1074-170619A-UBF-PI/V1.4_SE_FABRICO/FAB/MAQUINADO_SOLDADURA/1074.000.005.000.BASE_ENC_LIN.igs

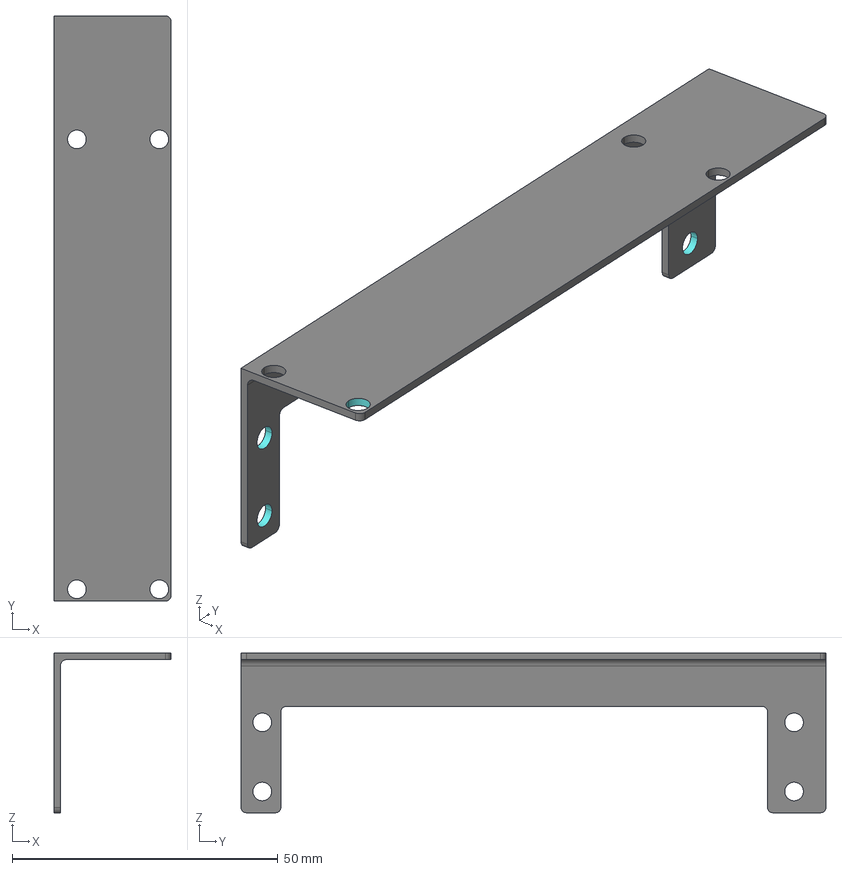
[picture p151: CAD file, 2026-03-17]
10-EKOT-1074-170619A-UBF-PI/V1.4_SE_FABRICO/FAB/MAQUINADO_SOLDADURA/1074.000.005.000.BASE_ENC_LIN.igs
22.0 x 110.0 x 30.0 mm
