koteos/RANDOM/10-EKOT-1074-170619A-UBF-PI/V1.4_SE_FABRICO/FAB/MAQUINADO_SOLDADURA/1074.000.026.002.CAJA_HUSILLO1.igs

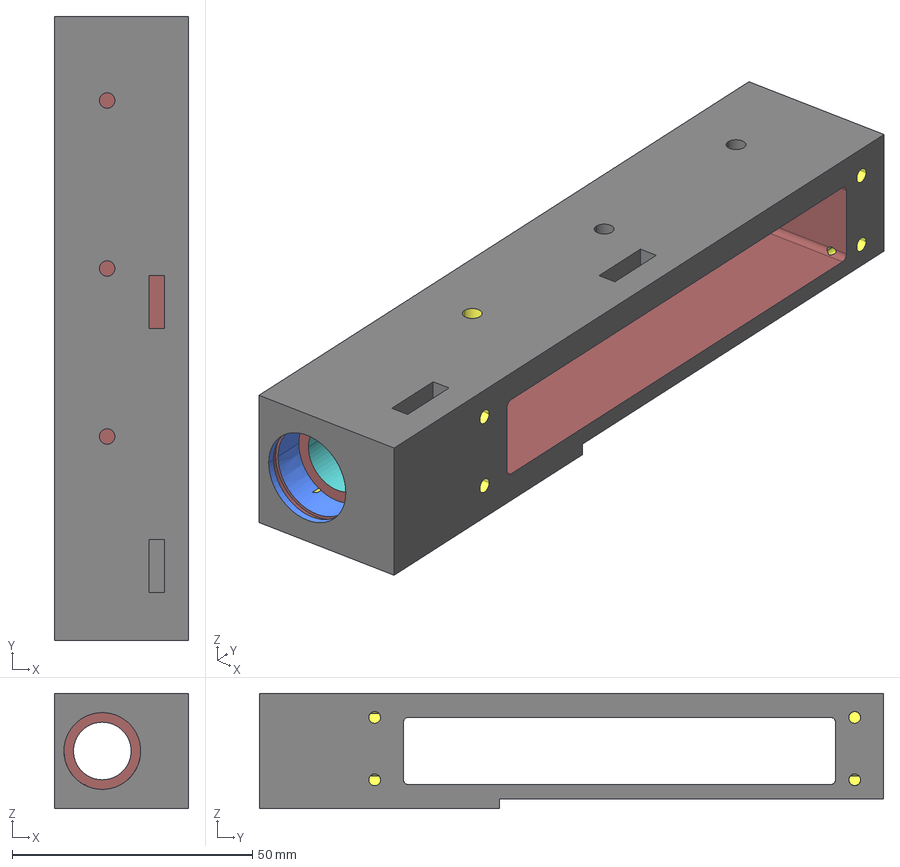
[picture p156: CAD file, 2026-03-17]
10-EKOT-1074-170619A-UBF-PI/V1.4_SE_FABRICO/FAB/MAQUINADO_SOLDADURA/1074.000.026.002.CAJA_HUSILLO1.igs
28.0 x 130.0 x 24.0 mm
