koteos/RANDOM/(list of files, cad)

Other CAD files:
PIMP-1889-250226A-AWARETRACK/V1.0/STL/1889.000.002.000.CASE_MALE_B_NEGRO.stl
PIMP-1889-250226A-AWARETRACK/V1.0/STL/1889.000.002.000.CASE_MALE_B_AZUL.stl
PIMP-1889-250226A-AWARETRACK/V1.0/FAB/IMP/1889.000.007.000.BASE_2_PCB_MONTAJE2.stl
EKOT-1360-170921A-LEXA_WAIST_SUPPORT/FAB/FAB_C/PDF/MAQUINADO/1360.000.006.000.SOPORTE_MUSLO.stp
10-EKOT-1074-170619A-UBF-PI/V0.0/3D/1074.000.000.000.ENSAMBLE_GENERAL.CATProduct
10-EKOT-1074-170619A-UBF-PI/V0.0/3D/EJES_1.CATPart
10-EKOT-1074-170619A-UBF-PI/V0.0/3D/EKOT.1074.100.000.000.MECANISMO_DER.CATProduct
10-EKOT-1074-170619A-UBF-PI/V0.0/3D/EKOT.1074.100.001.000.ROTULA.CATPart
10-EKOT-1074-170619A-UBF-PI/V0.0/3D/EKOT.1074.100.002.000.S-ROTULA.CATPart
10-EKOT-1074-170619A-UBF-PI/V0.0/3D/EKOT.1074.100.003.000.HUSILLO.CATPart
10-EKOT-1074-170619A-UBF-PI/V0.0/3D/EKOT.1074.100.004.000.PIVOTE.CATPart
10-EKOT-1074-170619A-UBF-PI/V0.0/3D/EKOT.1074.100.005.000.PLACA.CATPart
10-EKOT-1074-170619A-UBF-PI/V0.0/3D/EKOT.1074.100.006.000.RESORTE.CATPart
10-EKOT-1074-170619A-UBF-PI/V0.0/3D/EKOT.1074.100.007.000.POLEA.CATPart
10-EKOT-1074-170619A-UBF-PI/V0.0/3D/EKOT.1074.100.008.000.LAMINA.CATPart
10-EKOT-1074-170619A-UBF-PI/V0.0/3D/EKOT.1074.100.009.000.LAMINA.CATPart
10-EKOT-1074-170619A-UBF-PI/V0.0/3D/EKOT.1074.100.010.000.CABLE.CATPart
10-EKOT-1074-170619A-UBF-PI/V0.0/3D/EKOT.1074.100.011.000.PROTECCION.CATPart
10-EKOT-1074-170619A-UBF-PI/V0.0/3D/EKOT.1074.200.000.000.CHALECO.CATProduct
10-EKOT-1074-170619A-UBF-PI/V0.0/3D/EKOT.1074.200.001.000.CINTO.CATPart
10-EKOT-1074-170619A-UBF-PI/V0.0/3D/EKOT.1074.200.002.000.ESPALDA.CATPart
10-EKOT-1074-170619A-UBF-PI/V0.0/3D/EKOT.1074.200.003.000.PECHO.CATPart
10-EKOT-1074-170619A-UBF-PI/V0.0/3D/EKOT.1074.200.004.000.SOPORTE-T.CATPart
10-EKOT-1074-170619A-UBF-PI/V0.0/3D/EKOT.1074.200.005.000.TIRANTE.CATPart
10-EKOT-1074-170619A-UBF-PI/V0.0/3D/EKOT.1074.300.000.000.SOPORTE-BAN.CATProduct
10-EKOT-1074-170619A-UBF-PI/V0.0/3D/EKOT.1074.300.001.000.BARRA.CATPart
10-EKOT-1074-170619A-UBF-PI/V0.0/3D/EKOT.1074.300.002.000.PLACA.CATPart
10-EKOT-1074-170619A-UBF-PI/V0.0/3D/EKOT.1074.300.003.000.SUJETADOR-AN.CATPart
10-EKOT-1074-170619A-UBF-PI/V0.0/3D/EKOT.1074.300.004.000.B-E.CATPart
10-EKOT-1074-170619A-UBF-PI/V0.0/3D/ISO_4762_M5x12_STEEL_HEXAGON_SOCKET_HEAD_CAP_SCREW_1.CATPart
10-EKOT-1074-170619A-UBF-PI/V0.0/3D/Symmetry of EKOT.1074.100.000.000.MECANISMO_DER.CATProduct
10-EKOT-1074-170619A-UBF-PI/V0.0/3D/Symmetry of EKOT.1074.100.001.000.ROTULA.CATPart
10-EKOT-1074-170619A-UBF-PI/V0.0/3D/Symmetry of EKOT.1074.100.002.000.S-ROTULA.CATPart
10-EKOT-1074-170619A-UBF-PI/V0.0/3D/Symmetry of EKOT.1074.100.003.000.HUSILLO.CATPart
10-EKOT-1074-170619A-UBF-PI/V0.0/3D/Symmetry of EKOT.1074.100.004.000.PIVOTE.CATPart
10-EKOT-1074-170619A-UBF-PI/V0.0/3D/Symmetry of EKOT.1074.100.005.000.PLACA.CATPart
10-EKOT-1074-170619A-UBF-PI/V0.0/3D/Symmetry of EKOT.1074.100.007.000.POLEA.CATPart
10-EKOT-1074-170619A-UBF-PI/V0.0/3D/Symmetry of EKOT.1074.100.008.000.LAMINA.CATPart
10-EKOT-1074-170619A-UBF-PI/V0.0/3D/Symmetry of EKOT.1074.100.009.000.LAMINA.CATPart
10-EKOT-1074-170619A-UBF-PI/V0.0/3D/Symmetry of EKOT.1074.100.010.000.CABLE.CATPart
10-EKOT-1074-170619A-UBF-PI/V0.0/3D/Symmetry of EKOT.1074.100.011.000.PROTECCION.CATPart
10-EKOT-1074-170619A-UBF-PI/V0.0/3D/Symmetry of EKOT.1074.200.005.000.TIRANTE.CATPart
10-EKOT-1074-170619A-UBF-PI/V0.0/3D/Symmetry of EKOT.1074.300.000.000.SOPORTE-BAN.CATProduct
10-EKOT-1074-170619A-UBF-PI/V0.0/3D/Symmetry of ISO 4762 SCREW M5x12 STEEL HEXAGON SOCKET HEAD CAP.CATPart
10-EKOT-1074-170619A-UBF-PI/V0.0/3D/Symmetry of Part14.CATPart
10-EKOT-1074-170619A-UBF-PI/V0.0/3D/Symmetry of Part15.CATPart
10-EKOT-1074-170619A-UBF-PI/V0.0/3D/Symmetry of Part18.CATPart
10-EKOT-1074-170619A-UBF-PI/V0.0/3D/Symmetry of Part19.CATPart
10-EKOT-1074-170619A-UBF-PI/V0.0/3D/Symmetry of esmr-extended-mw-2_007x15_000x47_500x11_72x10_987-kato.CATPart
10-EKOT-1074-170619A-UBF-PI/V1.0/3D/1047.000.000.000.SANDWICH_PLACA_CINTURA.CATProduct
10-EKOT-1074-170619A-UBF-PI/V1.0/3D/1074.000.000.000.ENSAMBLE_BRAZO.CATProduct
10-EKOT-1074-170619A-UBF-PI/V1.0/3D/1074.000.000.000.ENSAMBLE_GENERAL.CATProduct
10-EKOT-1074-170619A-UBF-PI/V1.0/3D/1074.000.000.000.ENSAMBLE_PLACA_CINTURON.CATProduct
10-EKOT-1074-170619A-UBF-PI/V1.0/3D/1074.000.000.000.ENSAMBLE_TUBO_ESPALDA.CATProduct
10-EKOT-1074-170619A-UBF-PI/V1.0/3D/1074.000.021.000.PLACA_LC.CATPart
10-EKOT-1074-170619A-UBF-PI/V1.0/3D/1074.000.022.000.BASE_ROTULA.CATPart
10-EKOT-1074-170619A-UBF-PI/V1.0/3D/1074.000.023.000.TUBO.CATPart
10-EKOT-1074-170619A-UBF-PI/V1.0/3D/1074.000.024.000.BASE_CILINDRO_GAS.CATProduct
10-EKOT-1074-170619A-UBF-PI/V1.0/3D/1074.000.024.000.REDONDO_ROSCA.CATPart
10-EKOT-1074-170619A-UBF-PI/V1.0/3D/1074.000.024.001.REDONDO_ROSCA.CATPart
10-EKOT-1074-170619A-UBF-PI/V1.0/3D/1074.000.024.002.OREJAS.CATPart
10-EKOT-1074-170619A-UBF-PI/V1.0/3D/1074.000.025.000.REDONDO_ROTULA.CATPart
10-EKOT-1074-170619A-UBF-PI/V1.0/3D/1074.000.025.000.REDONDO_ROTULA.CATProduct
10-EKOT-1074-170619A-UBF-PI/V1.0/3D/1074.000.025.000.RED_INF_ROTULA.CATProduct
10-EKOT-1074-170619A-UBF-PI/V1.0/3D/1074.000.025.000.RED_SUP_ROTULA.CATProduct
10-EKOT-1074-170619A-UBF-PI/V1.0/3D/1074.000.025.001.REDONDO_ROTULA.CATPart
10-EKOT-1074-170619A-UBF-PI/V1.0/3D/1074.000.025.002.OREJAS.CATPart
10-EKOT-1074-170619A-UBF-PI/V1.0/3D/1074.000.026.000.BRAZO.CATProduct
10-EKOT-1074-170619A-UBF-PI/V1.0/3D/1074.000.026.001.BARRA_BRAZO.CATPart
10-EKOT-1074-170619A-UBF-PI/V1.0/3D/1074.000.026.002.CAJA_HUSILLO.CATPart
10-EKOT-1074-170619A-UBF-PI/V1.0/3D/1074.000.027.000.HUSILLO.CATPart
10-EKOT-1074-170619A-UBF-PI/V1.0/3D/1074.000.028.000.TUERCA_HUSILLO.CATPart
10-EKOT-1074-170619A-UBF-PI/V1.0/3D/1074.000.029.000.POLEA.CATPart
10-EKOT-1074-170619A-UBF-PI/V1.0/3D/540 Size RC Brushless electric motor.CATProduct
10-EKOT-1074-170619A-UBF-PI/V1.0/3D/625_01.CATPart
10-EKOT-1074-170619A-UBF-PI/V1.0/3D/625_02.CATPart
10-EKOT-1074-170619A-UBF-PI/V1.0/3D/625_03.CATPart
10-EKOT-1074-170619A-UBF-PI/V1.0/3D/625_RODAMIENTO.CATProduct
10-EKOT-1074-170619A-UBF-PI/V1.0/3D/95105A183_Zinc-Plated Steel Heavy-Duty Rivet Nut.CATPart
10-EKOT-1074-170619A-UBF-PI/V1.0/3D/ANTEBRAZO_DERECHO.CATPart
10-EKOT-1074-170619A-UBF-PI/V1.0/3D/ANTEBRAZO_IZQUIERDO.CATPart
10-EKOT-1074-170619A-UBF-PI/V1.0/3D/BRAZO_DERECHO.CATPart
10-EKOT-1074-170619A-UBF-PI/V1.0/3D/BRAZO_IZQUIERDO.CATPart
10-EKOT-1074-170619A-UBF-PI/V1.0/3D/CINTURA.CATPart
10-EKOT-1074-170619A-UBF-PI/V1.0/3D/EJES_1.CATPart
10-EKOT-1074-170619A-UBF-PI/V1.0/3D/EKOT.1074.100.000.000.MECANISMO_DER.CATProduct
10-EKOT-1074-170619A-UBF-PI/V1.0/3D/EKOT.1074.100.001.000.ROTULA.CATPart
10-EKOT-1074-170619A-UBF-PI/V1.0/3D/EKOT.1074.100.002.000.S-ROTULA.CATPart
10-EKOT-1074-170619A-UBF-PI/V1.0/3D/EKOT.1074.100.003.000.HUSILLO.CATPart
10-EKOT-1074-170619A-UBF-PI/V1.0/3D/EKOT.1074.100.004.000.PIVOTE.CATPart
10-EKOT-1074-170619A-UBF-PI/V1.0/3D/EKOT.1074.100.005.000.PLACA.CATPart
10-EKOT-1074-170619A-UBF-PI/V1.0/3D/EKOT.1074.100.006.000.RESORTE.CATPart
10-EKOT-1074-170619A-UBF-PI/V1.0/3D/EKOT.1074.100.007.000.POLEA.CATPart
10-EKOT-1074-170619A-UBF-PI/V1.0/3D/EKOT.1074.100.008.000.LAMINA.CATPart
10-EKOT-1074-170619A-UBF-PI/V1.0/3D/EKOT.1074.100.009.000.LAMINA.CATPart
10-EKOT-1074-170619A-UBF-PI/V1.0/3D/EKOT.1074.100.010.000.CABLE.CATPart
10-EKOT-1074-170619A-UBF-PI/V1.0/3D/EKOT.1074.100.011.000.PROTECCION.CATPart
10-EKOT-1074-170619A-UBF-PI/V1.0/3D/EKOT.1074.200.000.000.CHALECO.CATProduct
10-EKOT-1074-170619A-UBF-PI/V1.0/3D/EKOT.1074.200.001.000.CINTO.CATPart
10-EKOT-1074-170619A-UBF-PI/V1.0/3D/EKOT.1074.200.002.000.ESPALDA.CATPart
10-EKOT-1074-170619A-UBF-PI/V1.0/3D/EKOT.1074.200.003.000.PECHO.CATPart
10-EKOT-1074-170619A-UBF-PI/V1.0/3D/EKOT.1074.200.004.000.SOPORTE-T.CATPart
10-EKOT-1074-170619A-UBF-PI/V1.0/3D/EKOT.1074.200.005.000.TIRANTE.CATPart
10-EKOT-1074-170619A-UBF-PI/V1.0/3D/ENGRANE_64T_40D.CATPart
10-EKOT-1074-170619A-UBF-PI/V1.0/3D/ENGRANE_9T_18.5D.CATPart
10-EKOT-1074-170619A-UBF-PI/V1.0/3D/ENSAMBLE_VATO.CATProduct
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
