koteos/RANDOM/EKOT-1360-170921A-LEXA_WAIST_SUPPORT/V.05/BITACORA.txt

13.03.25.RRG
El peso actual del equipo es de 3.5kg, pero aun no cambiamos los soportes de la cintura a metal, ahora tenemos impresiones.
