koteos/RANDOM/EKOT-1360-170921A-LEXA_WAIST_SUPPORT/FAB/FAB_A/1360 PLANOS DE FABRICACION/1360.000.000.000.WAIST_SUPPORT_HOJA_03_HOJA_001_002.pdf

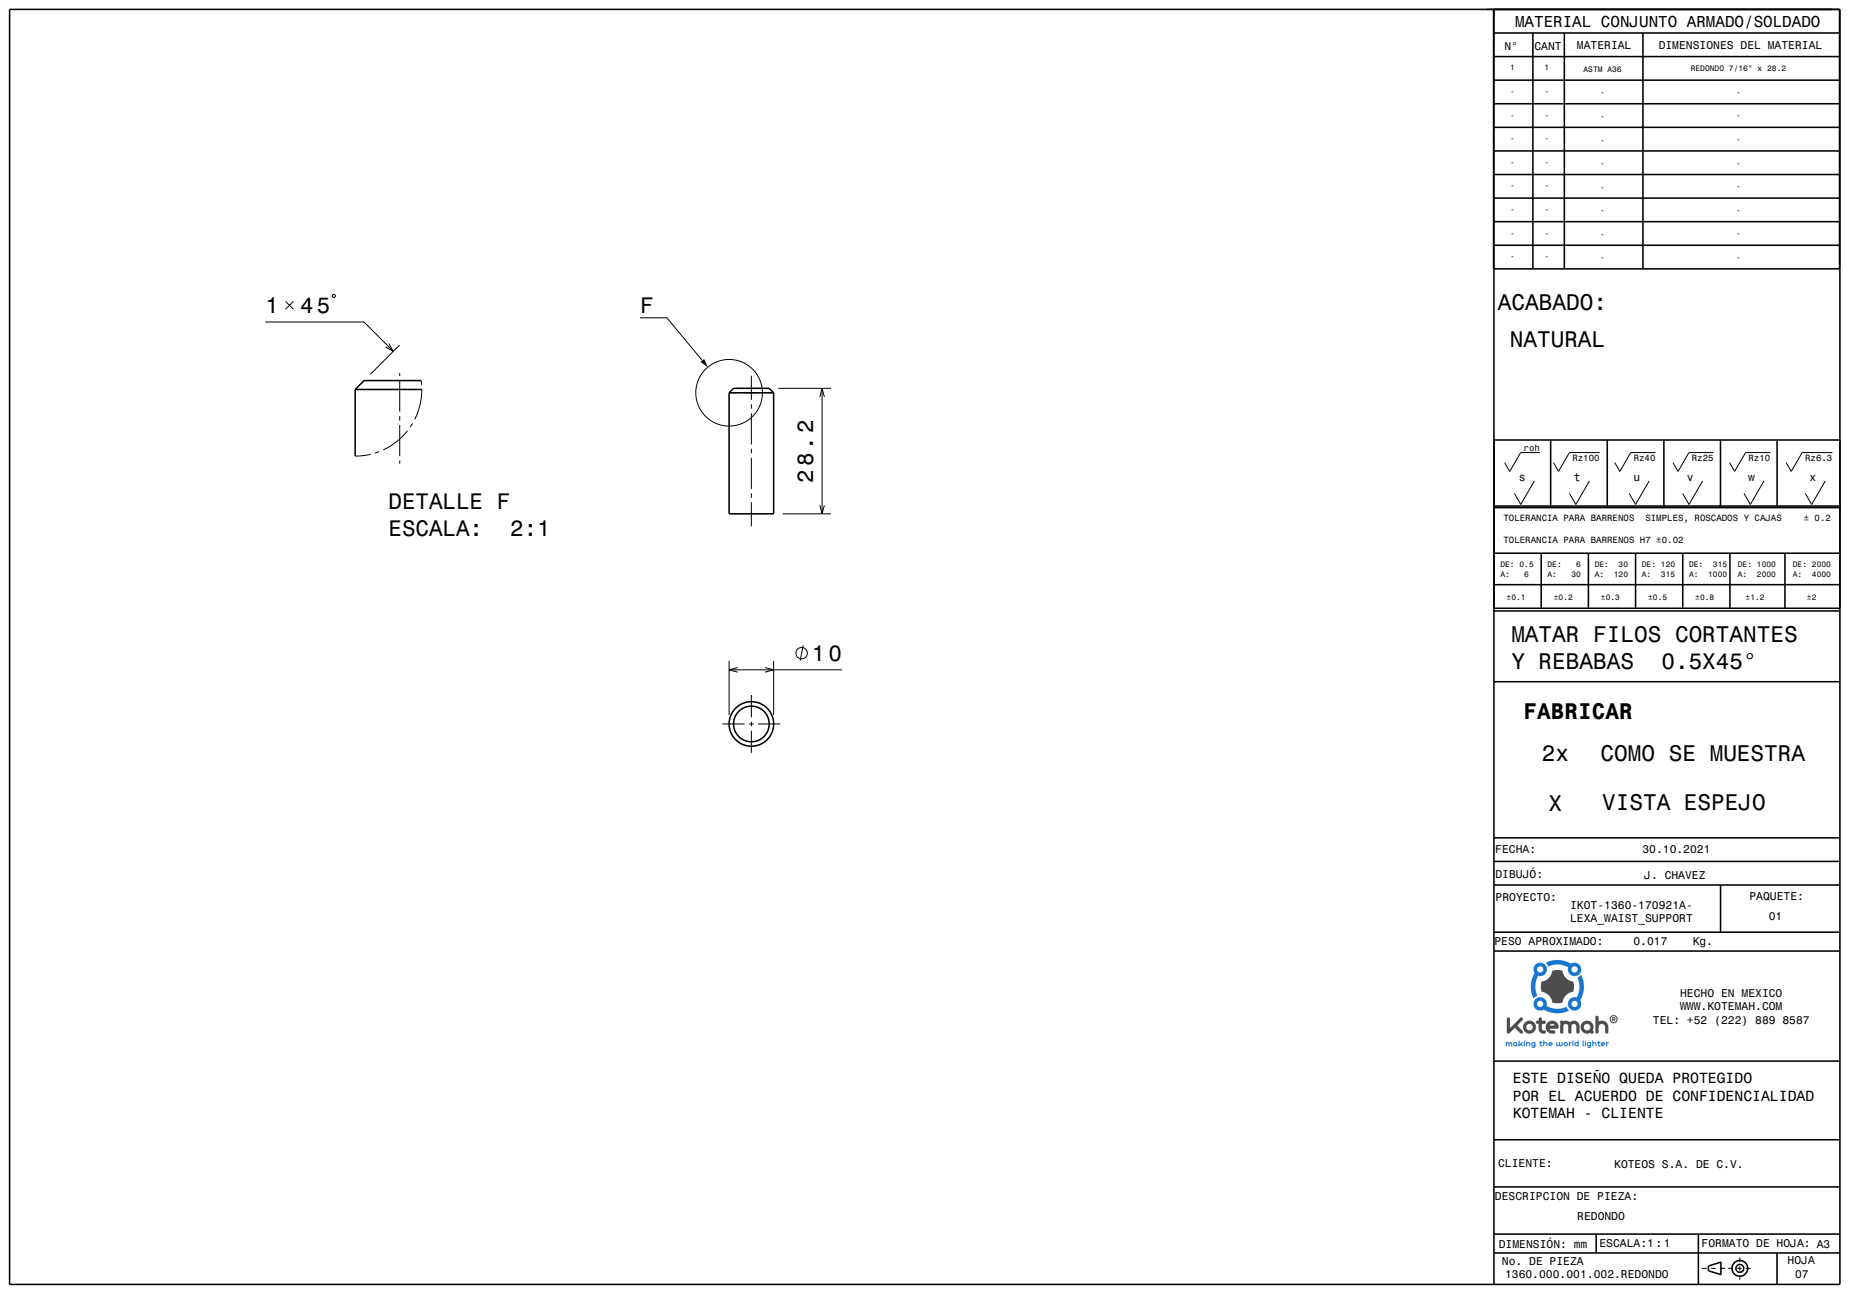
[picture p159: page 1]
TOLERANCIA PARA BARRENOS SIMPLES, ROSCADOS Y CAJAS; PESO APROXIMADO:; KOTEOS S.A. DE C.V.; J. CHAVEZ; DETALLE F ESCALA: 2:1

MATERIAL CONJUNTO ARMADO/SOLDADO

N° | CANT | MATERIAL | DIMENSIONES DEL MATERIAL

1 | 1 | ASTM A36 | REDONDO 7/16" x 28.2

- | - | | -----

TOLERANCIA PARA BARRENOS H7 ±0.02

MATAR FILOS CORTANTES
Y REBABAS 0.5X45°
FABRICAR
COMO SE MUESTRA
VISTA ESPEJO

HECHO EN MEXICO
WWW.KOTEMAH.COM
TEL: +52 (222) 889 8587

ESTE DISEÑO QUEDA PROTEGIDO
POR EL ACUERDO DE CONFIDENCIALIDAD
KOTEMAH - CLIENTE

DESCRIPCION DE PIEZA:

DIMENSIÓN: mm | ESCALA: : | FORMATO DE HOJA:
No. DE PIEZA 1360.000.001.002.REDONDO | | | HOJA 07
