koteos/RANDOM/EKOT-1360-170921A-LEXA_WAIST_SUPPORT/FAB/FAB_A/1360 PLANOS DE FABRICACION/1360.000.000.000.WAIST_SUPPORT_HOJA_03_HOJA_008_001.pdf

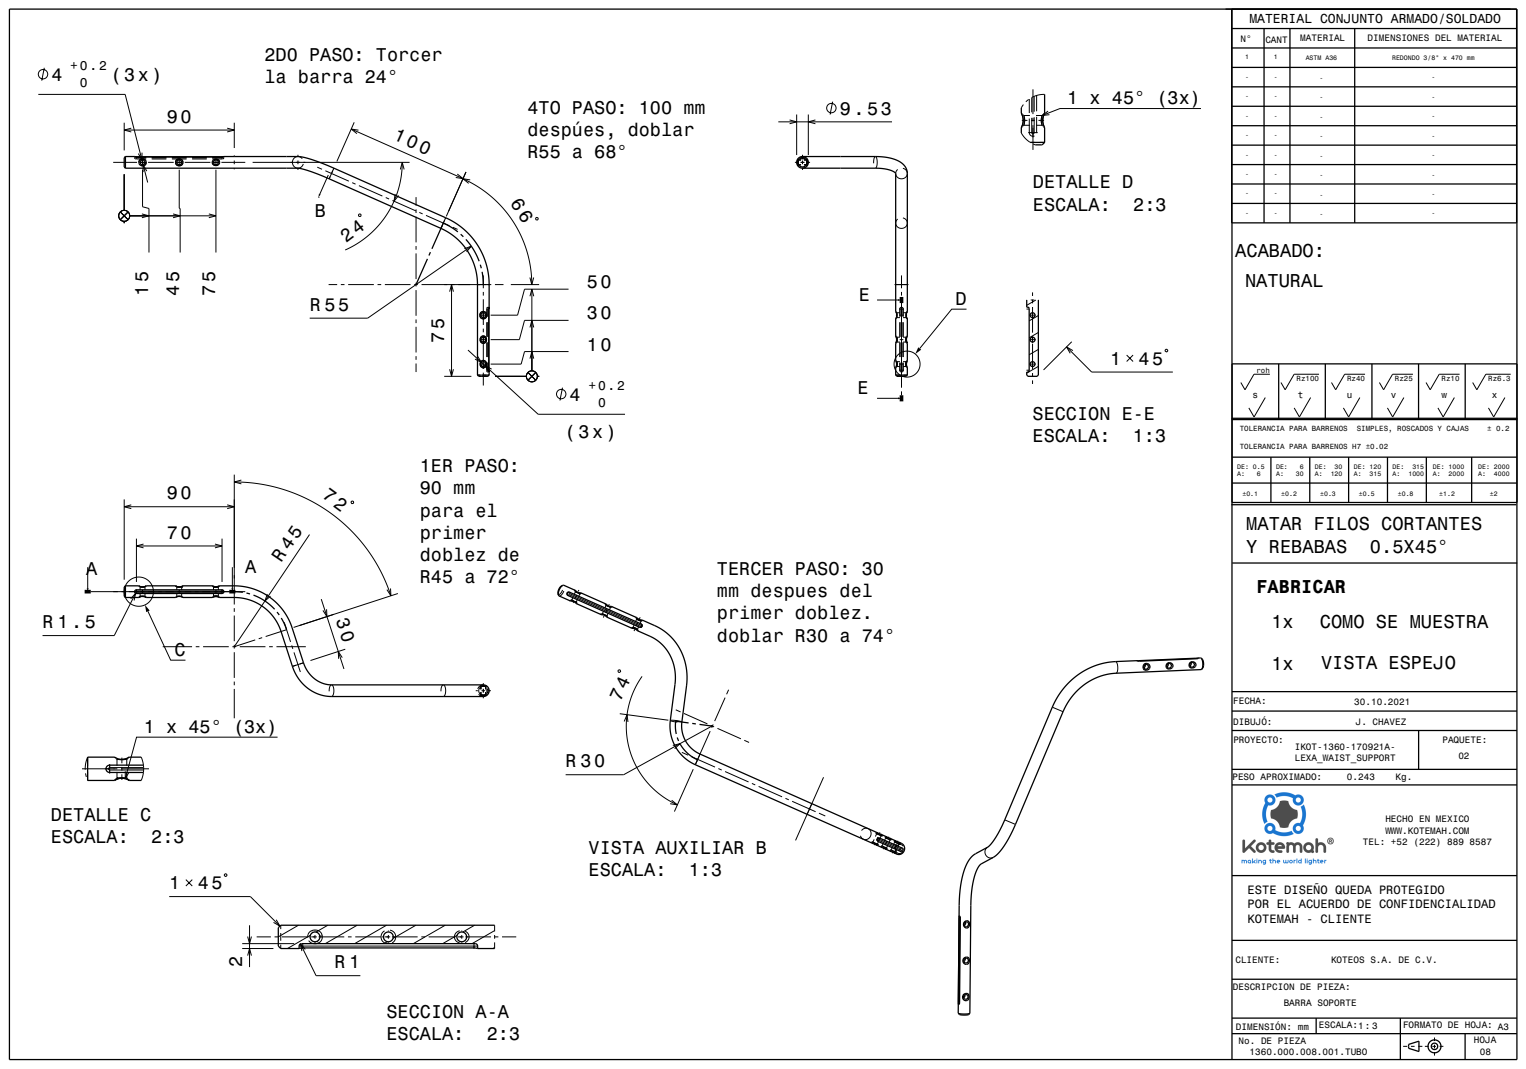
[picture p160: page 1]
BARRA SOPORTE; MATAR FILOS CORTANTES Y REBABAS 0.5X45°; TOLERANCIA PARA BARRENOS SIMPLES, ROSCADOS Y CAJAS; PESO APROXIMADO:; KOTEOS S.A. DE C.V.; J. CHAVEZ; COMO SE MUESTRA; VISTA ESPEJO; SECCION A-A ESCALA: 2:3; VISTA AUXILIAR B ESCALA: 1:3; 1ER PASO: 90 mm para el; doblez de R45 a 72°; 2D0 PASO: Torcer la barra 24°; 4TO PASO: 100 mm despúes, doblar R55 a 68°; DETALLE C ESCALA: 2:3; DETALLE D ESCALA: 2:3; SECCION E-E ESCALA: 1:3

MATERIAL CONJUNTO ARMADO/SOLDADO

N° | CANT | MATERIAL | DIMENSIONES DEL MATERIAL

1 | 1 | ASTM A36 | REDONDO 3/8" x 470 mm

TOLERANCIA PARA BARRENOS H7 ±0.02

TERCER PASO: 30
mm despues del
primer doblez.
doblar R30 a 74°

HECHO EN MEXICO
WWW.KOTEMAH.COM
TEL: +52 (222) 889 8587

ESTE DISEÑO QUEDA PROTEGIDO
POR EL ACUERDO DE CONFIDENCIALIDAD
KOTEMAH - CLIENTE

DESCRIPCION DE PIEZA:

DIMENSIÓN: mm | ESCALA: 1 3 : | FORMATO DE HOJA: A3
No. DE PIEZA 1360.000.008.001.TUBO | | | HOJA 08
