koteos/RANDOM/EKOT-1360-170921A-LEXA_WAIST_SUPPORT/FAB/FAB_A/1360 PLANOS DE FABRICACION/1360.000.000.000.WAIST_SUPPORT_HOJA_07.pdf

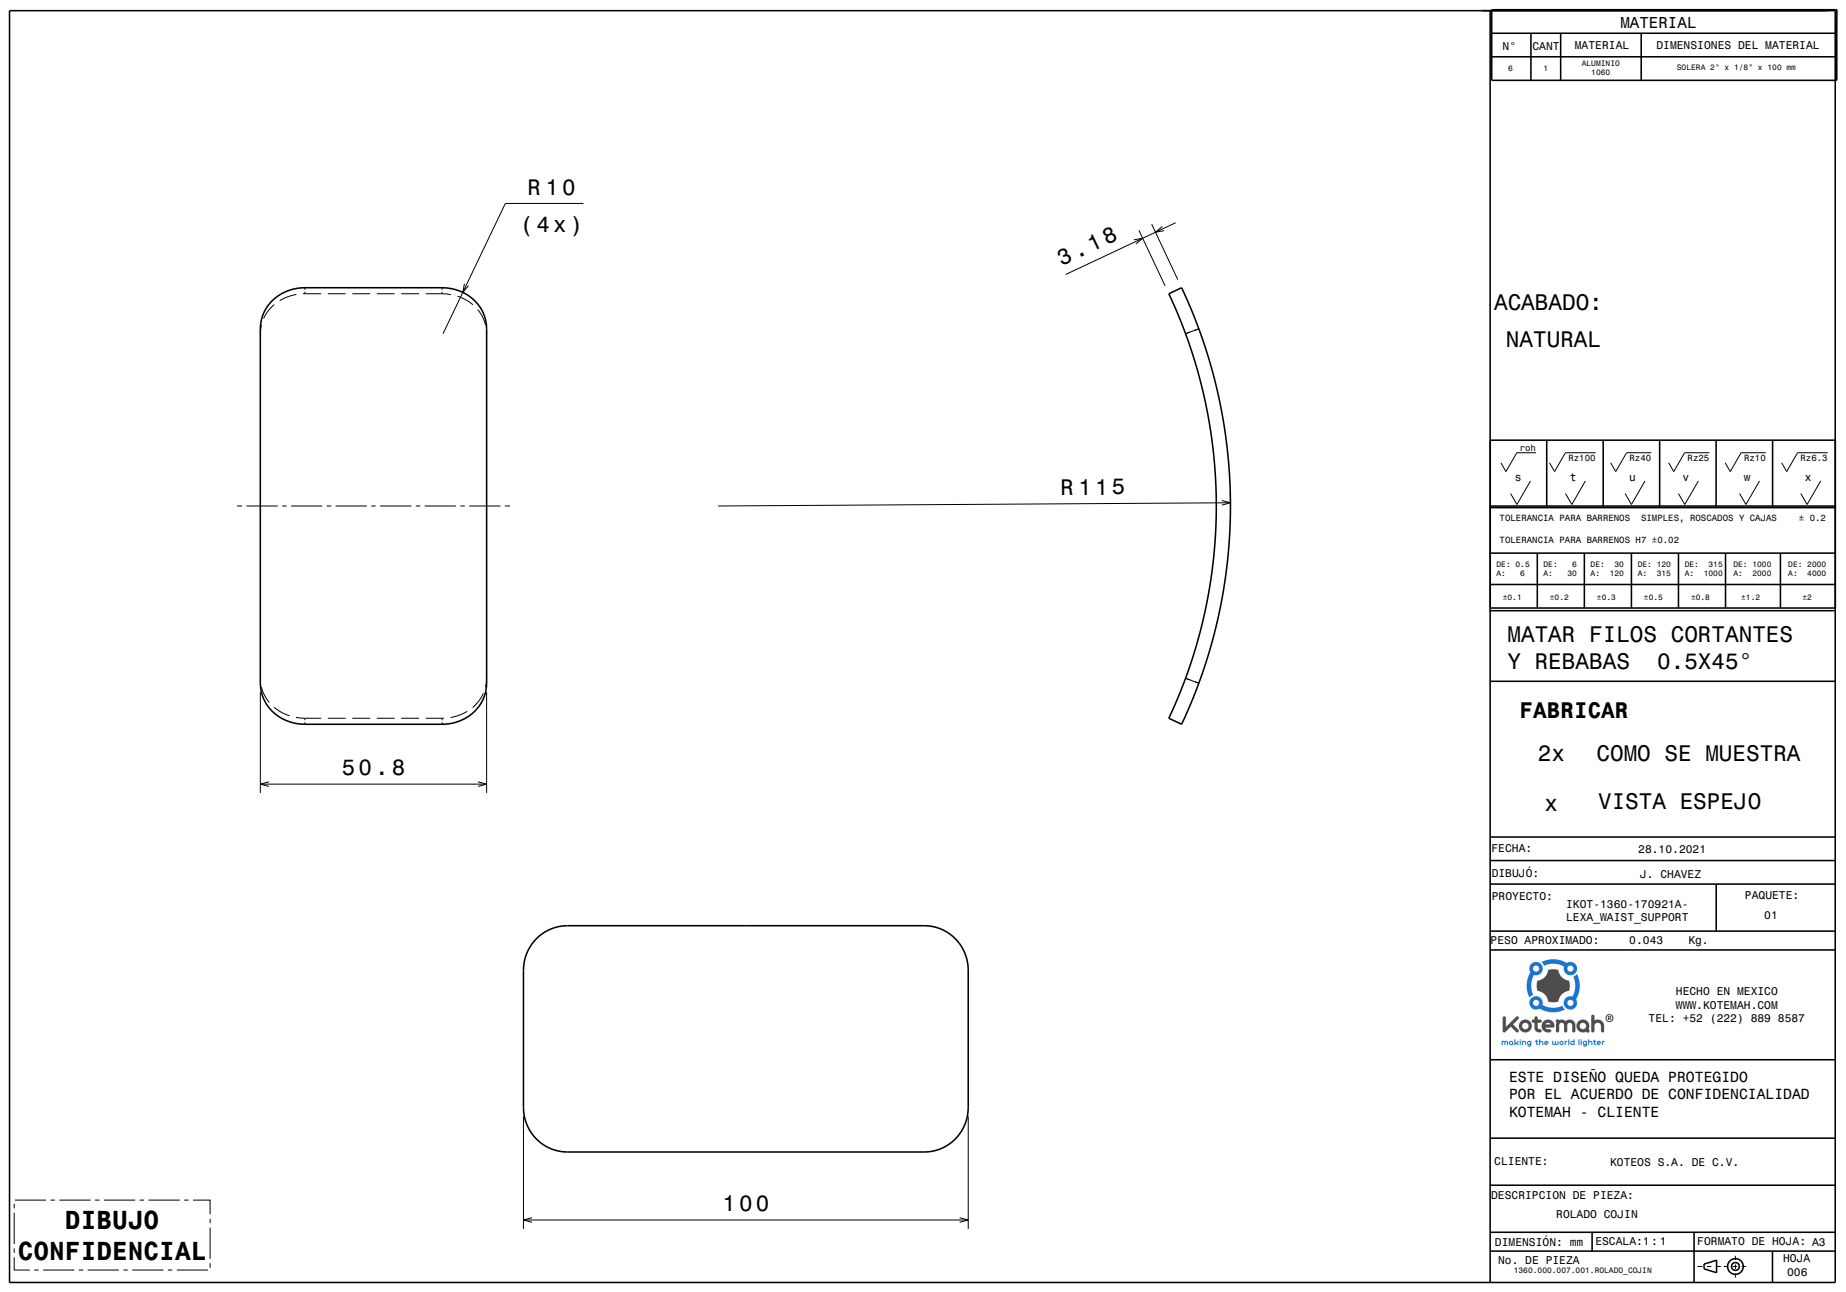
[picture p161: page 1]
ROLADO COJIN; MATAR FILOS CORTANTES Y REBABAS 0.5X45°; TOLERANCIA PARA BARRENOS SIMPLES, ROSCADOS Y CAJAS; PESO APROXIMADO:; KOTEOS S.A. DE C.V.; J. CHAVEZ; VISTA ESPEJO

MATERIAL

N° | CANT | MATERIAL | DIMENSIONES DEL MATERIAL

6 | 1 | ALUMINIO 1060 | SOLERA 2" x 1/8" x 100 mm

TOLERANCIA PARA BARRENOS H7 ±0.02

COMO SE MUESTRA

HECHO EN MEXICO
WWW.KOTEMAH.COM
TEL: +52 (222) 889 8587

ESTE DISEÑO QUEDA PROTEGIDO
POR EL ACUERDO DE CONFIDENCIALIDAD
KOTEMAH - CLIENTE

DESCRIPCION DE PIEZA:

DIMENSIÓN: mm | ESCALA: 1 1 : | FORMATO DE HOJA: A3
No. DE PIEZA 1360.000.007.001.ROLADO_COJIN | | | HOJA 006
