koteos/RANDOM/EKOT-1360-170921A-LEXA_WAIST_SUPPORT/FAB/FAB_A/PLANOS DE FABRICACION CADERA/1360.000.000.000.WAIST_SUPPORT_A3_DESPIECE_1.pdf

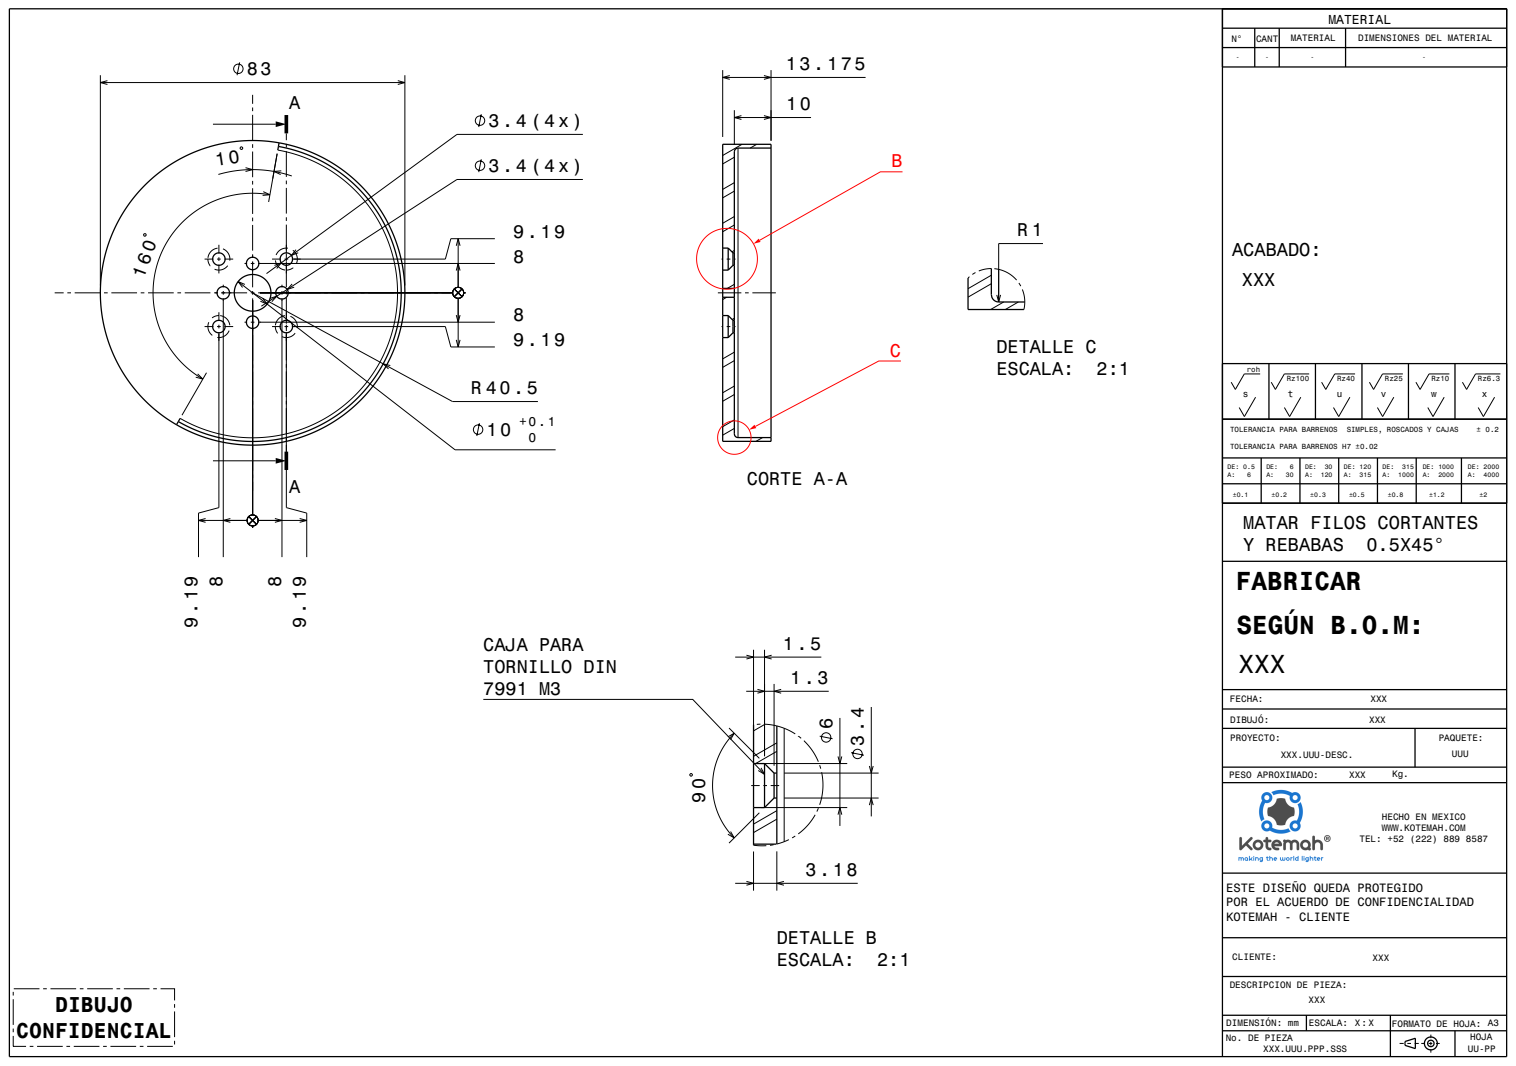
[picture p162: page 1]
MATAR FILOS CORTANTES Y REBABAS 0.5X45°; TOLERANCIA PARA BARRENOS SIMPLES, ROSCADOS Y CAJAS; PESO APROXIMADO:; SEGÚN B.O.M:; CORTE A-A; DETALLE B ESCALA: 2:1; CAJA PARA TORNILLO DIN 7991 M3; DETALLE C ESCALA: 2:1

83 | MATERIAL

N° | CANT | MATERIAL | DIMENSIONES DEL MATERIAL

TOLERANCIA PARA BARRENOS H7 ±0.02

XXX.UUU-DESC.

HECHO EN MEXICO
WWW.KOTEMAH.COM
TEL: +52 (222) 889 8587

ESTE DISEÑO QUEDA PROTEGIDO
POR EL ACUERDO DE CONFIDENCIALIDAD
KOTEMAH - CLIENTE

DESCRIPCION DE PIEZA:

DIMENSIÓN: mm | ESCALA: X X : | FORMATO DE HOJA: A3
No. DE PIEZA XXX.UUU.PPP.SSS | | | HOJA UU-PP
