koteos/RANDOM/EKOT-1360-170921A-LEXA_WAIST_SUPPORT/FAB/FAB_A/PLANOS DE FABRICACION CADERA/1360.000.000.000.WAIST_SUPPORT_HOJA_008_001.pdf

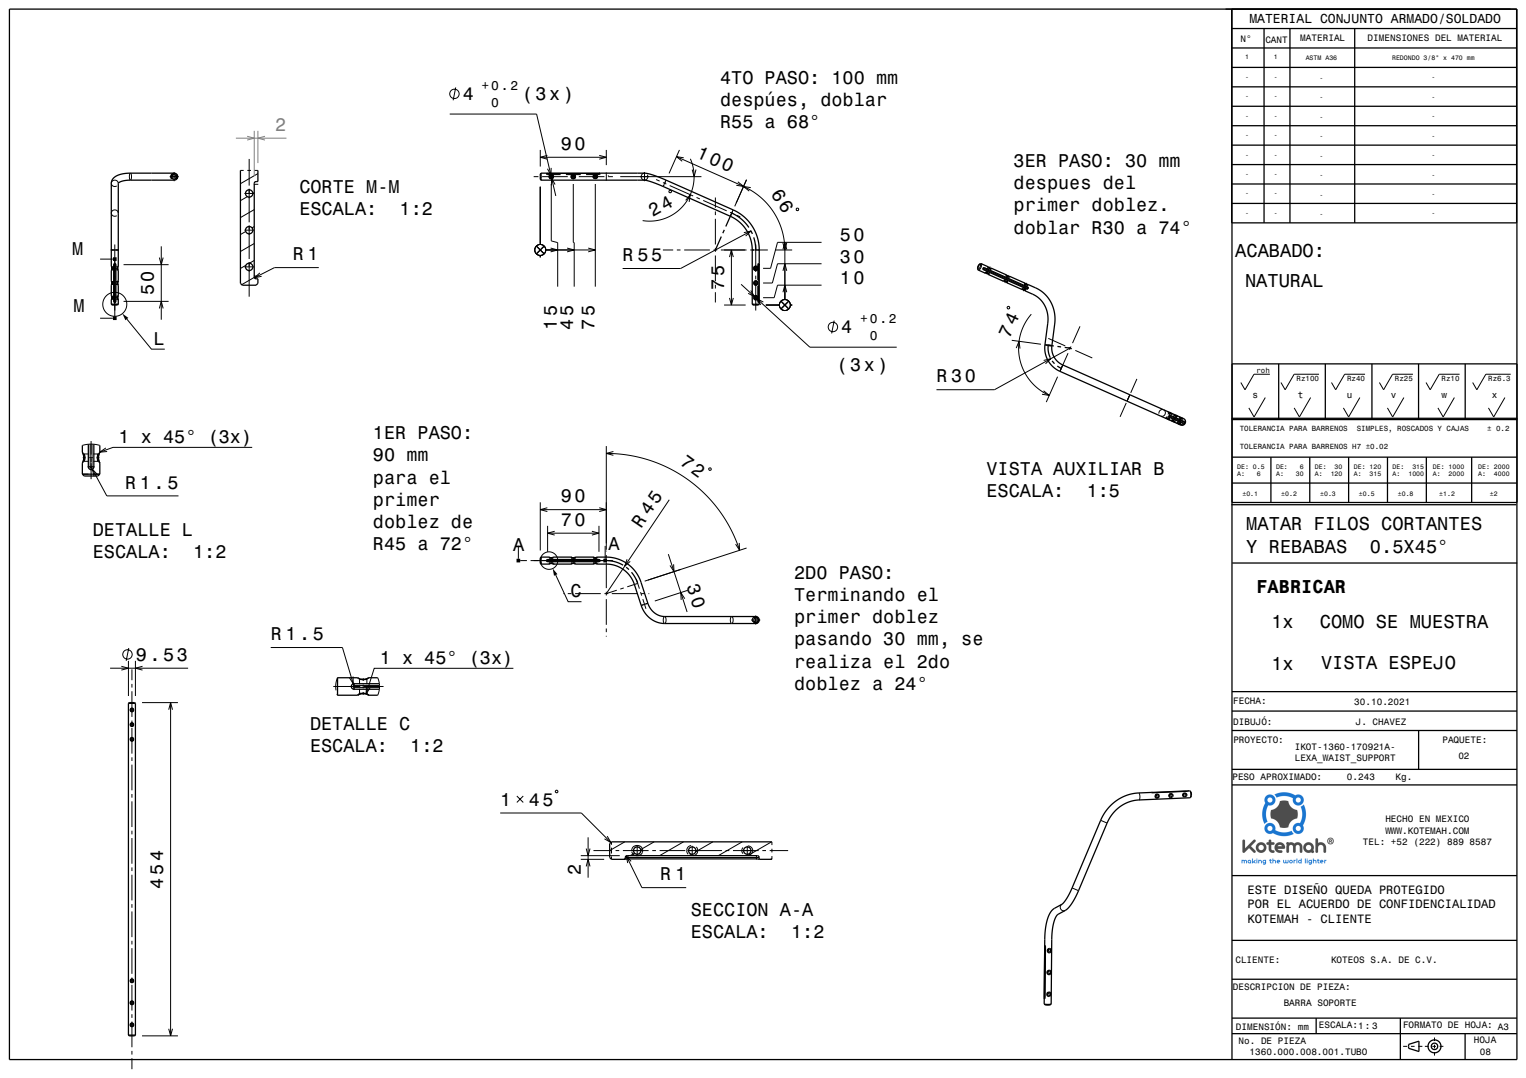
[picture p163: page 1]
BARRA SOPORTE; MATAR FILOS CORTANTES Y REBABAS 0.5X45°; TOLERANCIA PARA BARRENOS SIMPLES, ROSCADOS Y CAJAS; PESO APROXIMADO:; KOTEOS S.A. DE C.V.; J. CHAVEZ; COMO SE MUESTRA; VISTA ESPEJO; SECCION A-A ESCALA: 1:2; VISTA AUXILIAR B ESCALA: 1:5; 1ER PASO: 90 mm para el; doblez de R45 a 72°; 3ER PASO: 30 mm despues del primer doblez. doblar R30 a 74°; 4TO PASO: 100 mm despúes, doblar R55 a 68°; DETALLE C ESCALA: 1:2; DETALLE L ESCALA: 1:2; CORTE M-M ESCALA: 1:2

MATERIAL CONJUNTO ARMADO/SOLDADO

N° | CANT | MATERIAL | DIMENSIONES DEL MATERIAL

1 | 1 | ASTM A36 | REDONDO 3/8" x 470 mm

TOLERANCIA PARA BARRENOS H7 ±0.02

2D0 PASO:
Terminando el
primer doblez
pasando 30 mm, se
realiza el 2do
doblez a 24°

HECHO EN MEXICO
WWW.KOTEMAH.COM
TEL: +52 (222) 889 8587

ESTE DISEÑO QUEDA PROTEGIDO
POR EL ACUERDO DE CONFIDENCIALIDAD
KOTEMAH - CLIENTE

DESCRIPCION DE PIEZA:

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
