koteos/RANDOM/EKOT-1360-170921A-LEXA_WAIST_SUPPORT/FAB/FAB_A/PLANOS DE FABRICACION CADERA/1360.000.000.000.WAIST_SUPPORT_HOJA_01_ENSAMBLE.pdf

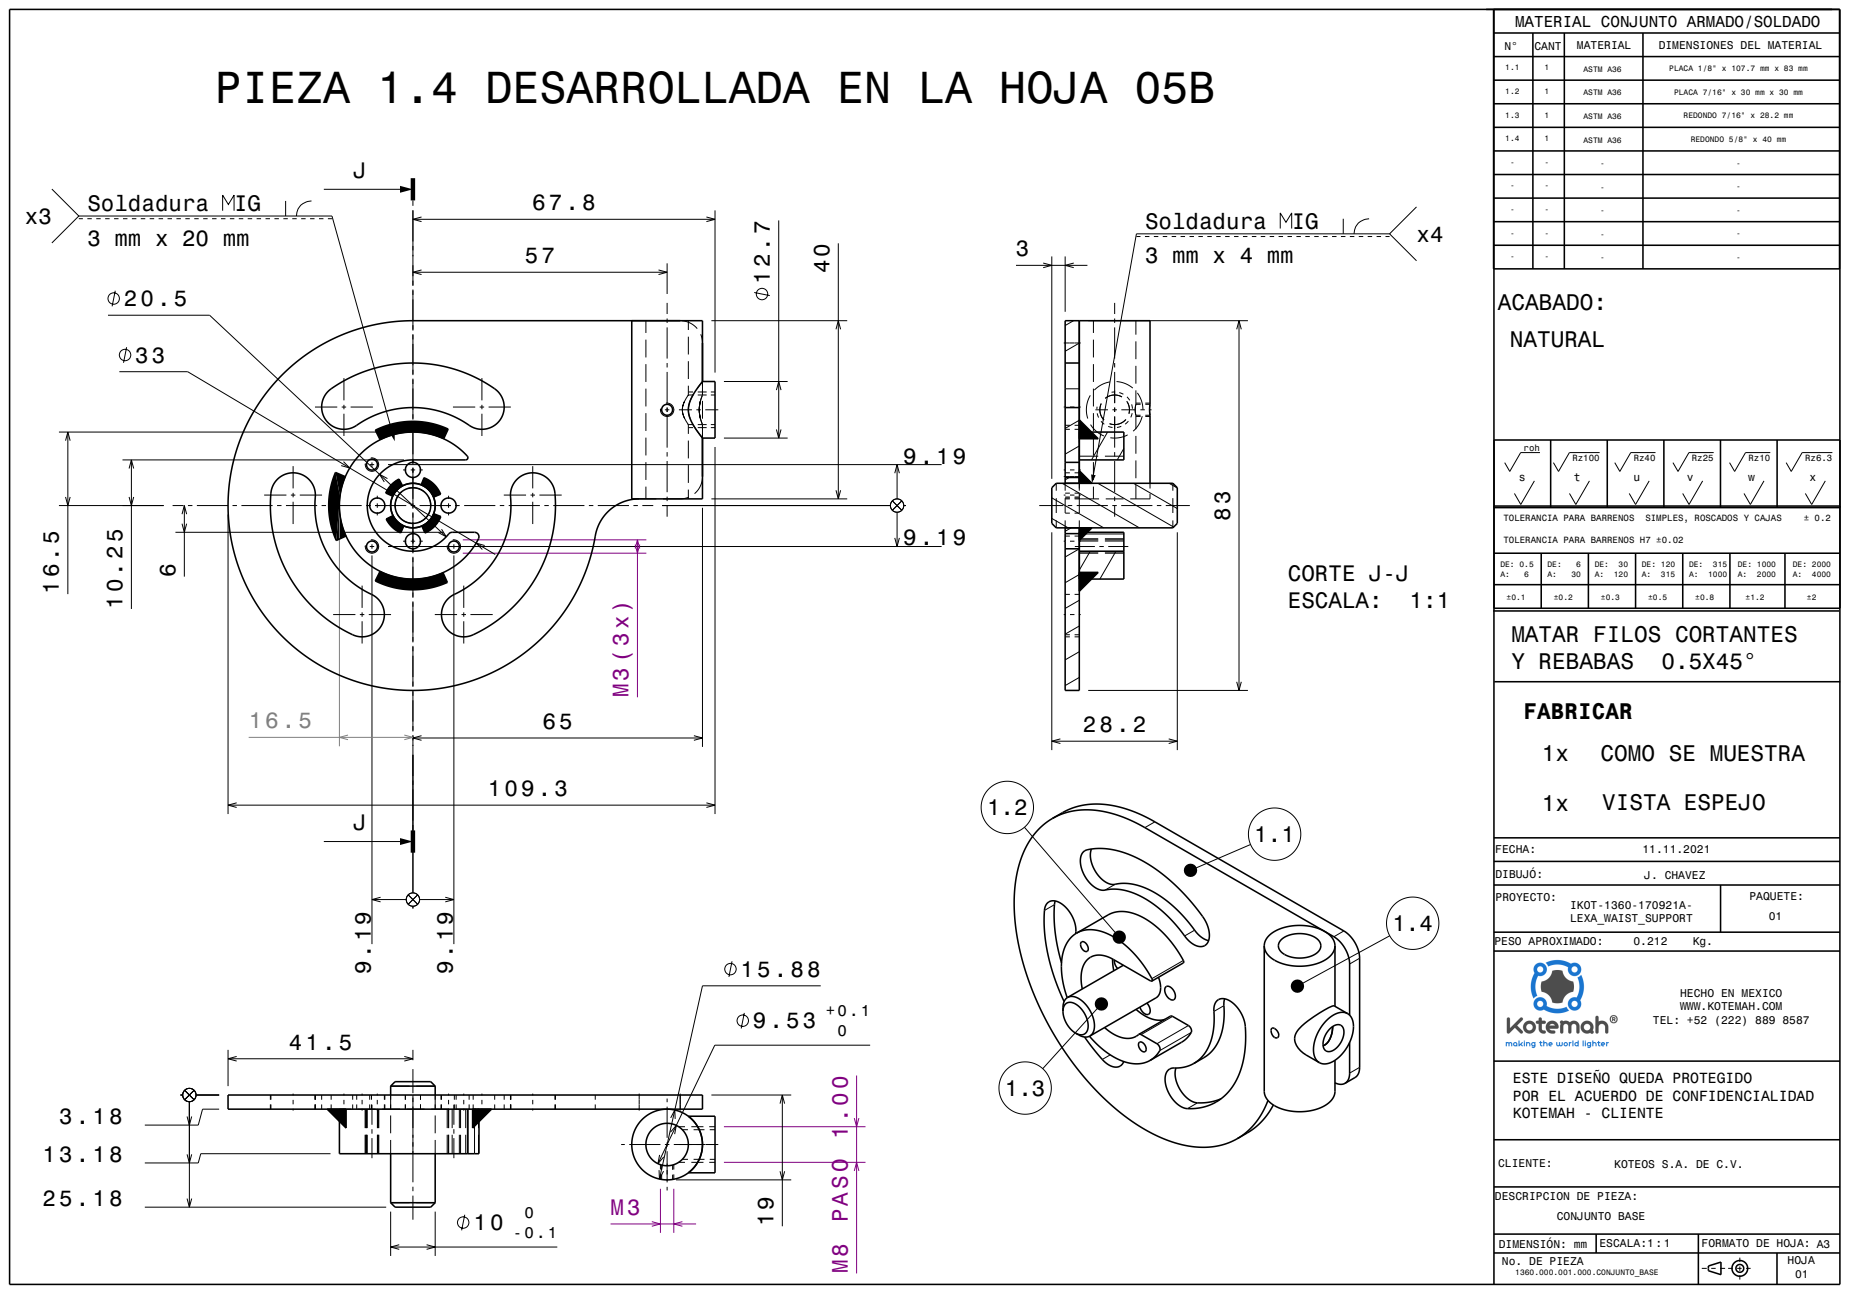
[picture p164: page 1]
CONJUNTO BASE; MATAR FILOS CORTANTES Y REBABAS 0.5X45°; TOLERANCIA PARA BARRENOS SIMPLES, ROSCADOS Y CAJAS; PESO APROXIMADO:; KOTEOS S.A. DE C.V.; J. CHAVEZ; COMO SE MUESTRA; VISTA ESPEJO; Soldadura IG 3 mm x 20 mm; PASO 1.00 M8; CORTE J-J ESCALA: 1:1; Soldadura IG 3 mm x 4 mm

PIEZA 1.4 DESARROLLADA EN LA HOJA 05B 67.8 | MATERIAL CONJUNTO ARMADO/SOLDADO

N° | CANT | MATERIAL | DIMENSIONES DEL MATERIAL

1.1 | 1 | ASTM A36 | PLACA 1/8" x 107.7 mm x 83 mm

1.2 | 1 | ASTM A36 | PLACA 7/16" x 30 mm x 30 mm

1.3 | 1 | ASTM A36 | REDONDO 7/16" x 28.2 mm

1.4 | 1 | ASTM A36 | REDONDO 5/8" x 40 mm

TOLERANCIA PARA BARRENOS H7 ±0.02

HECHO EN MEXICO
WWW.KOTEMAH.COM
TEL: +52 (222) 889 8587

ESTE DISEÑO QUEDA PROTEGIDO
POR EL ACUERDO DE CONFIDENCIALIDAD
KOTEMAH - CLIENTE

DESCRIPCION DE PIEZA:

DIMENSIÓN: mm | ESCALA: 1 1 : | FORMATO DE HOJA: A3
No. DE PIEZA 1360.000.001.000.CONJUNTO_BASE | | | HOJA 01
