koteos/RANDOM/EKOT-1360-170921A-LEXA_WAIST_SUPPORT/FAB/FAB_A/PLANOS DE FABRICACION CADERA/1360.000.000.000.WAIST_SUPPORT_HOJA_04_ENSAMBLE.pdf

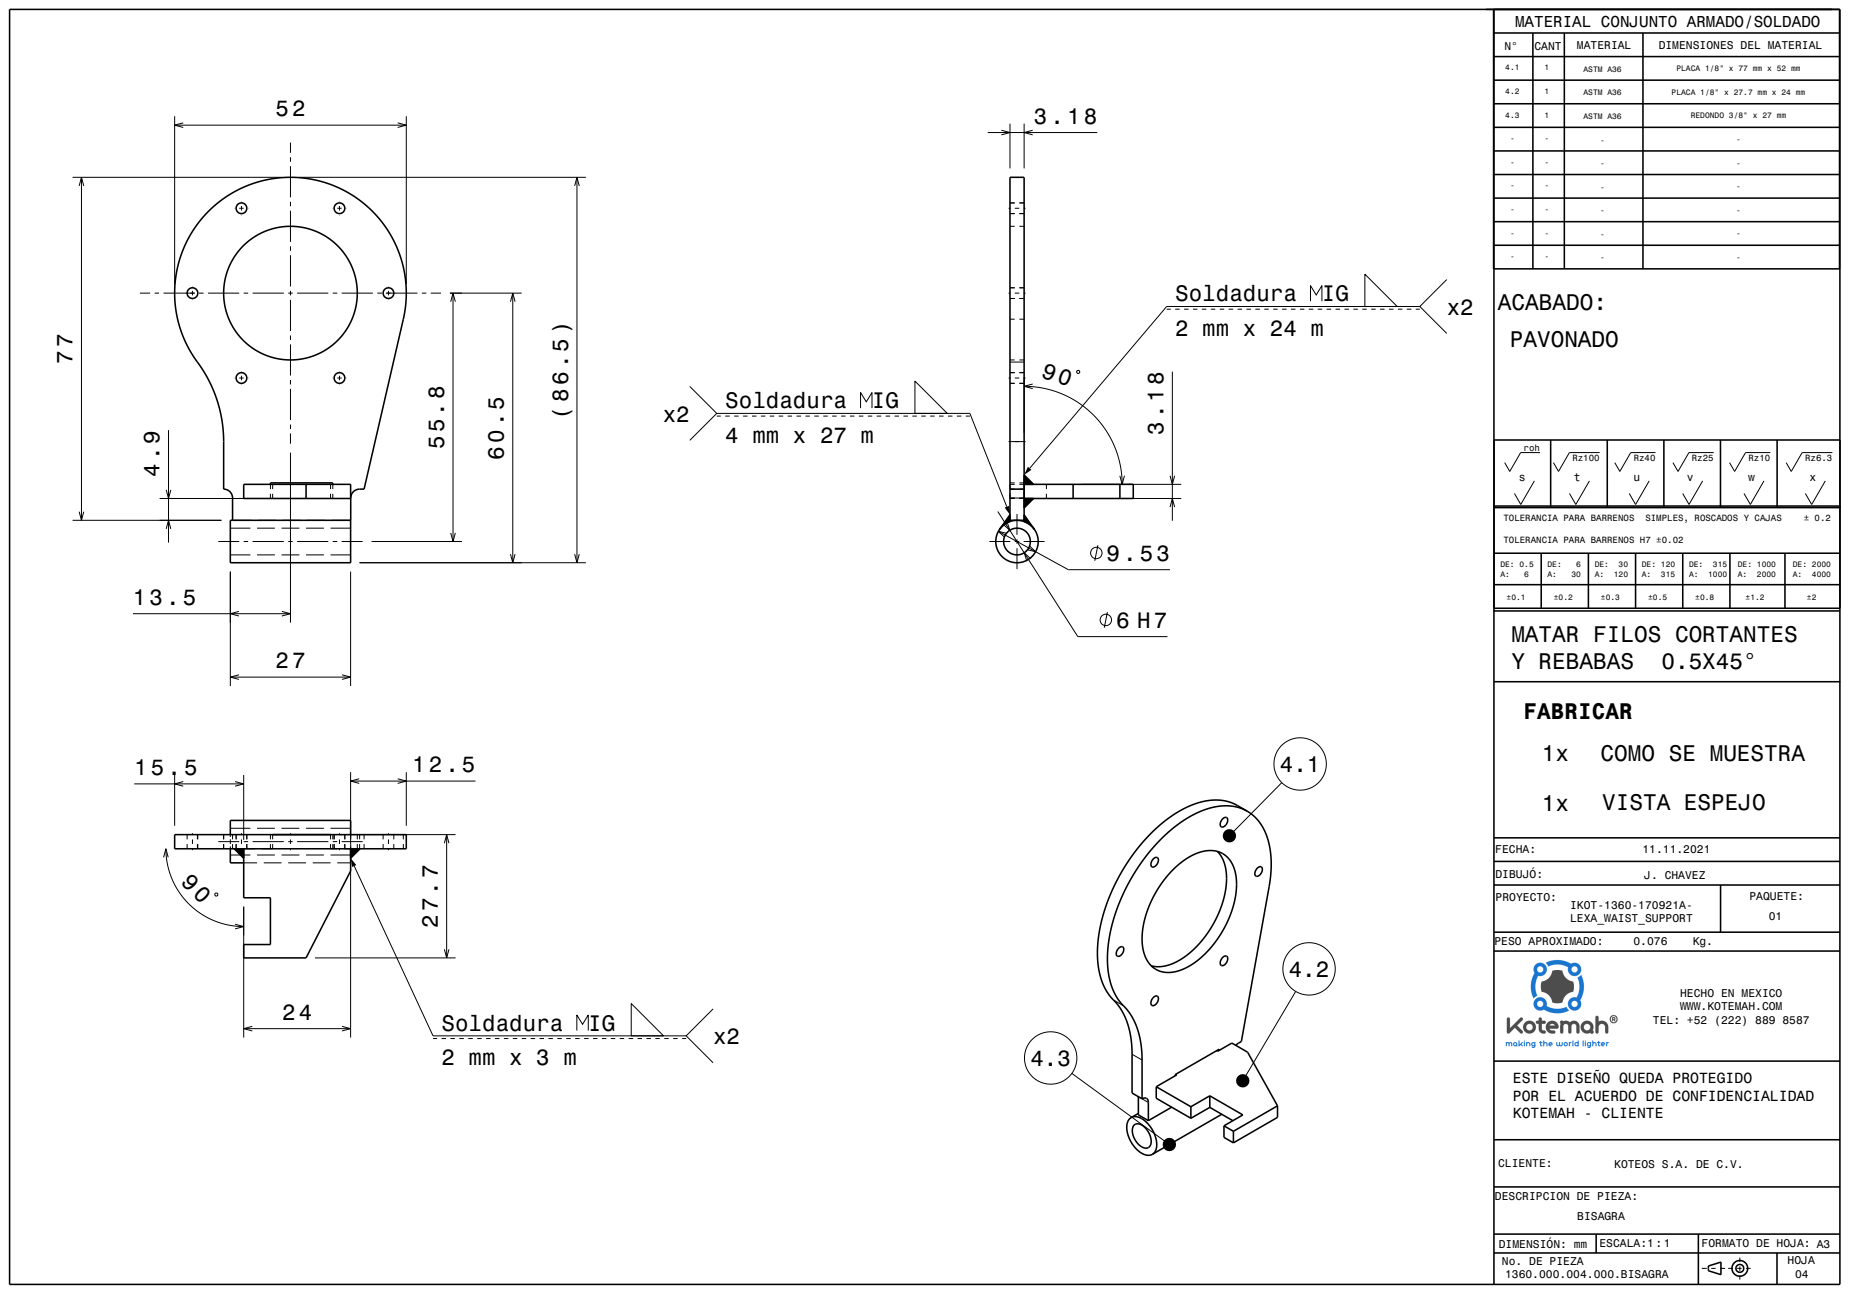
[picture p165: page 1]
MATAR FILOS CORTANTES Y REBABAS 0.5X45°; TOLERANCIA PARA BARRENOS SIMPLES, ROSCADOS Y CAJAS; PESO APROXIMADO:; KOTEOS S.A. DE C.V.; J. CHAVEZ; COMO SE MUESTRA; VISTA ESPEJO; Soldadura IG 2 mm x 24 m; Soldadura IG 4 mm x 27 m; Soldadura IG

52 | MATERIAL CONJUNTO ARMADO/SOLDADO

N° | CANT | MATERIAL | DIMENSIONES DEL MATERIAL

4.1 | 1 | ASTM A36 | PLACA 1/8" x 77 mm x 52 mm

4.2 | 1 | ASTM A36 | PLACA 1/8" x 27.7 mm x 24 mm

4.3 | 1 | ASTM A36 | REDONDO 3/8" x 27 mm

TOLERANCIA PARA BARRENOS H7 ±0.02

HECHO EN MEXICO
WWW.KOTEMAH.COM
TEL: +52 (222) 889 8587

ESTE DISEÑO QUEDA PROTEGIDO
POR EL ACUERDO DE CONFIDENCIALIDAD
KOTEMAH - CLIENTE

DESCRIPCION DE PIEZA:

DIMENSIÓN: mm | ESCALA: 1 1 : | FORMATO DE HOJA: A3
No. DE PIEZA 1360.000.004.000.BISAGRA | | | HOJA 04
