koteos/RANDOM/EKOT-1360-170921A-LEXA_WAIST_SUPPORT/FAB/FAB_A/PLANOS DE FABRICACION CADERA/1360.000.000.000.WAIST_SUPPORT_HOJA_05_002.pdf

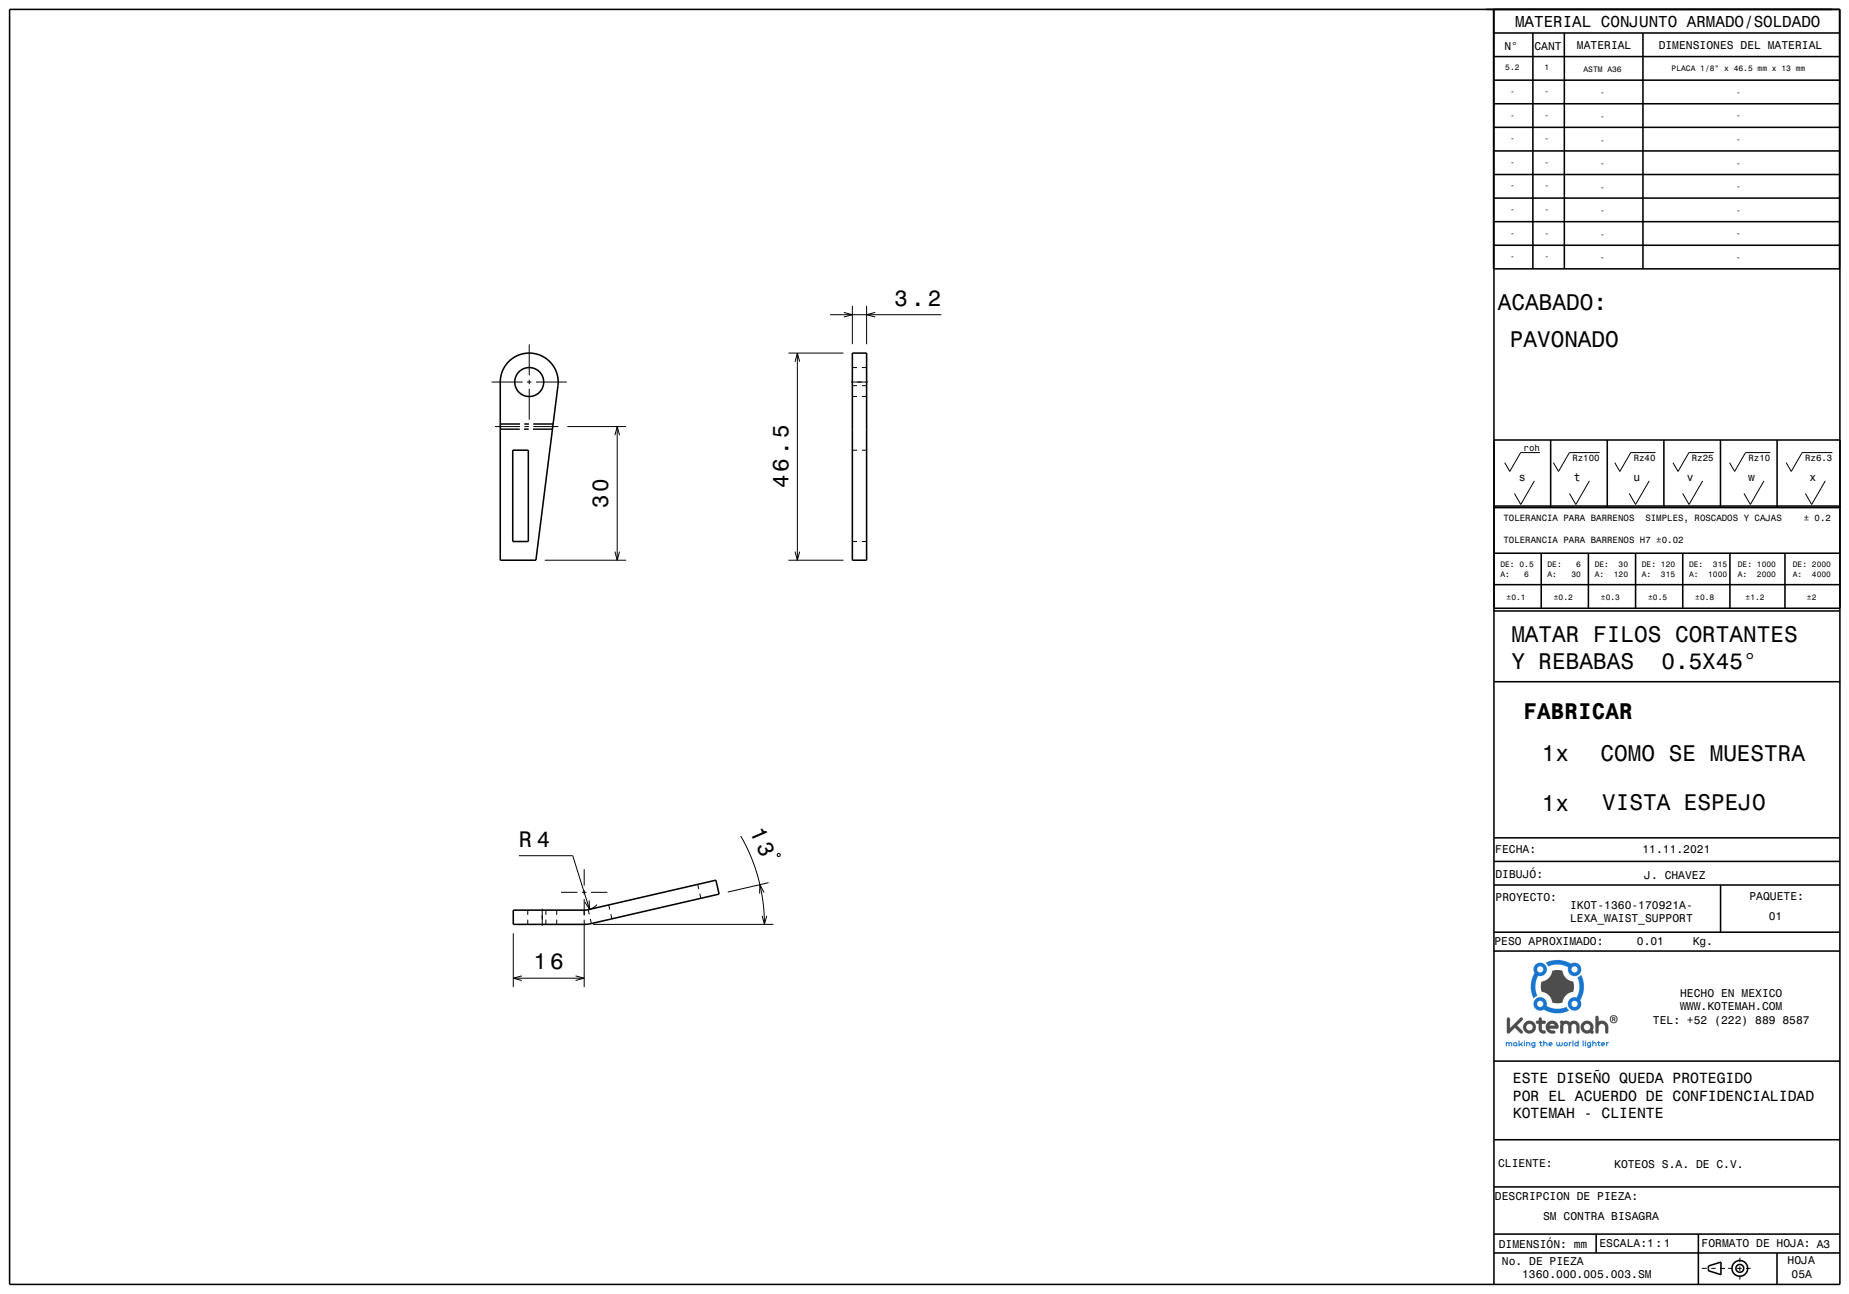
[picture p166: page 1]
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

MATERIAL CONJUNTO ARMADO/SOLDADO

N° | CANT | MATERIAL | DIMENSIONES DEL MATERIAL

5.2 | 1 | ASTM A36 | PLACA 1/8" x 46.5 mm x 13 mm

- | - | | -----

TOLERANCIA PARA BARRENOS H7 ±0.02

HECHO EN MEXICO
WWW.KOTEMAH.COM
TEL: +52 (222) 889 8587

ESTE DISEÑO QUEDA PROTEGIDO
POR EL ACUERDO DE CONFIDENCIALIDAD
KOTEMAH - CLIENTE

DESCRIPCION DE PIEZA:

SM CONTRA BISAGRA

DIMENSIÓN: mm | ESCALA: : 1 | FORMATO DE HOJA: A3
No. DE PIEZA 1360.000.005.003.SM | | | HOJA 05A
