koteos/RANDOM/EKOT-1360-170921A-LEXA_WAIST_SUPPORT/FAB/FAB_A/PLANOS DE FABRICACION CADERA/1360.000.000.000.WAIST_SUPPORT_HOJA_05_004.pdf

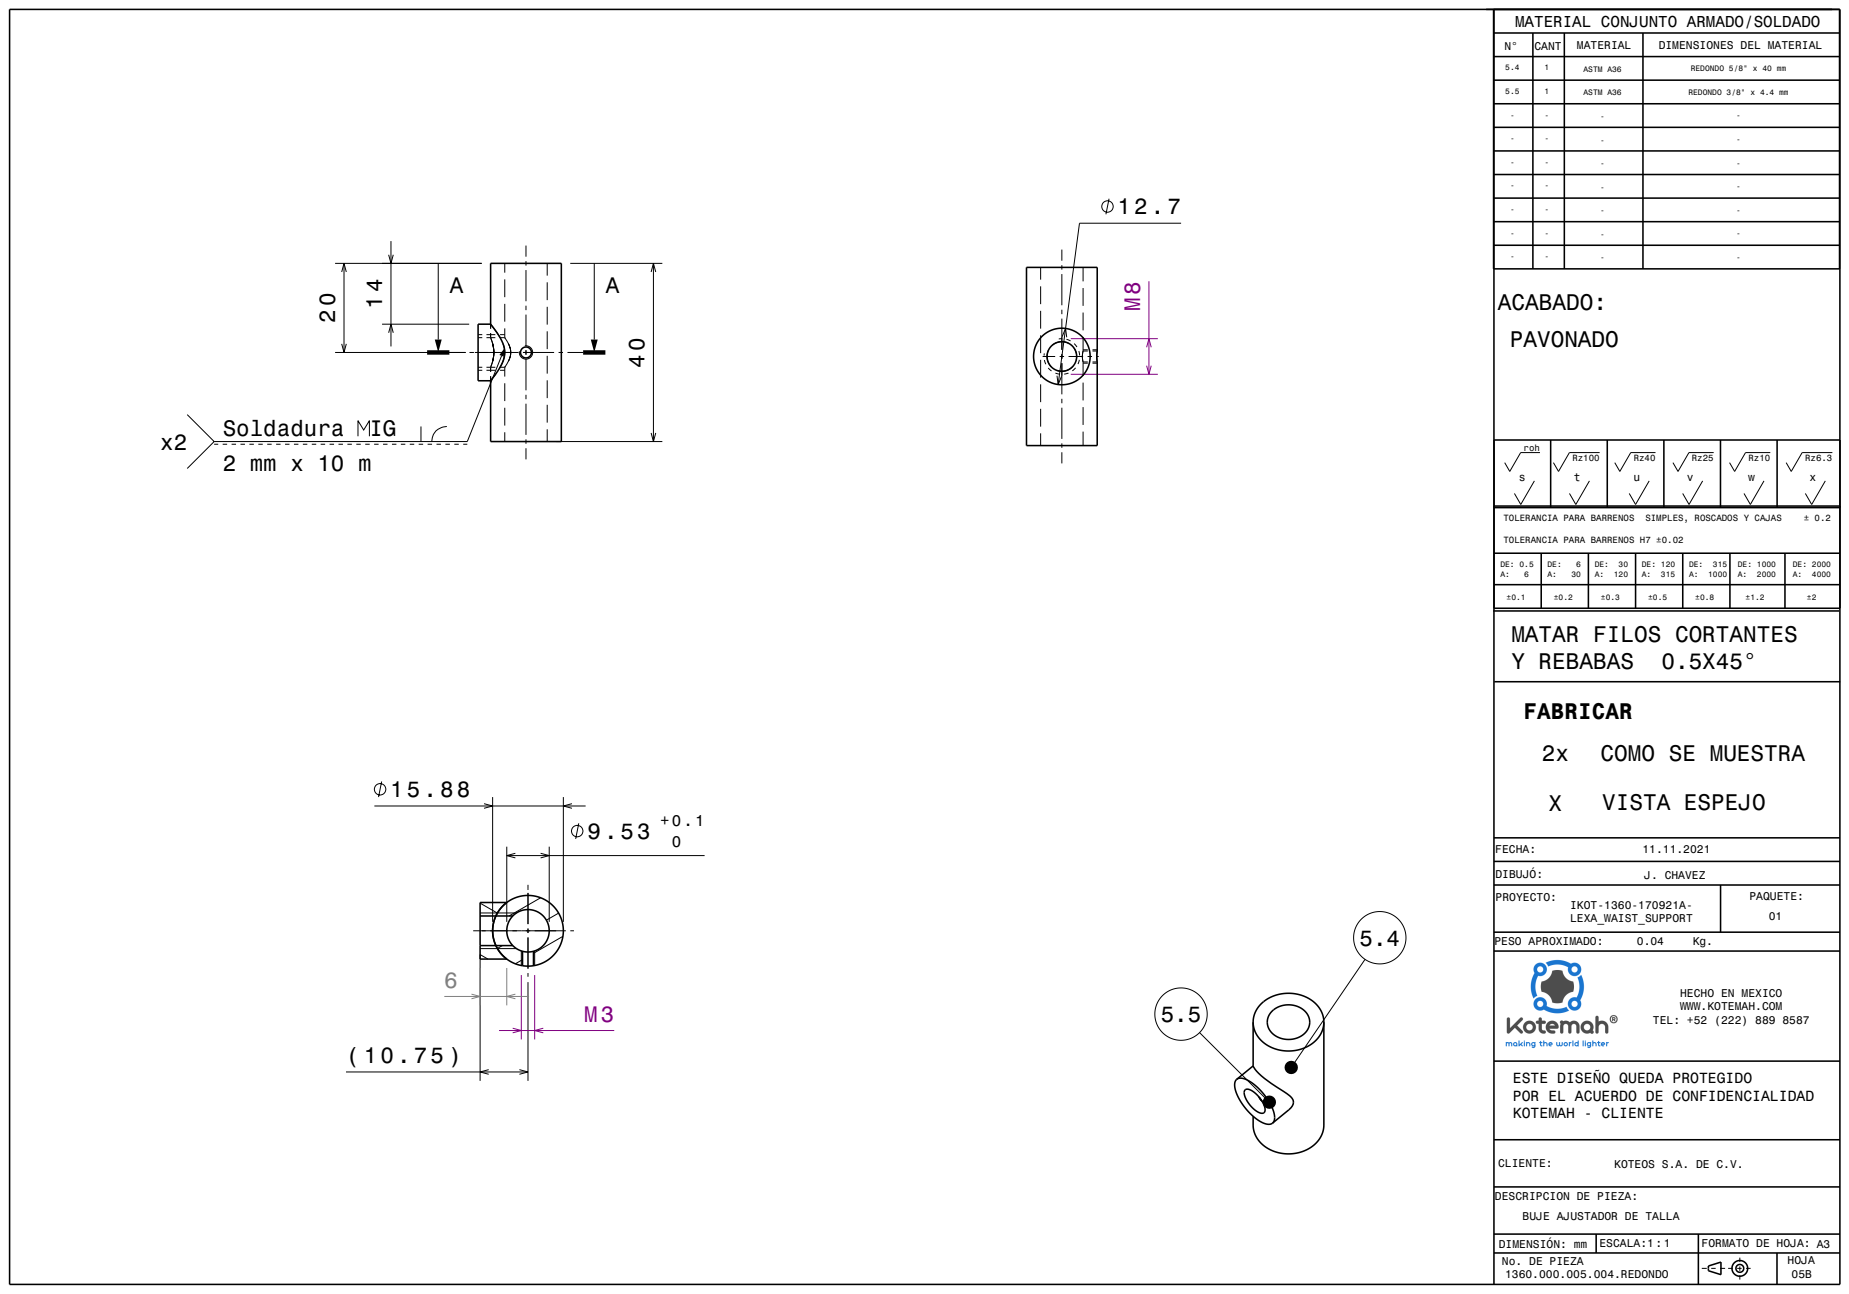
[picture p167: page 1]
MATAR FILOS CORTANTES Y REBABAS 0.5X45°; TOLERANCIA PARA BARRENOS SIMPLES, ROSCADOS Y CAJAS; PESO APROXIMADO:; KOTEOS S.A. DE C.V.; J. CHAVEZ; COMO SE MUESTRA; VISTA ESPEJO; Soldadura IG 2 mm x 10 m

MATERIAL CONJUNTO ARMADO/SOLDADO

N° | CANT | MATERIAL | DIMENSIONES DEL MATERIAL

5.4 | 1 | ASTM A36 | REDONDO 5/8" x 40 mm

5.5 | 1 | ASTM A36 | REDONDO 3/8" x 4.4 mm

TOLERANCIA PARA BARRENOS H7 ±0.02

HECHO EN MEXICO
WWW.KOTEMAH.COM
TEL: +52 (222) 889 8587

ESTE DISEÑO QUEDA PROTEGIDO
POR EL ACUERDO DE CONFIDENCIALIDAD
KOTEMAH - CLIENTE

DESCRIPCION DE PIEZA:
BUJE AJUSTADOR DE TALLA

DIMENSIÓN: mm | ESCALA: 1 1 : | FORMATO DE HOJA: A3
No. DE PIEZA 1360.000.005.004.REDONDO | | | HOJA 05B
