koteos/RANDOM/EKOT-1360-170921A-LEXA_WAIST_SUPPORT/FAB/FAB_A/PLANOS DE FABRICACION CADERA/1360.000.000.000.WAIST_SUPPORT_HOJA_05_ENSAMBLE.pdf

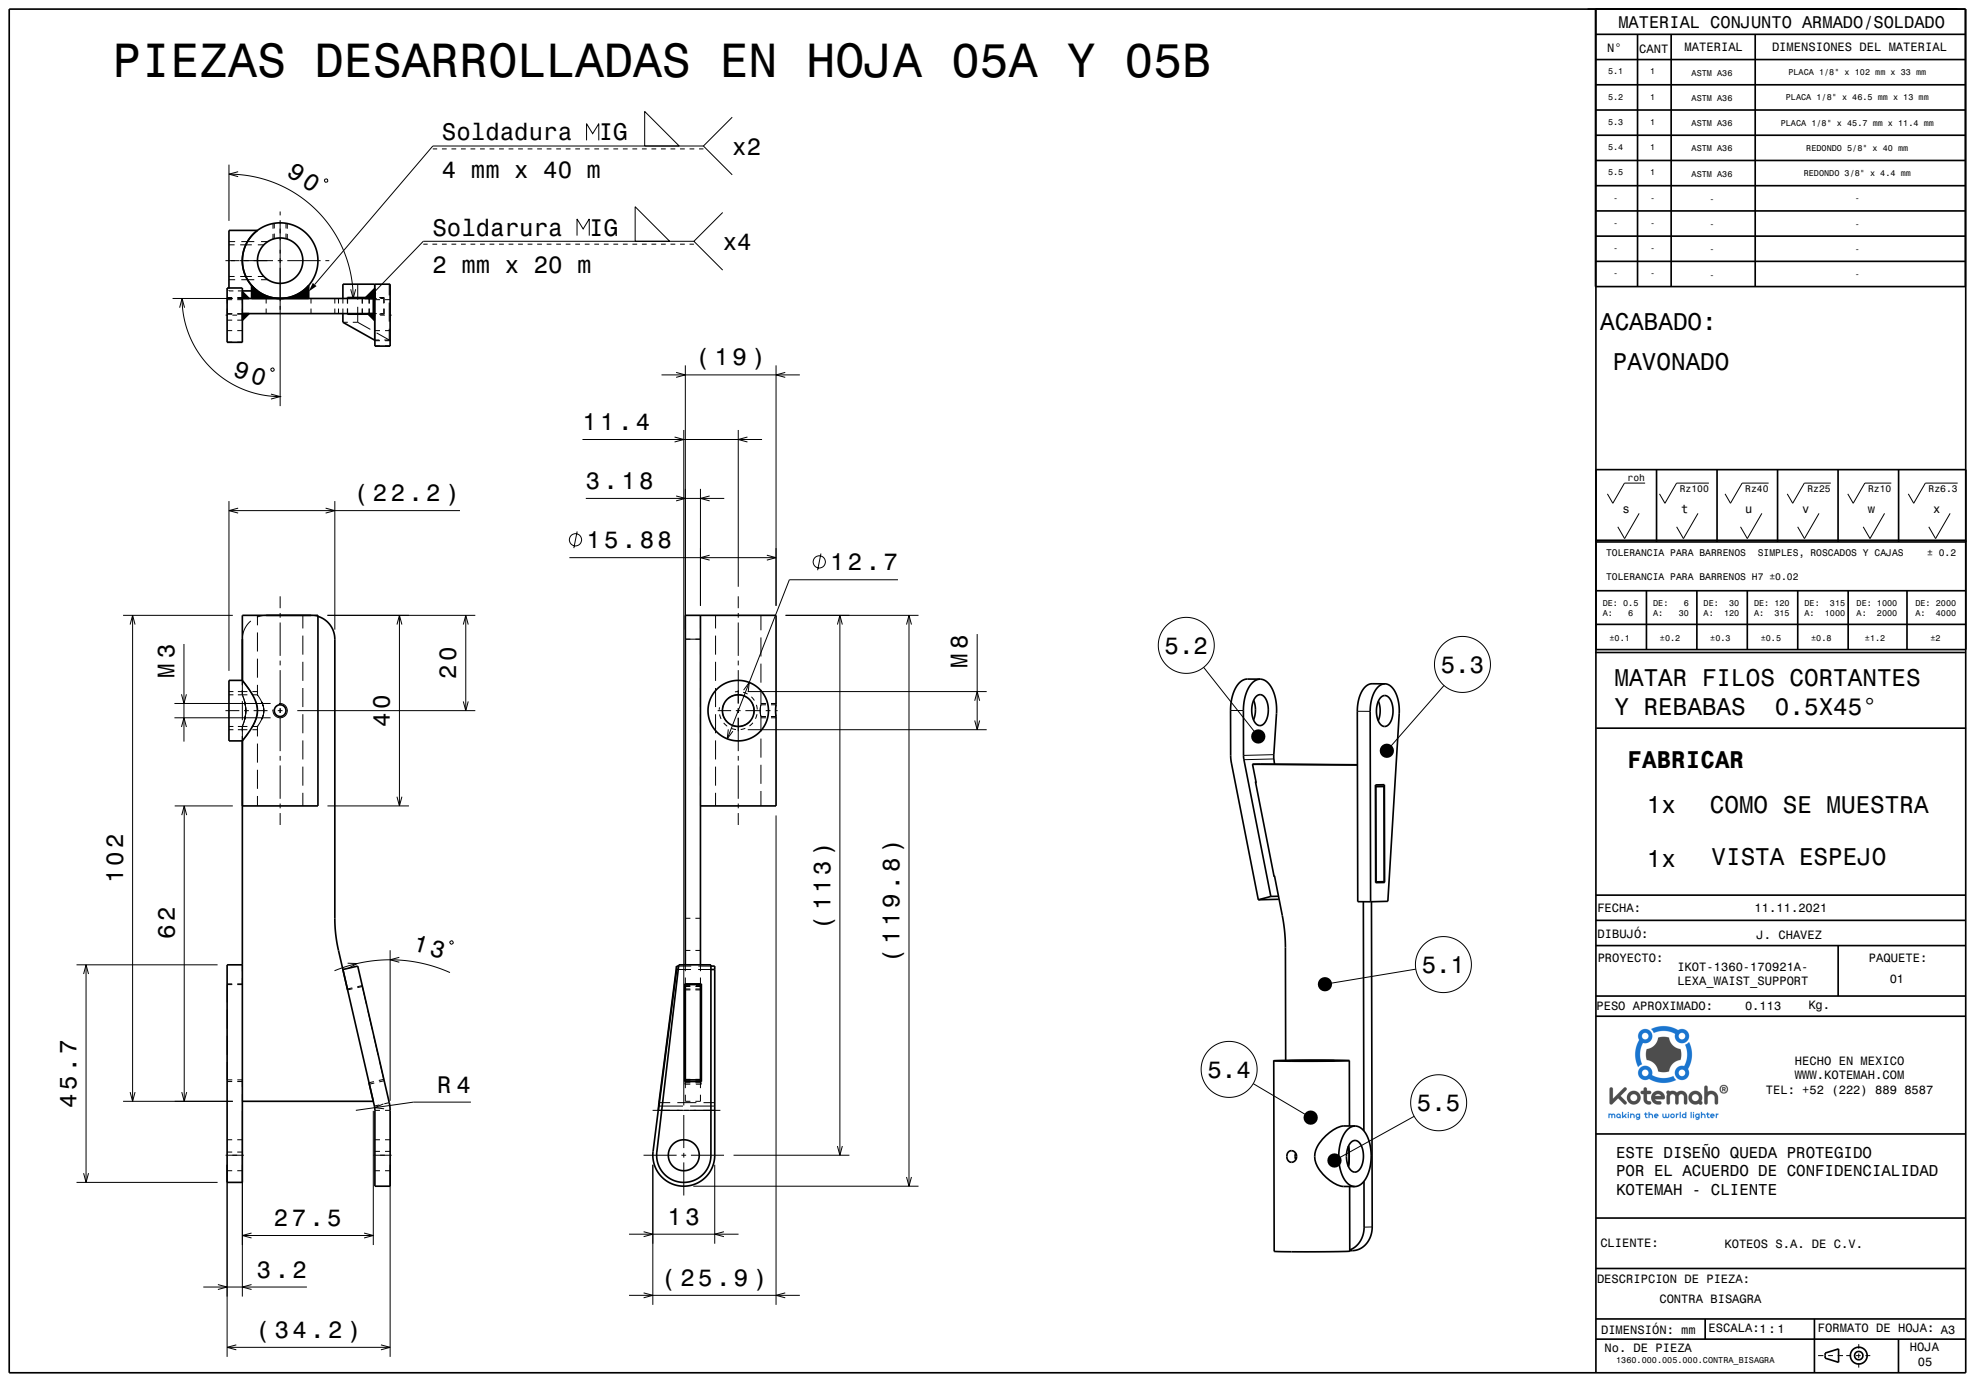
[picture p168: page 1]
CONTRA BISAGRA; MATAR FILOS CORTANTES Y REBABAS 0.5X45°; TOLERANCIA PARA BARRENOS SIMPLES, ROSCADOS Y CAJAS; PESO APROXIMADO:; KOTEOS S.A. DE C.V.; J. CHAVEZ; COMO SE MUESTRA; VISTA ESPEJO; Soldarura IG 2 mm x 20 m; Soldadura IG 4 mm x 40 m

MATERIAL CONJUNTO ARMADO/SOLDADO

PIEZAS DESARROLLADAS EN HOJA 05A Y 05B

N° | CANT | MATERIAL | DIMENSIONES DEL MATERIAL

5.1 | 1 | ASTM A36 | PLACA 1/8" x 102 mm x 33 mm

5.2 | 1 | ASTM A36 | PLACA 1/8" x 46.5 mm x 13 mm

5.3 | 1 | ASTM A36 | PLACA 1/8" x 45.7 mm x 11.4 mm

5.4 | 1 | ASTM A36 | REDONDO 5/8" x 40 mm

5.5 | 1 | ASTM A36 | REDONDO 3/8" x 4.4 mm

TOLERANCIA PARA BARRENOS H7 ±0.02

HECHO EN MEXICO
WWW.KOTEMAH.COM
TEL: +52 (222) 889 8587

ESTE DISEÑO QUEDA PROTEGIDO
POR EL ACUERDO DE CONFIDENCIALIDAD
KOTEMAH - CLIENTE

DESCRIPCION DE PIEZA:

DIMENSIÓN: mm | ESCALA: 1 1 : | FORMATO DE HOJA: A3
No. DE PIEZA 1360.000.005.000.CONTRA_BISAGRA | | | HOJA 05
