koteos/RANDOM/EKOT-1360-170921A-LEXA_WAIST_SUPPORT/FAB/FAB_A/PLANOS DE FABRICACION CADERA/1360.000.000.000.WAIST_SUPPORT_HOJA_08_ENSAMBLE.pdf

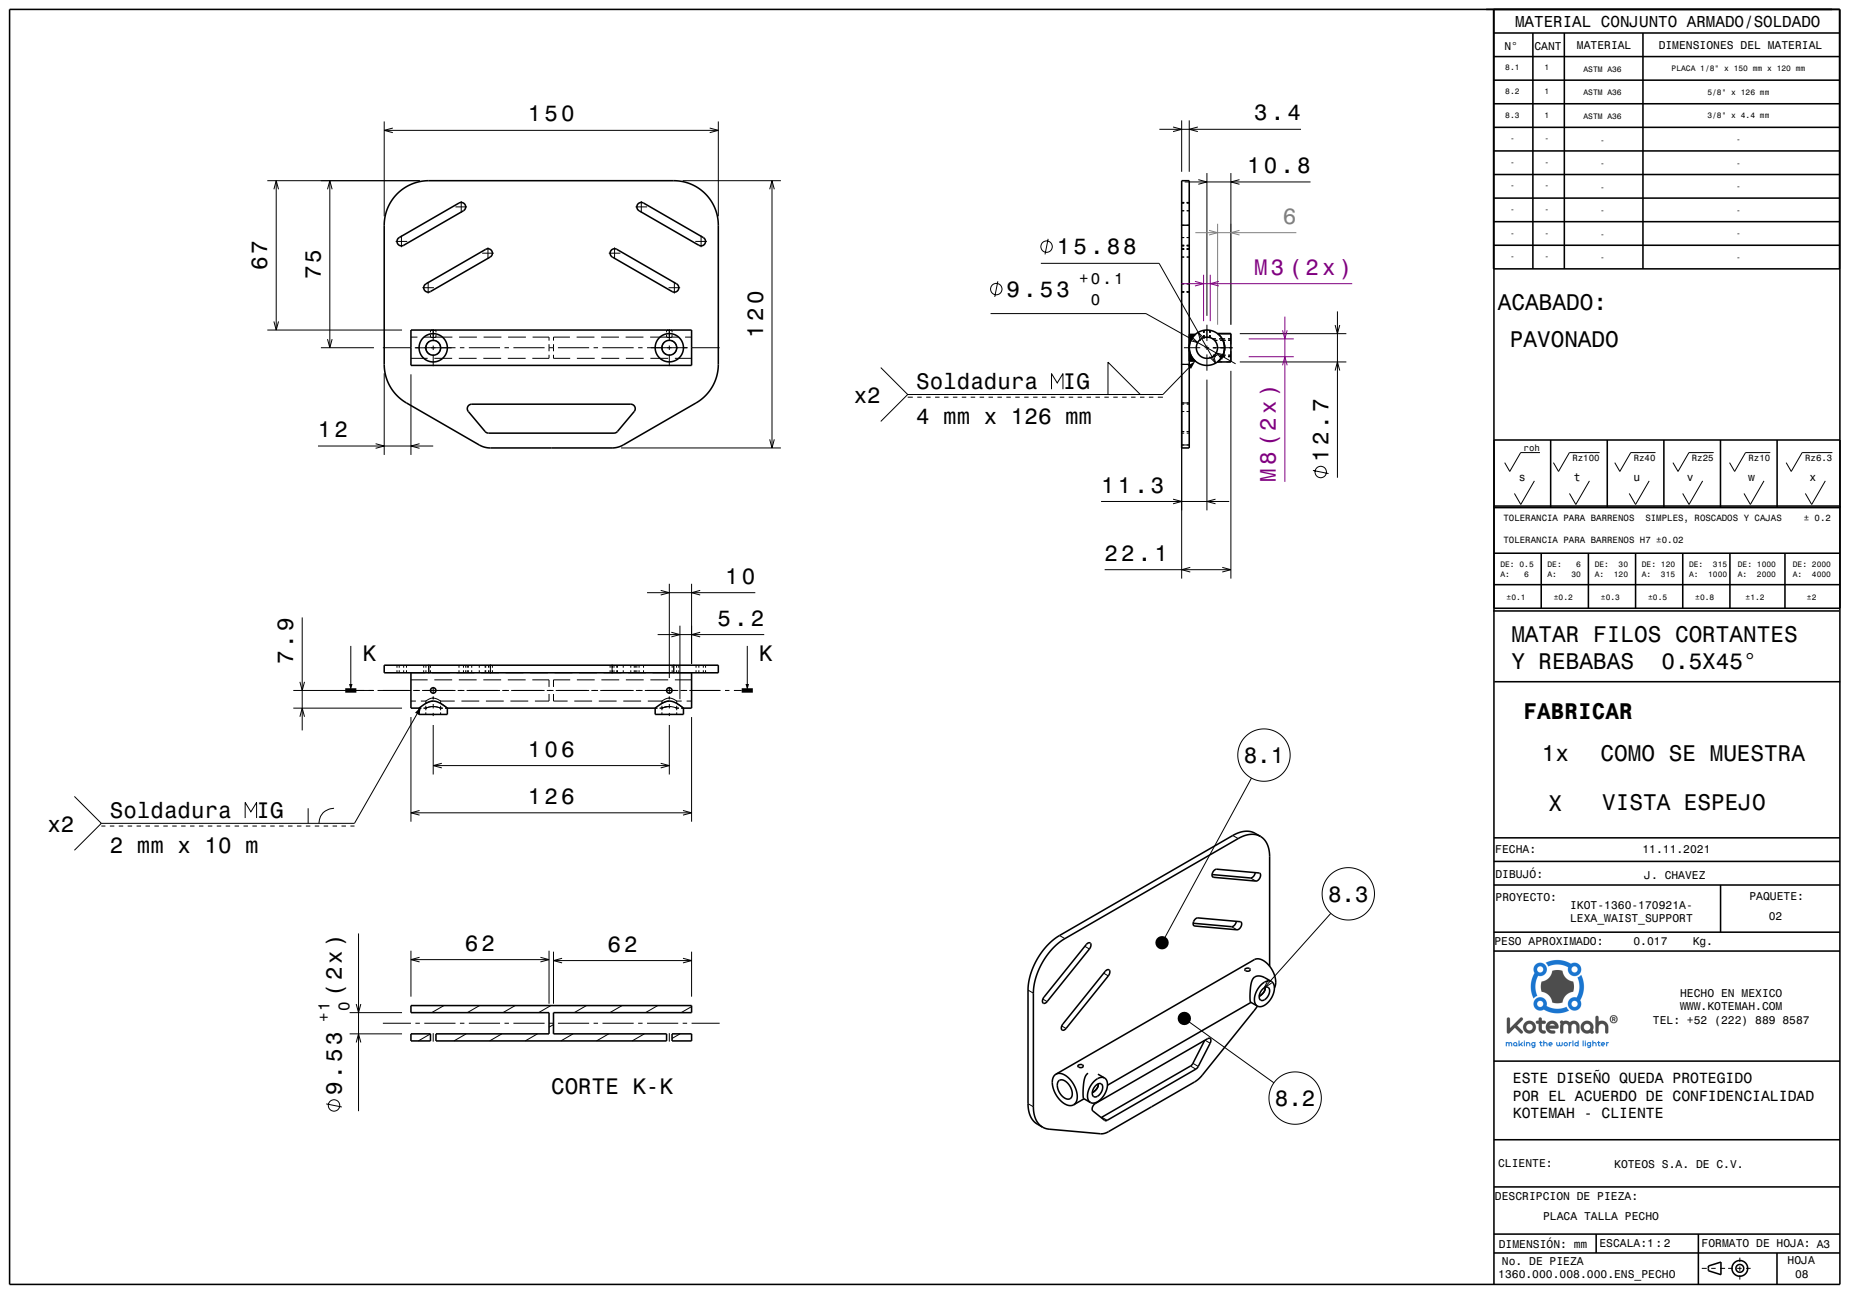
[picture p171: page 1]
MATAR FILOS CORTANTES Y REBABAS 0.5X45°; TOLERANCIA PARA BARRENOS SIMPLES, ROSCADOS Y CAJAS; PESO APROXIMADO:; KOTEOS S.A. DE C.V.; J. CHAVEZ; COMO SE MUESTRA; VISTA ESPEJO; Soldadura IG 4 mm x 126 mm; 126 Soldadura IG; CORTE K-K

150 | MATERIAL CONJUNTO ARMADO/SOLDADO

N° | CANT | MATERIAL | DIMENSIONES DEL MATERIAL

8.1 | 1 | ASTM A36 | PLACA 1/8" x 150 mm x 120 mm

8.2 | 1 | ASTM A36 | 5/8" x 126 mm

8.3 | 1 | ASTM A36 | 3/8" x 4.4 mm

TOLERANCIA PARA BARRENOS H7 ±0.02

HECHO EN MEXICO
WWW.KOTEMAH.COM
TEL: +52 (222) 889 8587

ESTE DISEÑO QUEDA PROTEGIDO
POR EL ACUERDO DE CONFIDENCIALIDAD
KOTEMAH - CLIENTE

DESCRIPCION DE PIEZA:

PLACA TALLA PECHO

DIMENSIÓN: mm | ESCALA: 1 2 : | FORMATO DE HOJA: A3
No. DE PIEZA 1360.000.008.000.ENS_PECHO | | | HOJA 08
