koteos/RANDOM/EKOT-1360-170921A-LEXA_WAIST_SUPPORT/FAB/FAB_A/PLANOS DE FABRICACION CADERA/1360.000.000.000.WAIST_SUPPORT_HOJA_09.pdf

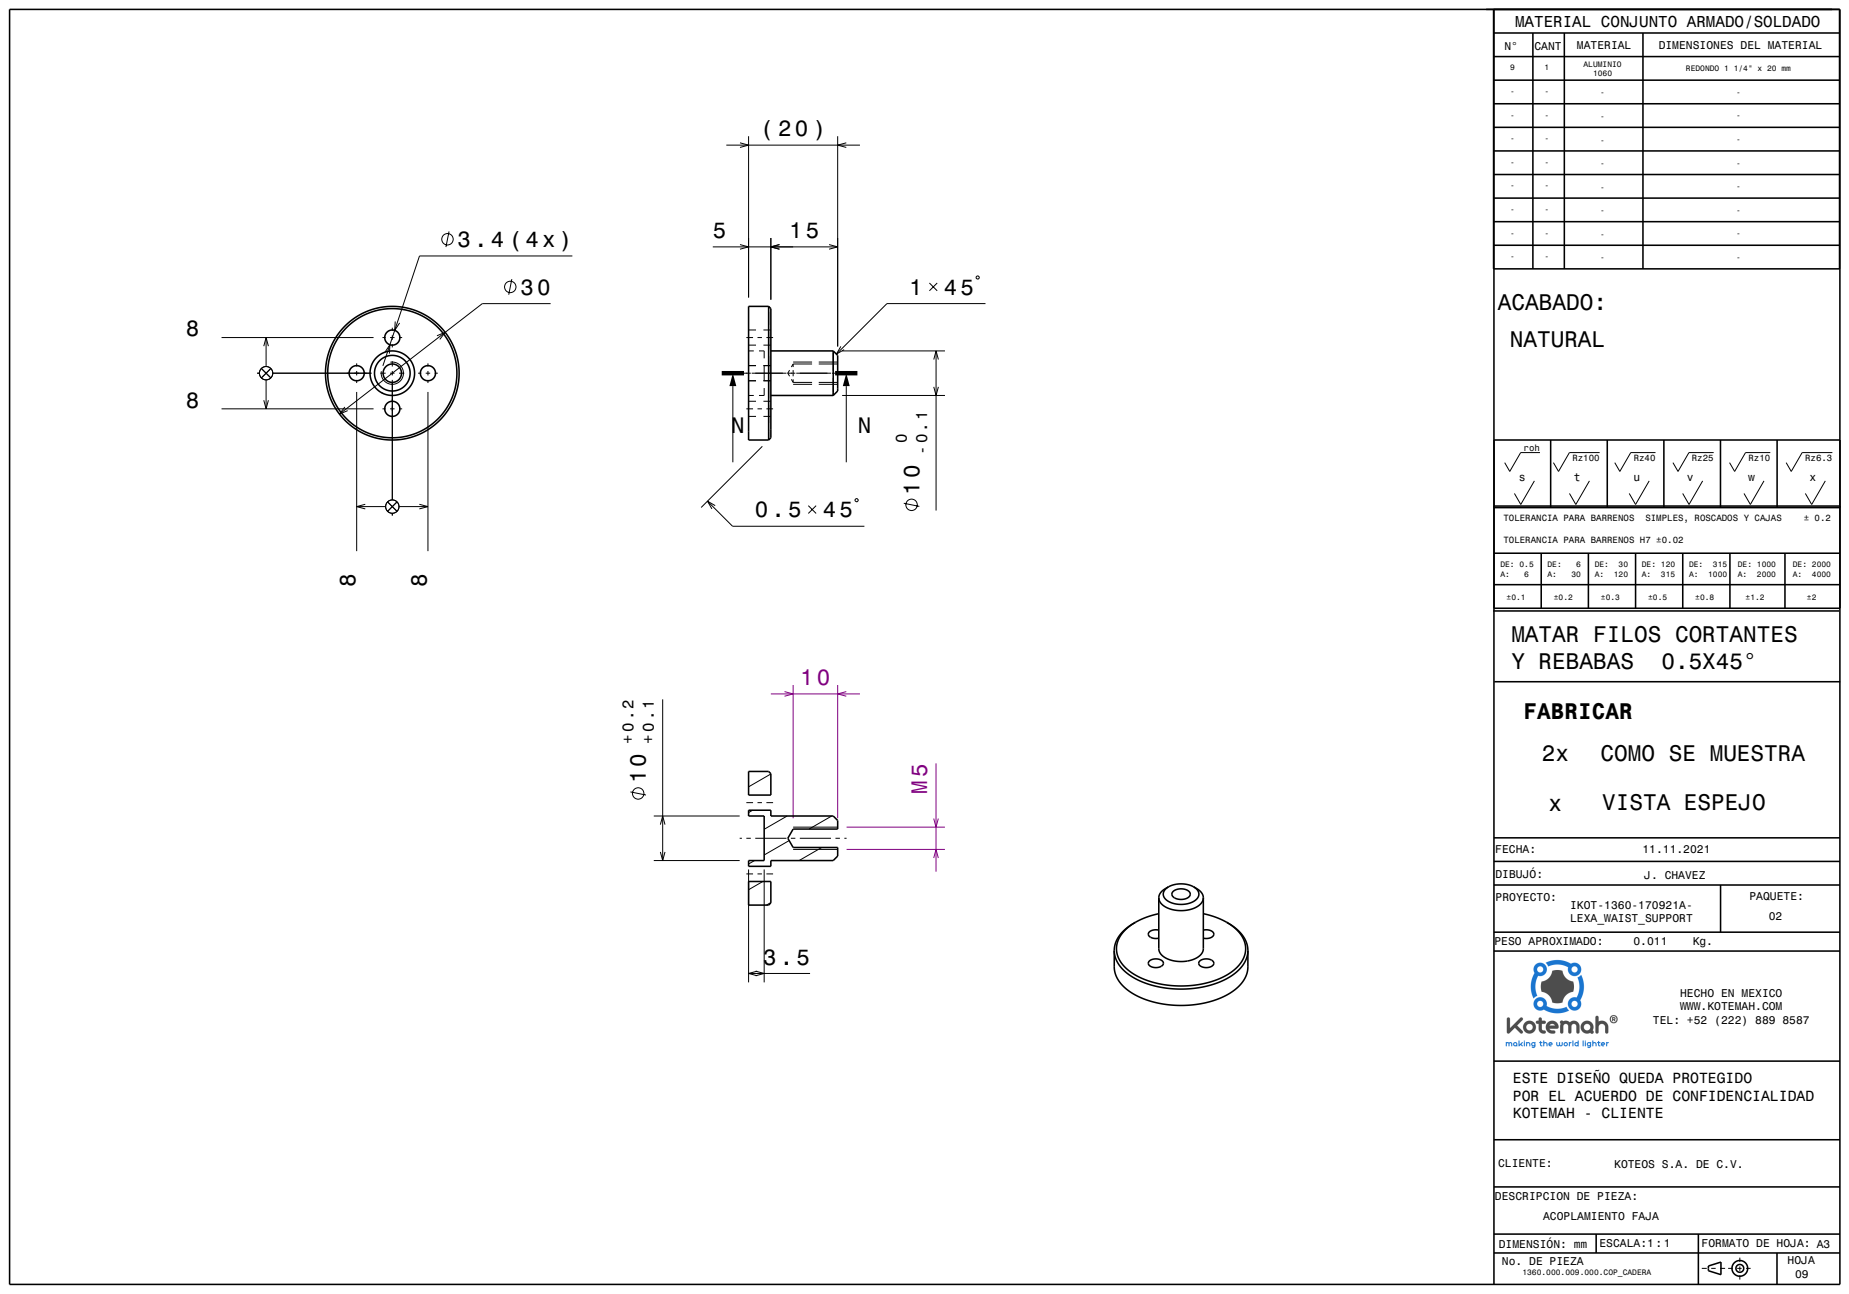
[picture p172: page 1]
ACOPLAMIENTO FAJA; TOLERANCIA PARA BARRENOS SIMPLES, ROSCADOS Y CAJAS; PESO APROXIMADO:; KOTEOS S.A. DE C.V.; J. CHAVEZ

MATERIAL CONJUNTO ARMADO/SOLDADO

N° | CANT | MATERIAL | DIMENSIONES DEL MATERIAL

9 | 1 | ALUMINIO 1060 | REDONDO 1 1/4" x 20 mm

- | - | | -----

TOLERANCIA PARA BARRENOS H7 ±0.02

MATAR FILOS CORTANTES
Y REBABAS 0.5X45°
FABRICAR
COMO SE MUESTRA
VISTA ESPEJO

HECHO EN MEXICO
WWW.KOTEMAH.COM
TEL: +52 (222) 889 8587

ESTE DISEÑO QUEDA PROTEGIDO
POR EL ACUERDO DE CONFIDENCIALIDAD
KOTEMAH - CLIENTE

DESCRIPCION DE PIEZA:

DIMENSIÓN: mm | ESCALA: : 1 | FORMATO DE HOJA: A3
No. DE PIEZA 1360.000.009.000.COP_CADERA | | | HOJA 09
