koteos/RANDOM/10-EKOT-1074-170619A-UBF-PI/V1.4_SE_FABRICO/FAB/CORTE_DOBLEZ/1074.000.000.000.ENSAMBLE_GENERAL_Y01.pdf

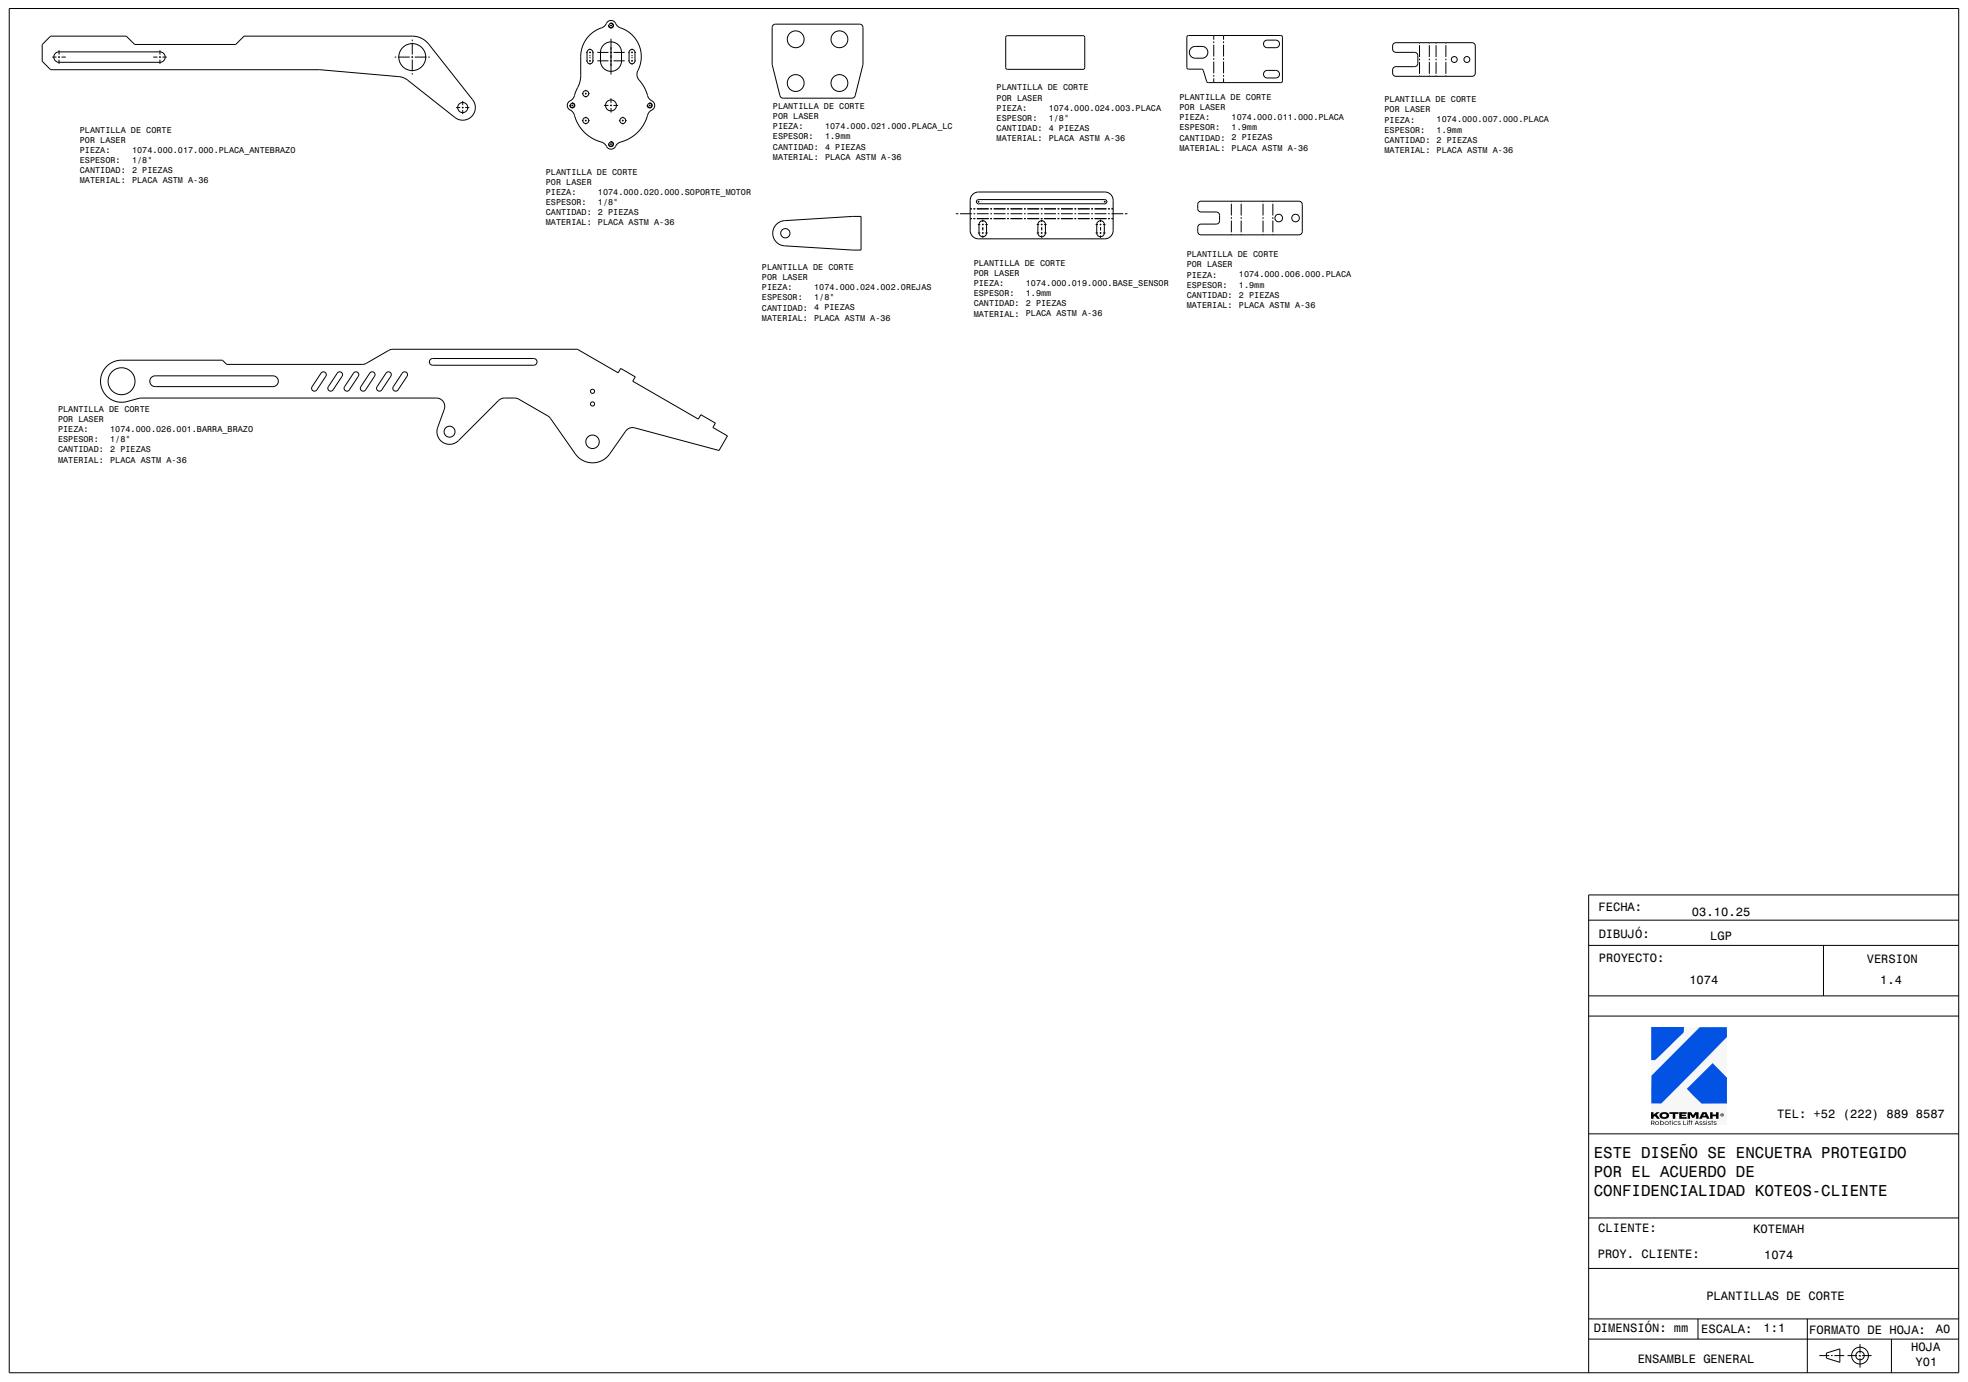
[picture p175: page 1]
TEL: +52 (222) 889 8587; PROY. CLIENTE:; 4 PIEZAS PLACA ASTM A-36; 2 PIEZAS PLACA ASTM A-36

PLANTILLA DE CORTE
POR LASER
PIEZA:
ESPESOR:
CANTIDAD:
MATERIAL:

ESTE DISEÑO SE ENCUETRA PROTEGIDO
POR EL ACUERDO DE
CONFIDENCIALIDAD KOTEOS-CLIENTE

PLANTILLAS DE CORTE

DIMENSIÓN: mm | 1:1 ESCALA: | FORMATO DE HOJA: A0

ENSAMBLE GENERAL | | | HOJA Y01
