koteos/RANDOM/10-EKOT-1074-170619A-UBF-PI/V1.4_SE_FABRICO/FAB/MAQUINADO_SOLDADURA/1074.000.000.000.ENSAMBLE_GENERAL_PIEZA_09.pdf

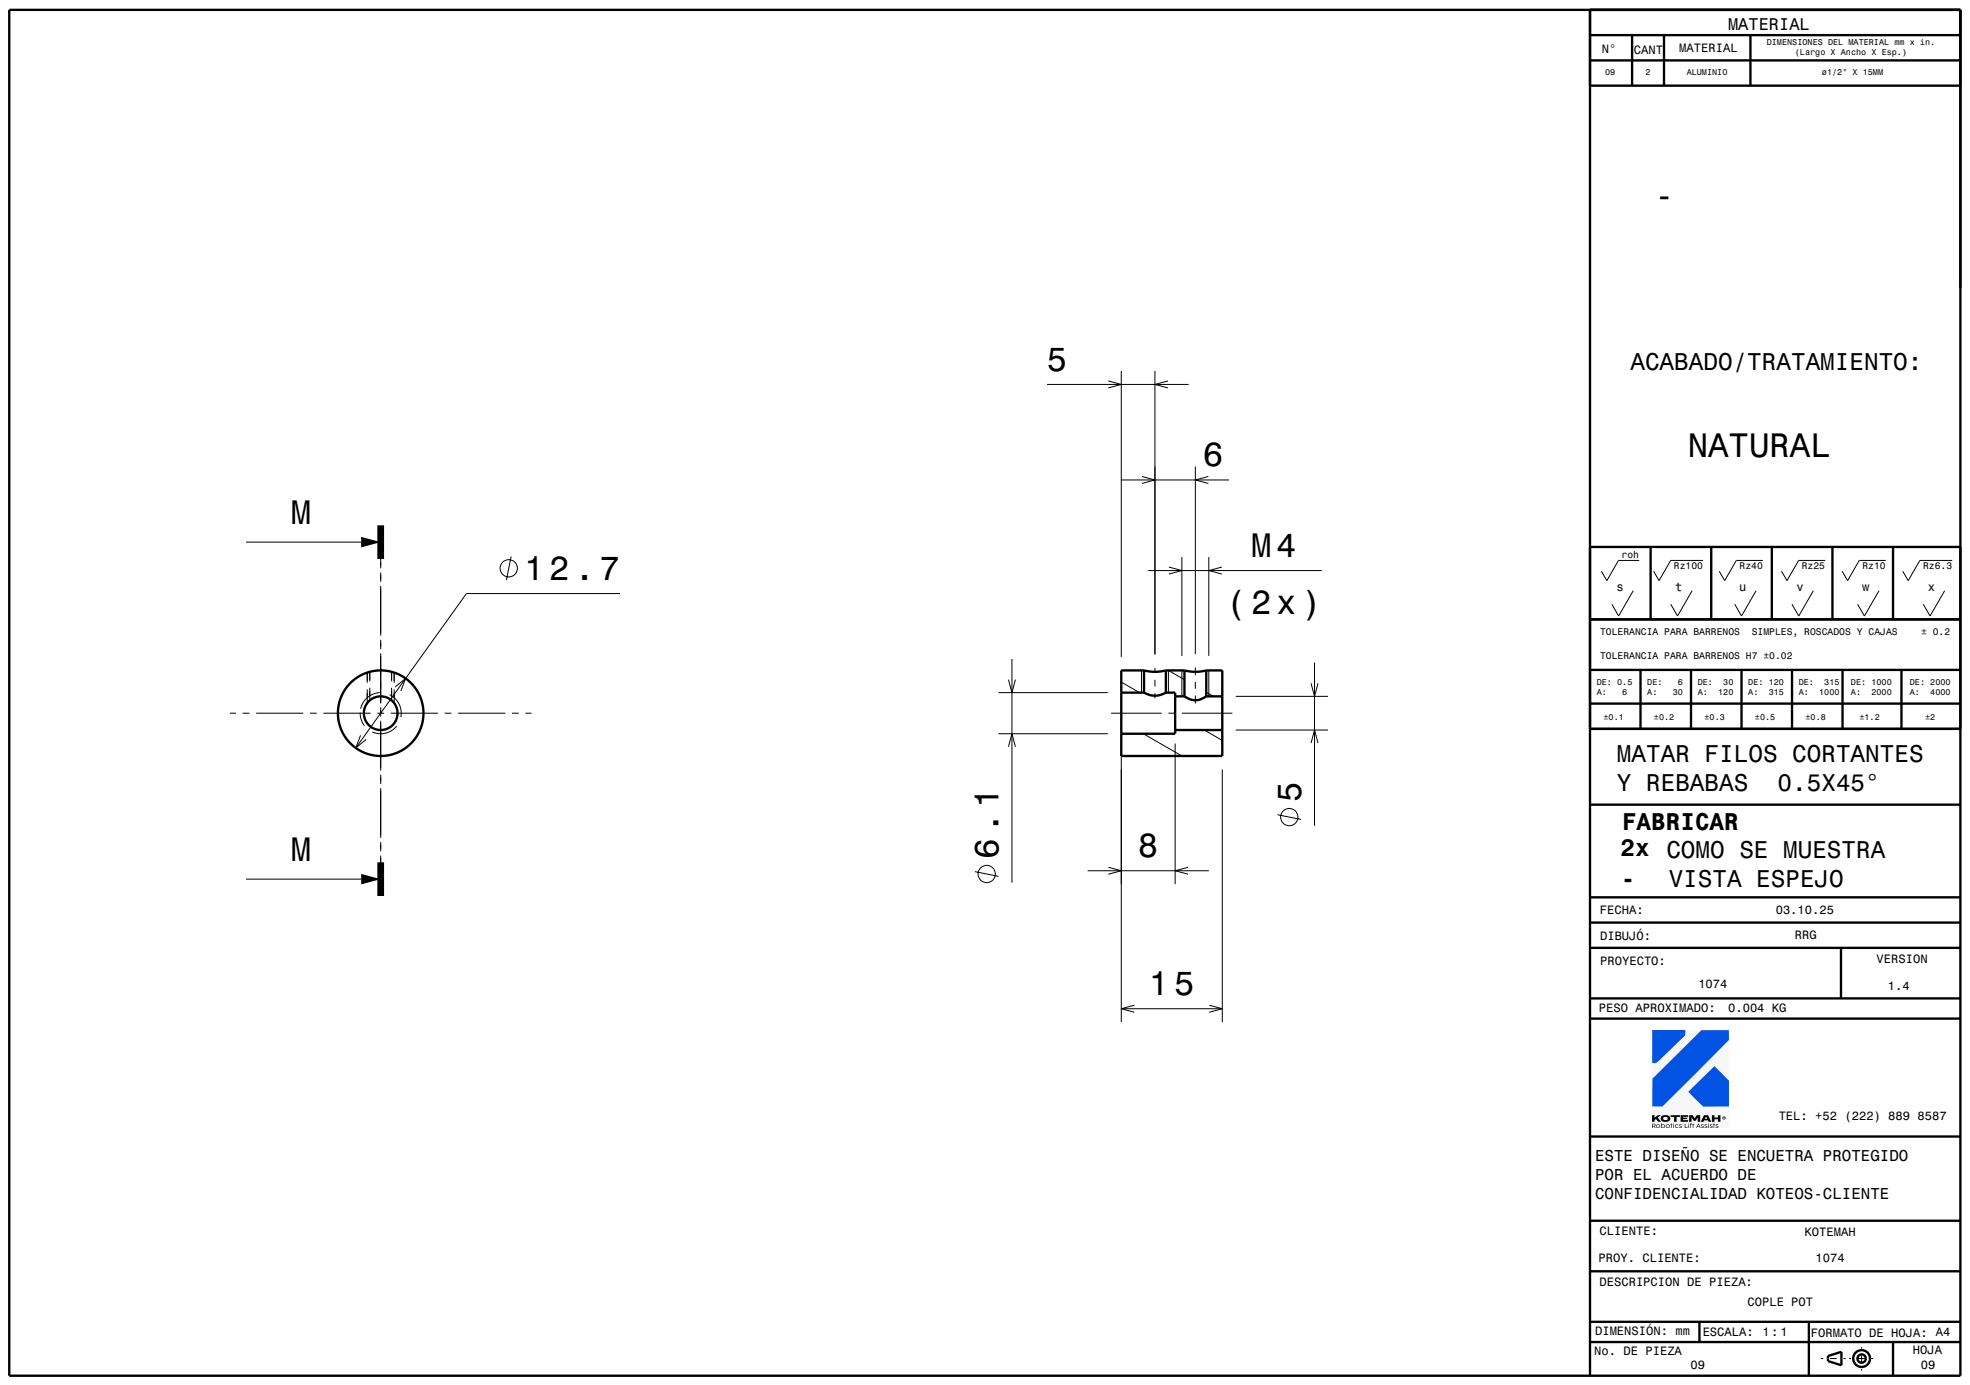
[picture p177: page 1]
COPLE POT; TEL: +52 (222) 889 8587; TOLERANCIA PARA BARRENOS SIMPLES, ROSCADOS Y CAJAS; PESO APROXIMADO:

MATERIAL

N° | CANT | MATERIAL | DIMENSIONES DEL MATERIAL mm x in. (Largo X Ancho X Esp.)

09 | 2 | ALUMINIO | ø1/2" X 15MM

TOLERANCIA PARA BARRENOS H7 ±0.02

MATAR FILOS CORTANTES
Y REBABAS 0.5X45°
FABRICAR
2x COMO SE MUESTRA -
VISTA ESPEJO

ESTE DISEÑO SE ENCUETRA PROTEGIDO
POR EL ACUERDO DE
CONFIDENCIALIDAD KOTEOS-CLIENTE

CLIENTE:
PROY. CLIENTE:
DESCRIPCION DE PIEZA:

DIMENSIÓN: mm | ESCALA: 1 : 1 | FORMATO DE HOJA: A4
No. DE PIEZA 09 | | | HOJA 09
