koteos/RANDOM/10-EKOT-1074-170619A-UBF-PI/V1.4_SE_FABRICO/FAB/MAQUINADO_SOLDADURA/1074.000.000.000.ENSAMBLE_GENERAL_PIEZA_23.pdf

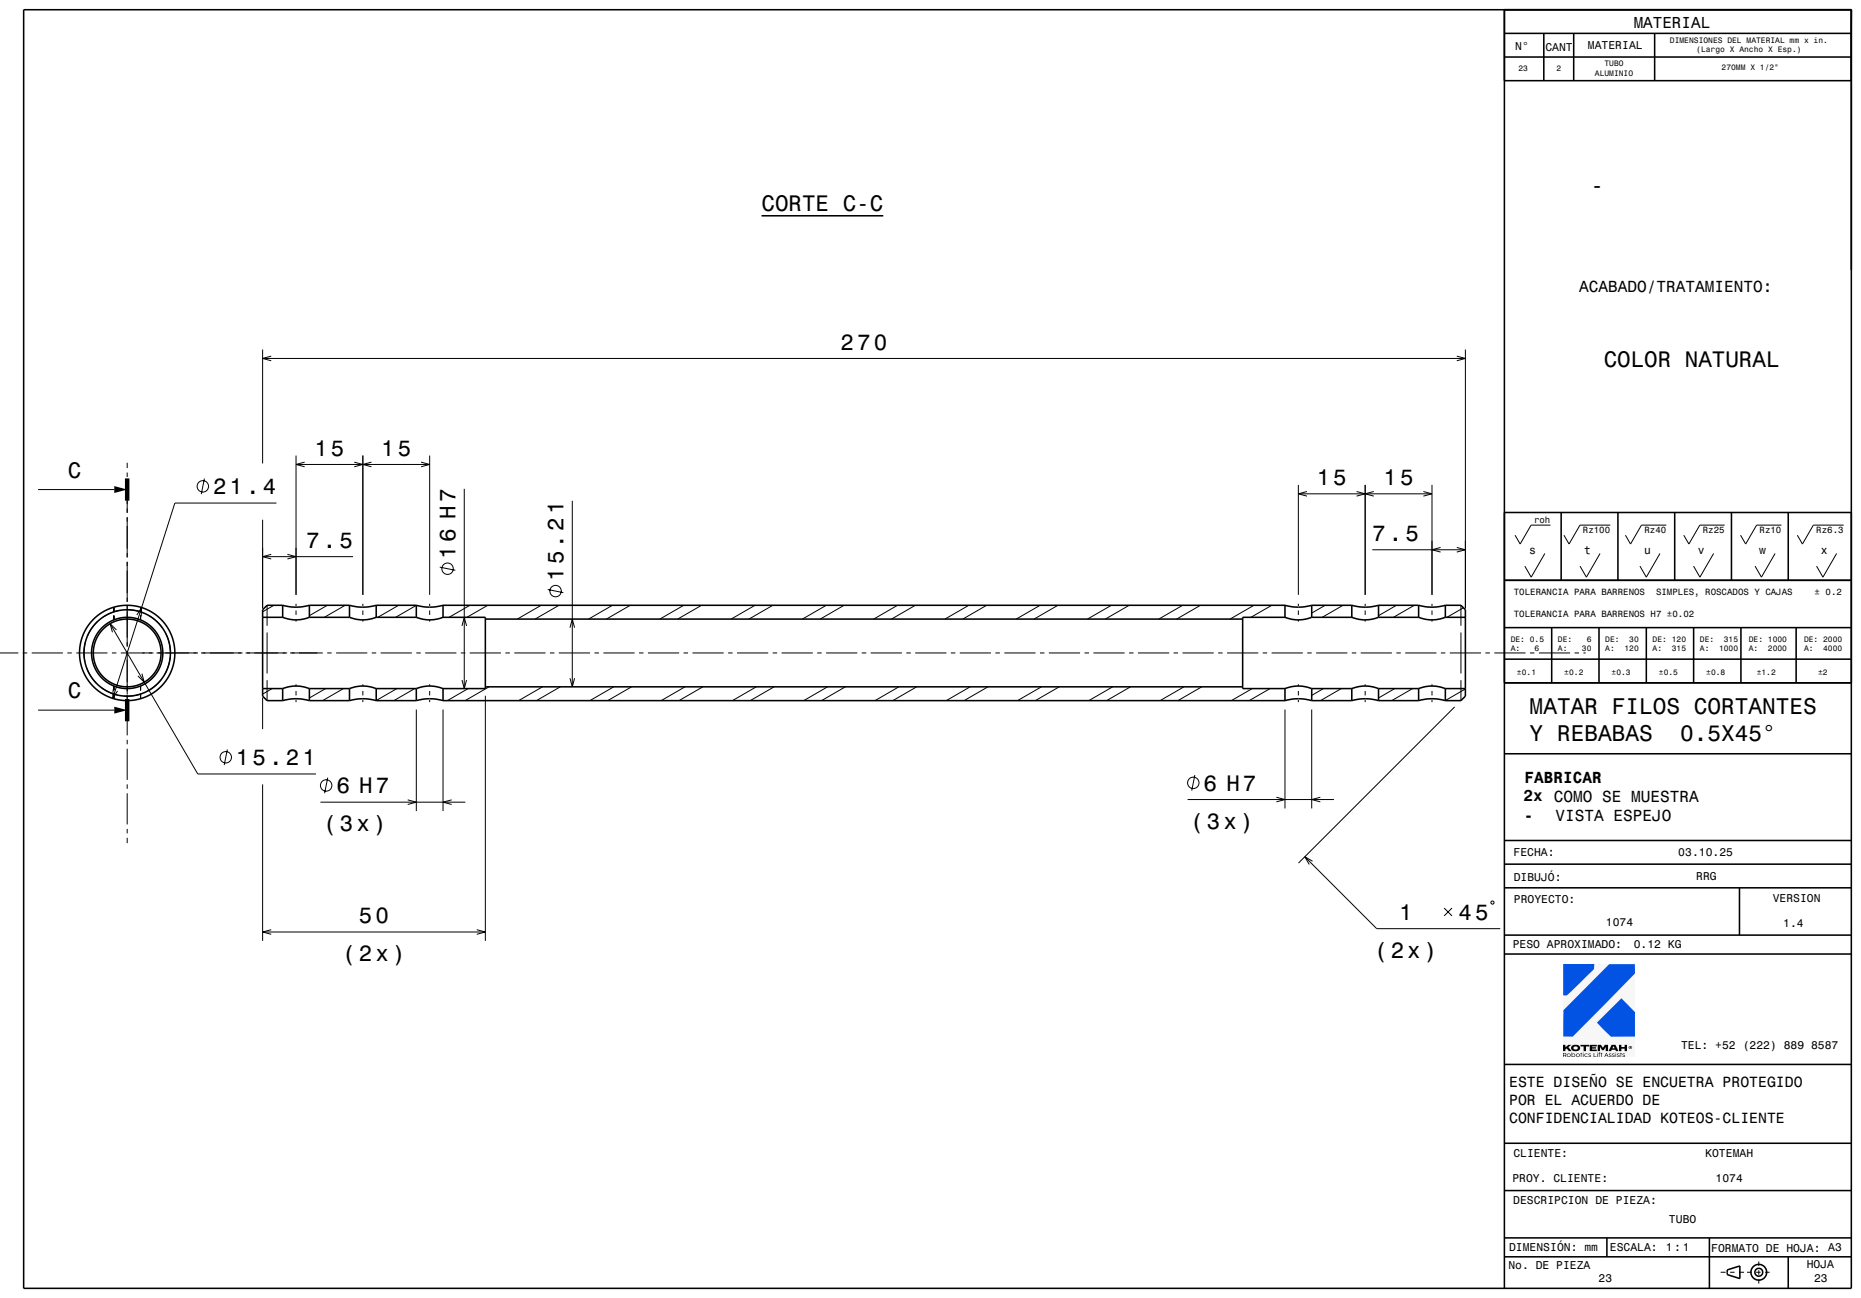
[picture p178: page 1]
TEL: +52 (222) 889 8587; TOLERANCIA PARA BARRENOS SIMPLES, ROSCADOS Y CAJAS; PESO APROXIMADO:; COLOR NATURAL

CORTE C-C 270 | MATERIAL

N° | CANT | MATERIAL | DIMENSIONES DEL MATERIAL mm x in. (Largo X Ancho X Esp.)

23 | 2 | TUBO ALUMINIO | 270MM X 1/2"

TOLERANCIA PARA BARRENOS H7 ±0.02

MATAR FILOS CORTANTES
Y REBABAS 0.5X45°

FABRICAR
2x COMO SE MUESTRA
VISTA ESPEJO

ESTE DISEÑO SE ENCUETRA PROTEGIDO
POR EL ACUERDO DE
CONFIDENCIALIDAD KOTEOS-CLIENTE

CLIENTE:
PROY. CLIENTE:
DESCRIPCION DE PIEZA:

DIMENSIÓN: mm | ESCALA: 1 : 1 | FORMATO DE HOJA: A3
No. DE PIEZA 23 | | | HOJA 23
