koteos/RANDOM/10-EKOT-1074-170619A-UBF-PI/V1.4_SE_FABRICO/FAB/MAQUINADO_SOLDADURA/1074.000.000.000.ENSAMBLE_GENERAL_PIEZA_24.pdf

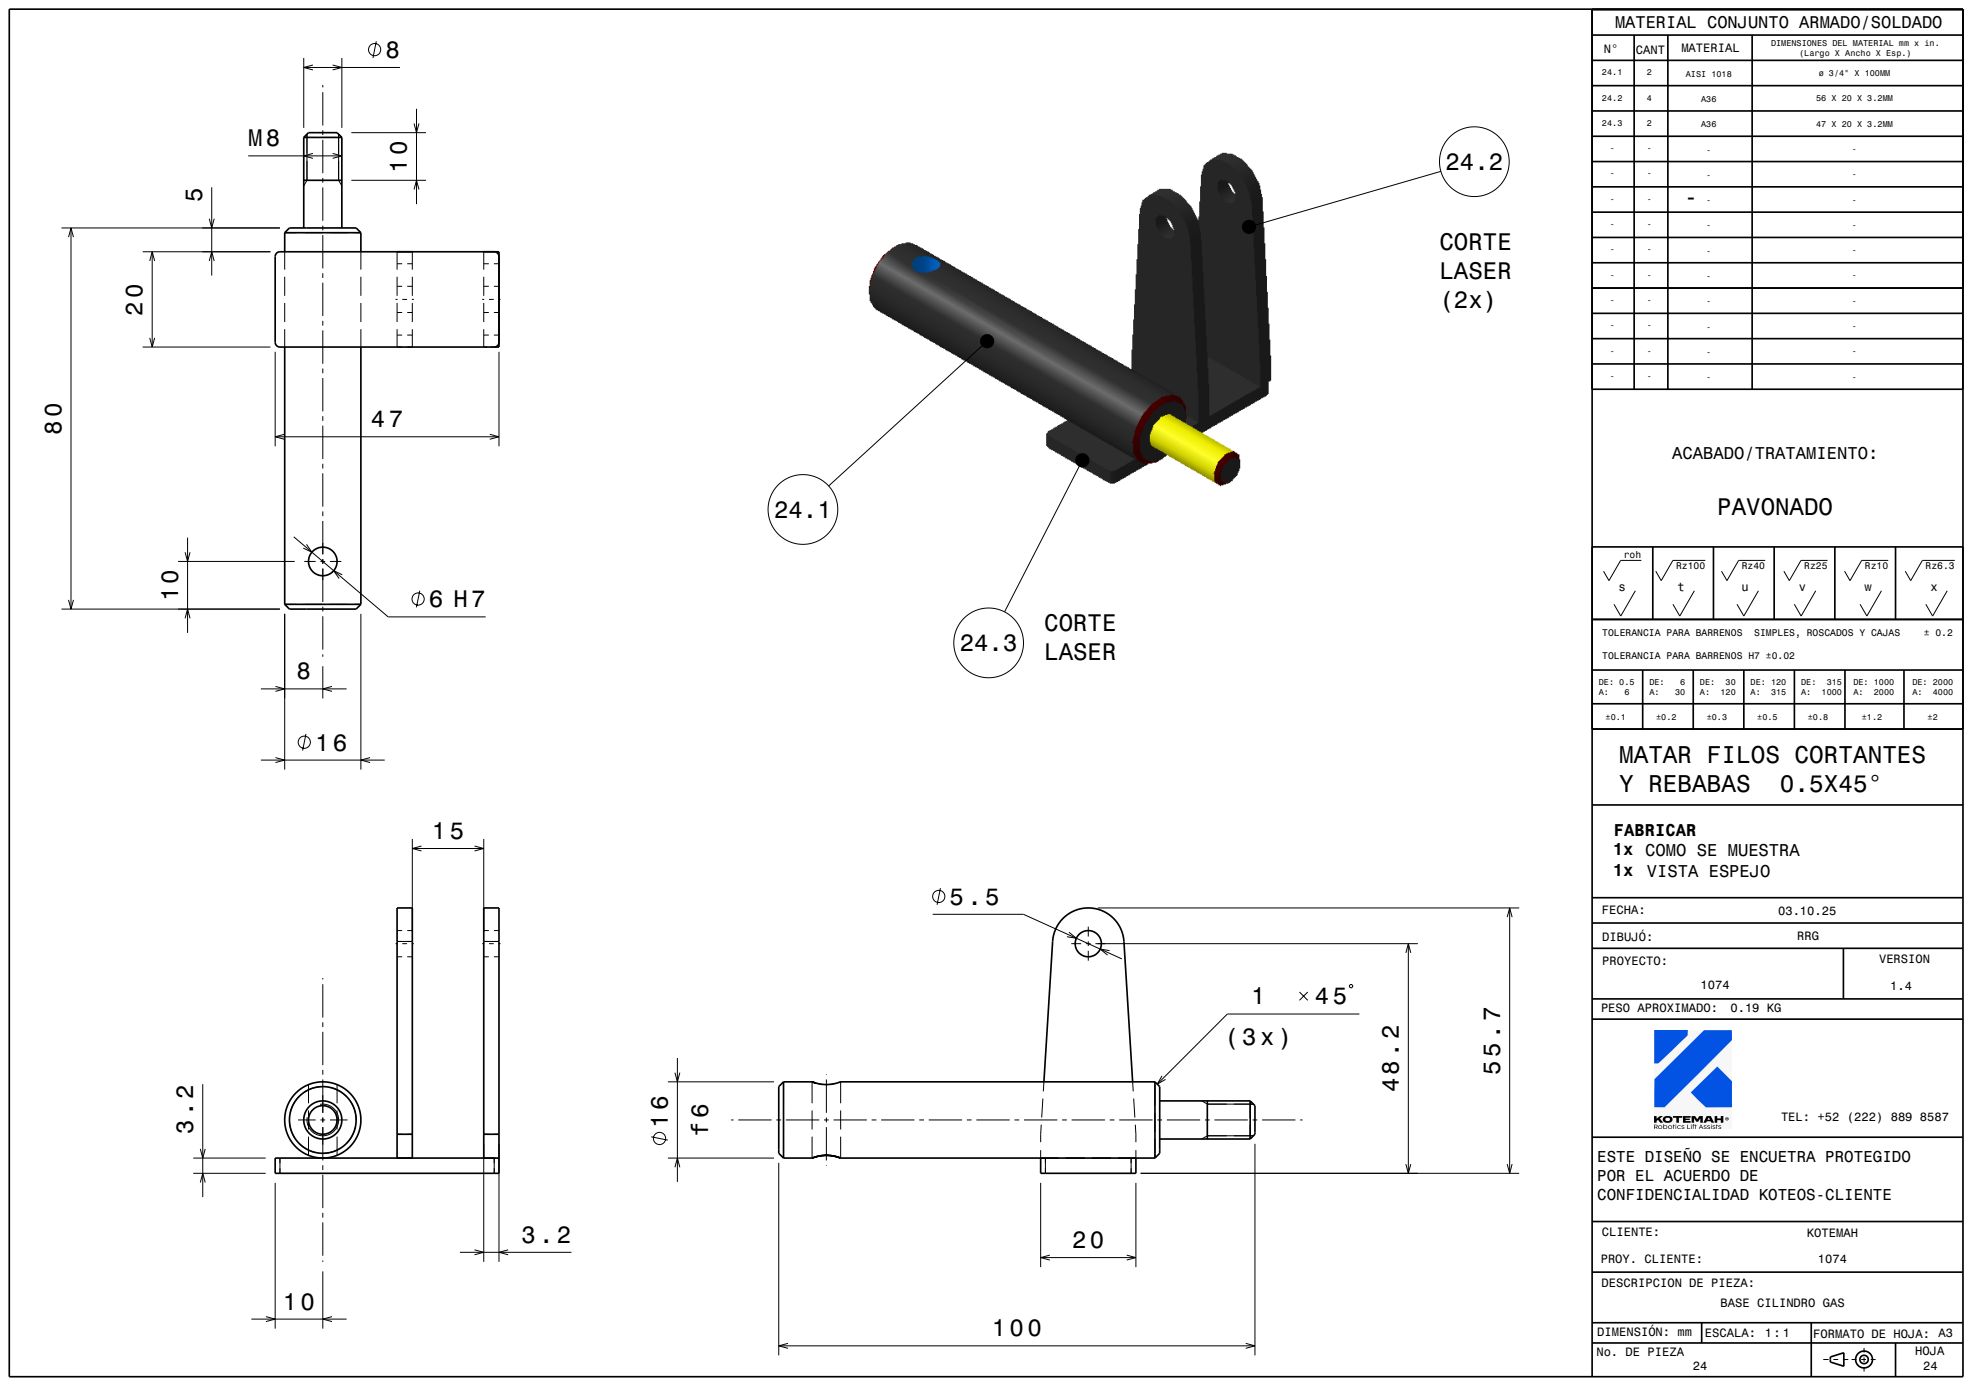
[picture p179: page 1]
TEL: +52 (222) 889 8587; TOLERANCIA PARA BARRENOS SIMPLES, ROSCADOS Y CAJAS; PESO APROXIMADO:

MATERIAL CONJUNTO ARMADO/SOLDADO -24.3 | 2 | A36 | - -47 X 20 X 3.2MM
N° | CANT | MATERIAL | DIMENSIONES DEL MATERIAL mm x in. (Largo X Ancho X Esp.)

24.1 | 2 | AISI 1018 | ø 3/4" X 100MM

- | - | - | -----

TOLERANCIA PARA BARRENOS H7 ±0.02

MATAR FILOS CORTANTES
Y REBABAS 0.5X45°

FABRICAR
1x COMO SE MUESTRA
VISTA ESPEJO

ESTE DISEÑO SE ENCUETRA PROTEGIDO
POR EL ACUERDO DE
CONFIDENCIALIDAD KOTEOS-CLIENTE

CLIENTE:
PROY. CLIENTE:
DESCRIPCION DE PIEZA:

BASE CILINDRO GAS

DIMENSIÓN: mm | ESCALA: 1 : 1 | FORMATO DE HOJA: A3
No. DE PIEZA 24 | | | HOJA 24
