koteos/RANDOM/EKOT-1360-170921A-LEXA_WAIST_SUPPORT/FAB/FAB_A/PLANOS DE FABRICACION CADERA/1360.000.000.000.WAIST_SUPPORT_A0_ENSAMBLE.pdf

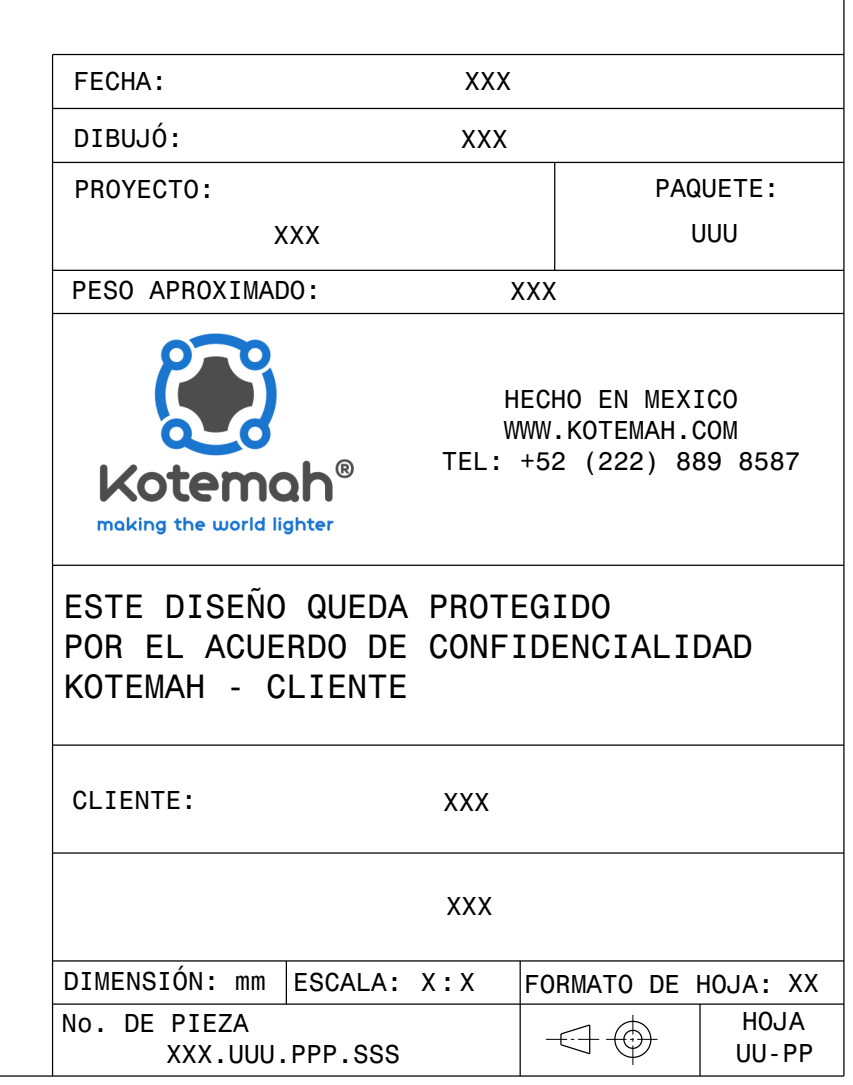
[picture p182: page 1]
PESO APROXIMADO:

HECHO EN MEXICO
WWW.KOTEMAH.COM
TEL: +52 (222) 889 8587

ESTE DISEÑO QUEDA PROTEGIDO
POR EL ACUERDO DE CONFIDENCIALIDAD
KOTEMAH - CLIENTE

DIMENSIÓN: mm | : ESCALA: X X | FORMATO DE HOJA: XX
No. DE PIEZA XXX.UUU.PPP.SSS | | | HOJA UU-PP
