koteos/RANDOM/EKOT-1360-170921A-LEXA_WAIST_SUPPORT/FAB/FAB_A/PLANOS DE FABRICACION CADERA/1360.000.000.000.WAIST_SUPPORT_Y01_PLANTILLAS.pdf

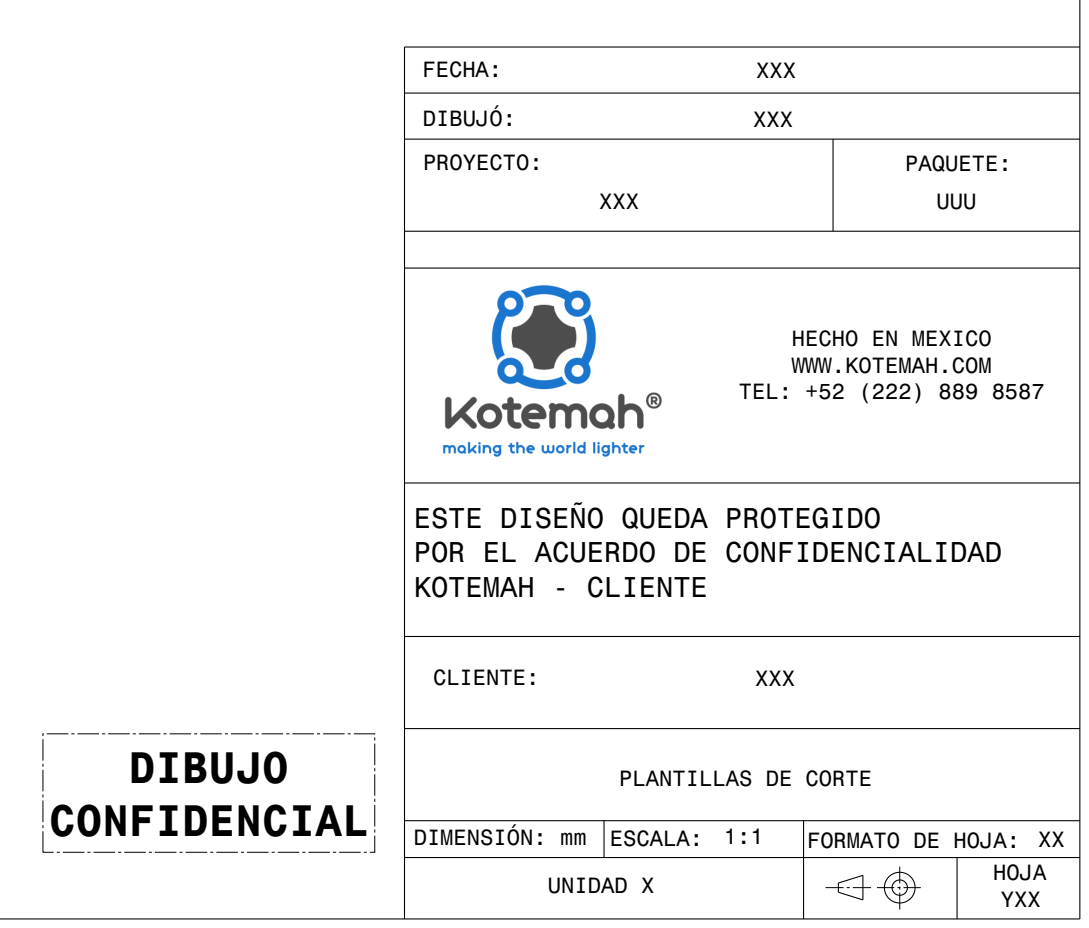
[picture p183: page 1]

HECHO EN MEXICO
WWW.KOTEMAH.COM
TEL: +52 (222) 889 8587

ESTE DISEÑO QUEDA PROTEGIDO
POR EL ACUERDO DE CONFIDENCIALIDAD
KOTEMAH - CLIENTE

PLANTILLAS DE CORTE

DIMENSIÓN: mm | 1:1 ESCALA: | FORMATO DE HOJA: XX

UNIDAD X | | | HOJA YXX
