koteos/RANDOM/Self Balancing Robot Files/Electronics Files/Self Balancing Robot.kicad_pcb

## KiCad design Self Balancing Robot Files/Electronics Files/Self Balancing Robot.kicad_pcb (2025-05-05)

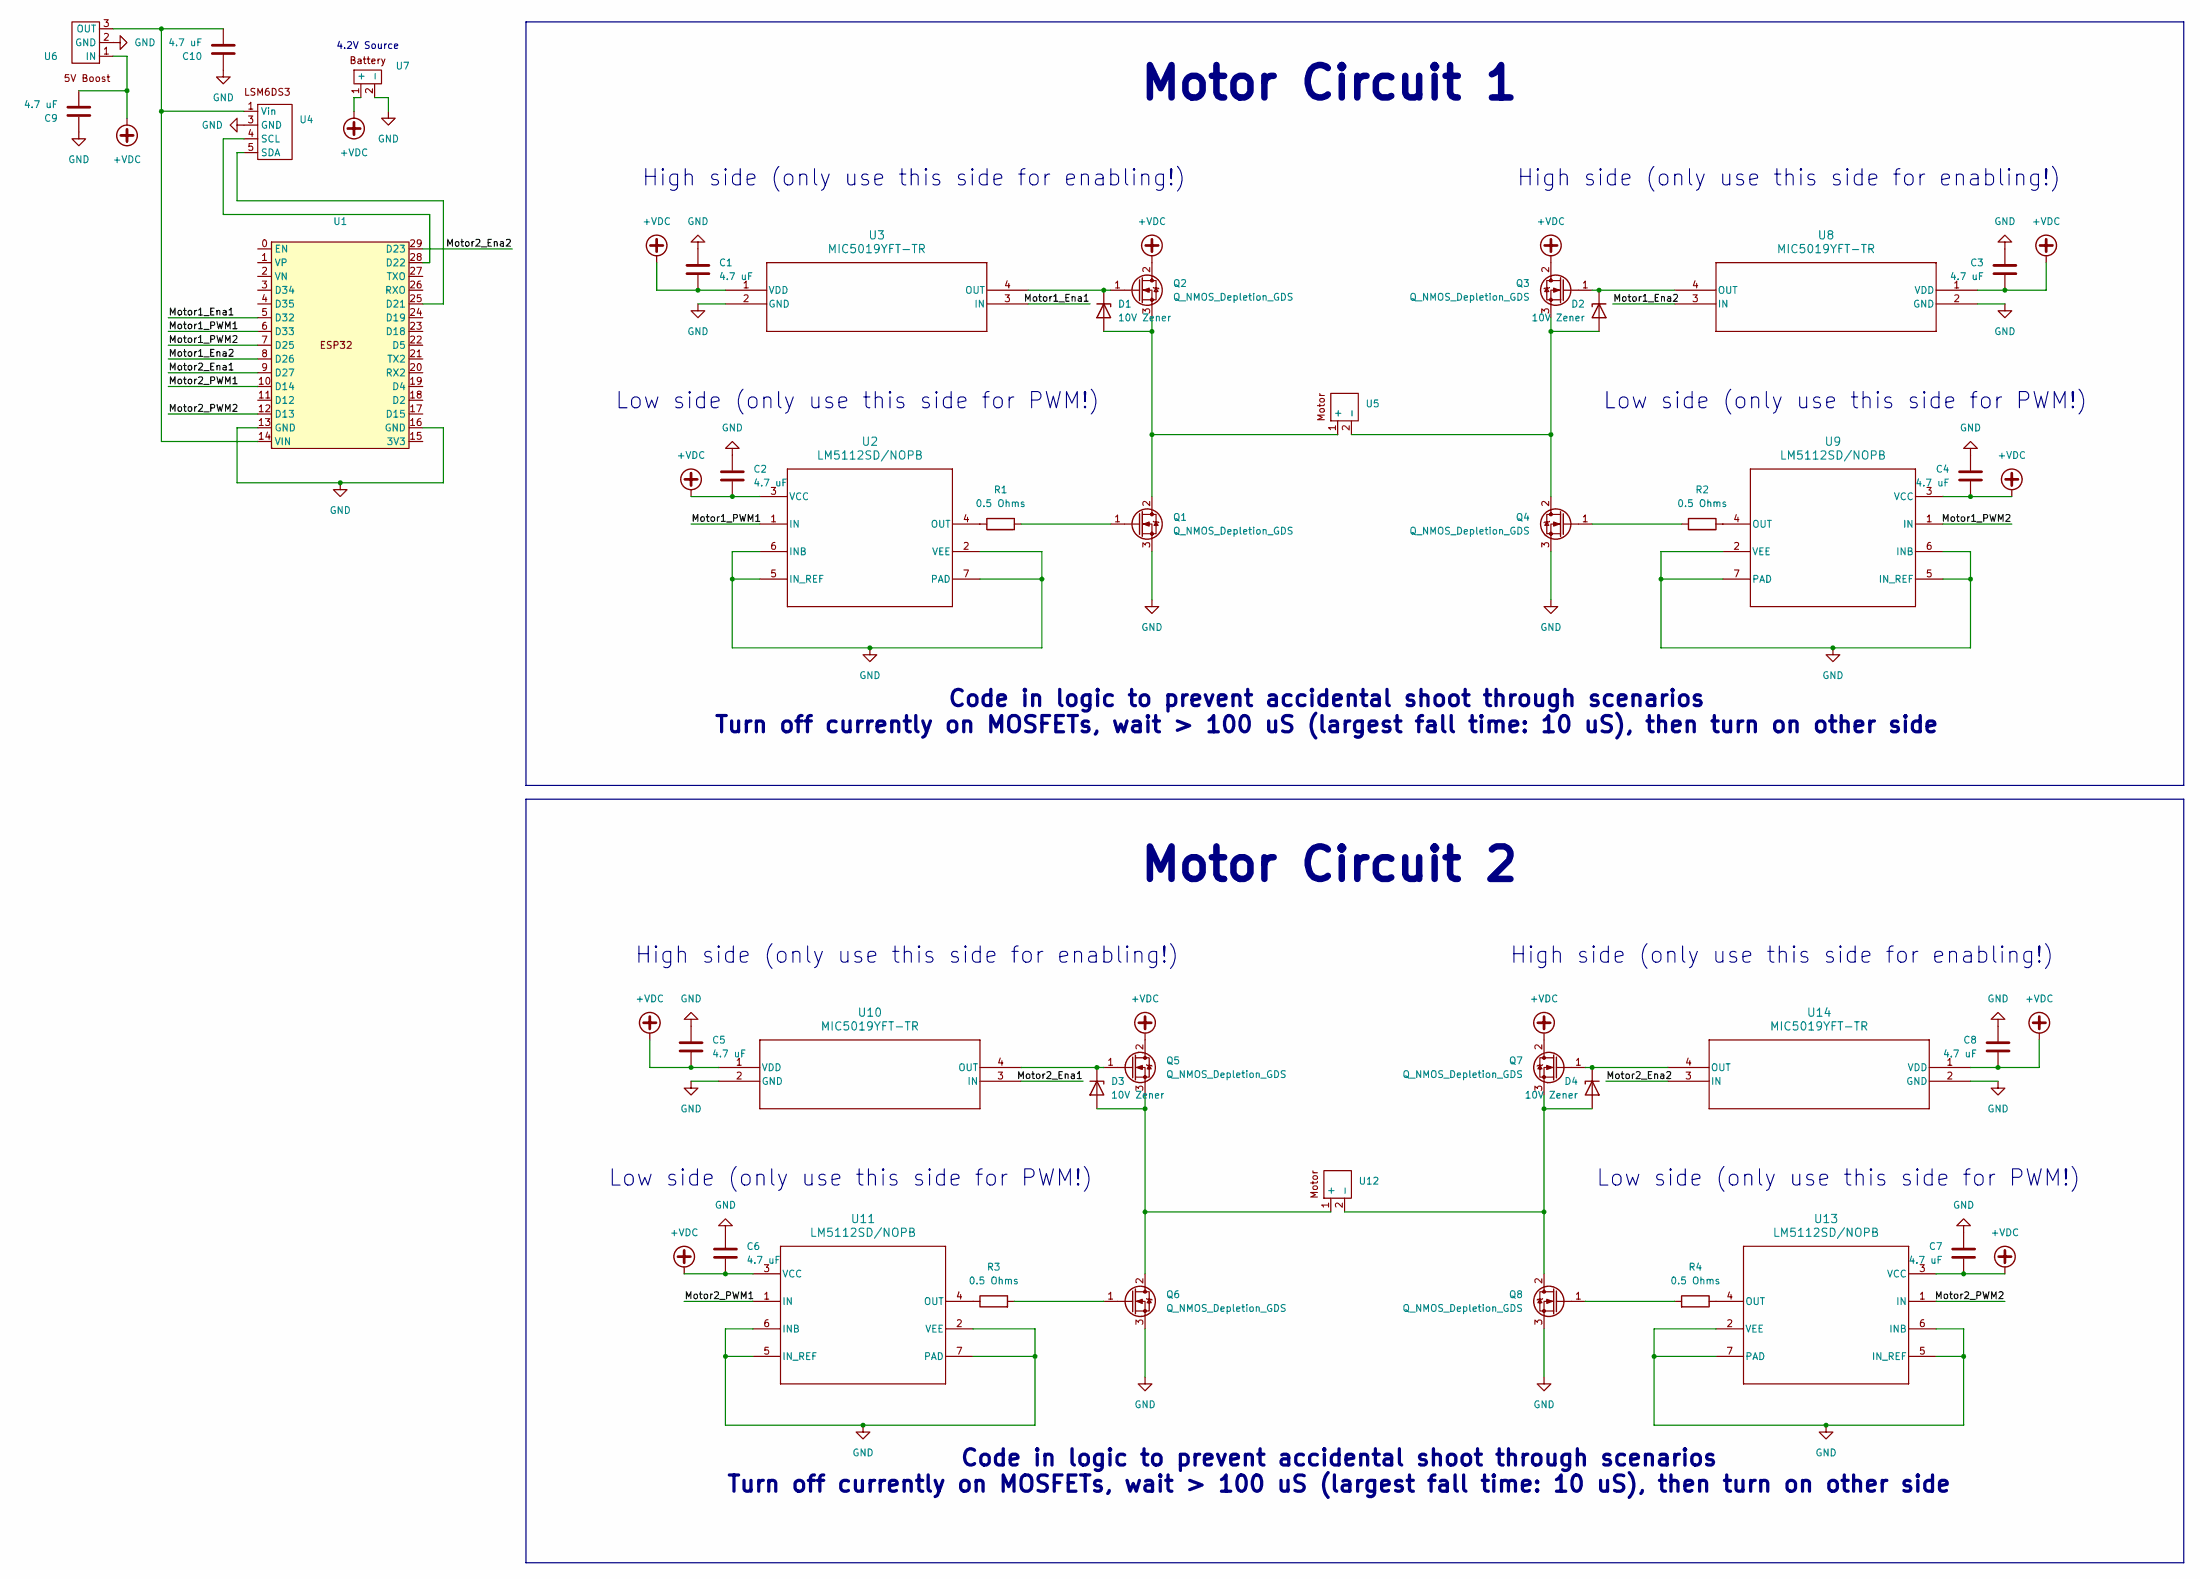
[picture p188: schematic Self Balancing Robot.kicad_sch]

Parts:
C1, C2, C3, C4, C5, C6, C7, C8, C9, C10: 4.7 uF; C_0805_2012Metric_Pad1.18x1.45mm_HandSolder
D1, D2, D3, D4: 10V Zener; TSOT-23
Q1, Q2, Q3, Q4, Q5, Q6, Q7, Q8: Q_NMOS_Depletion_GDS; TO-252-2
R1, R2, R3, R4: 0.5 Ohms; R_2010_5025Metric_Pad1.40x2.65mm_HandSolder
U1: ESP32
U2, U9, U11, U13: LM5112SD/NOPB; LM5112SD
U3, U8, U10, U14: MIC5019YFT-TR
U4: LSM6DS3
U5, U12: Motor
U6: Boost
U7: Battery

Connections:
+VDC: C1.2, C2.2, C3.2, C4.2, C5.2, C6.2, C7.2, C8.2, C9.2, Q2.2 (D), Q3.2 (D), Q5.2 (D), Q7.2 (D), U2.3 (VCC), U3.1 (VDD), U6.1 (IN), U7.1 (+), U8.1 (VDD), U9.3 (VCC), U10.1 (VDD), U11.3 (VCC), U13.3 (VCC), U14.1 (VDD)
/Motor1_Ena1: U1.5 (D32), U3.3 (IN)
/Motor1_Ena2: U1.8 (D26), U8.3 (IN)
/Motor1_PWM1: U1.6 (D33), U2.1 (IN)
/Motor1_PWM2: U1.7 (D25), U9.1 (IN)
/Motor2_Ena1: U1.9 (D27), U10.3 (IN)
/Motor2_Ena2: U1.29 (D23), U14.3 (IN)
/Motor2_PWM1: U1.10 (D14), U11.1 (IN)
/Motor2_PWM2: U1.12 (D13), U13.1 (IN)
GND: C1.1, C2.1, C3.1, C4.1, C5.1, C6.1, C7.1, C8.1, C9.1, C10.1, Q1.3 (S), Q4.3 (S), Q6.3 (S), Q8.3 (S), U1.13 (GND), U1.16 (GND), U2.2 (VEE), U2.5 (IN_REF), U2.6 (INB), U2.7 (PAD), U3.2 (GND), U4.3 (GND), U6.2 (GND), U7.2 (-), U8.2 (GND), U9.2 (VEE), U9.5 (IN_REF), U9.6 (INB), U9.7 (PAD), U10.2 (GND), U11.2 (VEE), U11.5 (IN_REF), U11.6 (INB), U11.7 (PAD), U13.2 (VEE), U13.5 (IN_REF), U13.6 (INB), U13.7 (PAD), U14.2 (GND)
unnamed: D1.1 (A), Q1.2 (D), Q2.3 (S), U5.1 (+)
unnamed: D1.3 (K), Q2.1 (G), U3.4 (OUT)
unnamed: D2.1 (A), Q3.3 (S), Q4.2 (D), U5.2 (-)
unnamed: D2.3 (K), Q3.1 (G), U8.4 (OUT)
unnamed: D3.1 (A), Q5.3 (S), Q6.2 (D), U12.1 (+)
unnamed: D3.3 (K), Q5.1 (G), U10.4 (OUT)
unnamed: D4.1 (A), Q7.3 (S), Q8.2 (D), U12.2 (-)
unnamed: D4.3 (K), Q7.1 (G), U14.4 (OUT)
unnamed: Q1.1 (G), R1.2
unnamed: Q4.1 (G), R2.2
unnamed: Q6.1 (G), R3.2
unnamed: Q8.1 (G), R4.2
unnamed: U1.25 (D21), U4.5 (SDA)
unnamed: U1.28 (D22), U4.4 (SCL)
unnamed: C10.2, U1.14 (VIN), U4.1 (Vin), U6.3 (OUT)
unnamed: R1.1, U2.4 (OUT)
unnamed: R2.1, U9.4 (OUT)
unnamed: R3.1, U11.4 (OUT)
unnamed: R4.1, U13.4 (OUT)

Notes on the sheet:
Low side (only use this side for PWM!)
High side (only use this side for enabling!)
Code in logic to prevent accidental shoot through scenarios Turn off currently on MOSFETs, wait > 100 uS (largest fall time: 10 uS), then turn on other side
4.2V Source
Motor Circuit 2
Motor Circuit 1

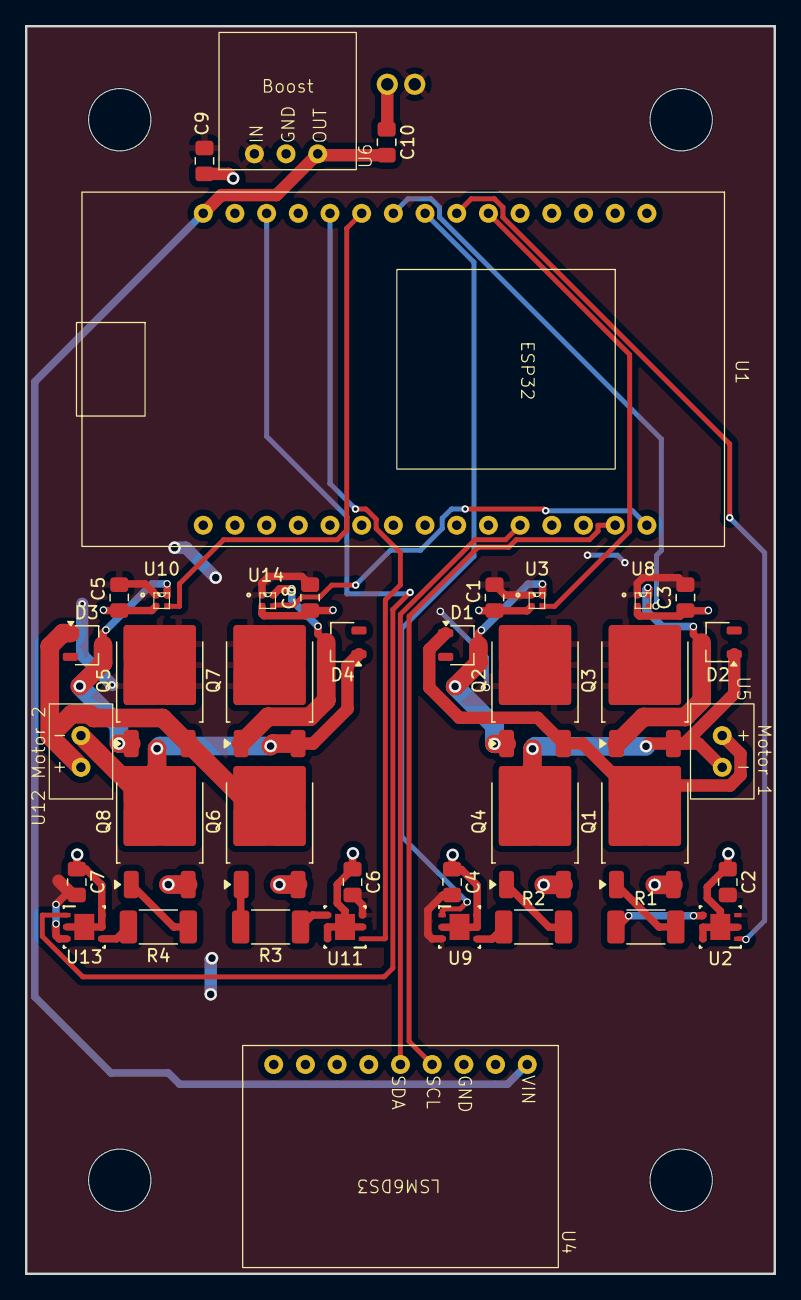
[picture p189: board Self Balancing Robot.kicad_pcb from above]

Board: 2 copper layers, 60.0 x 100.0 mm, 40 parts (1 on the bottom side), 29 nets.
