koteos/RANDOM/(commit log)

2025-03-06 Update CLACULADORAS_MENU.py
    Se actualizo la calculadora, ahora cuenta con 2 calculadoras, faltan 2 mas
2025-04-14 Create DSPICC33_FOC_BRUSHLESS
    Test para brushless con un control FOC
2025-04-29 realice algunos cambios
    Varios
    [BANCOS 2025.xlsx, Balanza_Comprobacion_2025.xlsx, Chassis 1.stl, Self Balancing Robot.kicad_pcb, Self Balancing Robot.kicad_sch, Standoffs 1.stl]
2025-05-05 nueva carpeta para control LQR
    Estamos desarrollando el control para la gravedad cero neumatica
    [contornos.dxf, pancito.dxf, sign2.dxf, sign3.dxf]
2025-05-05 Modificacion de la calculadora
    Agregamos entrada de datos y continuacion de calculos
2025-07-25 Image_clear
    Programa para poner fondo blanco y mejorar fotos
2025-07-25 nuevo archivo
    solo para permitir la carpeta
2025-08-14 nuevo modelo de negocio Asistentes 2025
2025-09-29 Grafica del resorte
    Para Lexa PI
    [resumen_facturas.xlsx, resumen_facturas_recibidas_2025.xlsx]
2026-03-09 Calculadora actualizada
    tiene calculo de fuerza de cilindro
2026-03-17 LEXA PI
    PANACEA VERSION
    [1047.000.000.000.SANDWICH_PLACA_CINTURA.CATProduct, 1074.000.000.000.ENSAMBLE_BRAZO.CATProduct, 1074.000.000.000.ENSAMBLE_BUJES_CODO.CATProduct, 1074.000.000.000.ENSAMBLE_GENERAL.CATProduct, 1074.000.000.000.ENSAMBLE_GENERAL_SIMETRIA.CATProduct, 1074.000.000.000.ENSAMBLE_GENERAL_Y01.dxf, 1074.000.000.000.ENSAMBLE_PLACA_CINTURON.CATProduct, 1074.000.000.000.ENSAMBLE_TORNILLO_TUERCA_CODO.CATProduct]
2026-03-17 TWO CHANGES
    HOMOLOGATION VERSION
    [1047.000.000.000.SANDWICH_PLACA_CINTURA.CATProduct, 1074.000.000.000.ENSAMBLE_BRAZO.CATProduct, 1074.000.000.000.ENSAMBLE_BUJES_CODO.CATProduct, 1074.000.000.000.ENSAMBLE_GENERAL.CATProduct, 1074.000.000.000.ENSAMBLE_PLACA_CINTURON.CATProduct, 1074.000.000.000.ENSAMBLE_TORNILLO_TUERCA_CODO.CATProduct, 1074.000.000.000.ENSAMBLE_TUBO_ESPALDA.CATProduct, 1074.000.000.000.ESLABON1.CATPart]
2026-03-18 Cambie la cola
    Se modifica la cola porque senti contacto con mi espalda, aun no se fabrica y prueba
    [1074.000.000.000.ENSAMBLE_BRAZO.CATProduct, 1074.000.000.000.ENSAMBLE_GENERAL.CATProduct, 1074.000.000.000.ENSAMBLE_TUBO_ESPALDA.CATProduct, 1074.000.025.000.REDONDO_ROTULA.CATPart, 1074.000.025.000.RED_SUP_ROTULA.CATProduct, 1074.000.026.000.BRAZO.CATProduct, 1074.000.026.001.BARRA_BRAZO.CATPart, PIEZA_26.dxf]
2026-03-21 VERSION 3
    VERSION QUE TAMBIEN CALIFICA EN LA TABLA
    [005.CATPart, 006.CATPart, 1.CATPart, 1069.001.000.ENSAMBLE_ESPALDA.CATProduct, 1069.001.000.ESPALDA.CATPart, 1069.101.003.001.PLACA_PRINCIPAL_AJUSTE.CATPart, 1069.101.003.002.SOPORTE_GUITARRA.CATPart, 1069.102.001.000.SALIDA_BISAGRA.CATPart]
2026-03-21 LEXA WS
    PROYECTO ACTUALIZADO AL ULTIMO ESTADO
    [#1360.000.018.000.3.ENGRANE_Y01_PLANTILLAS.dxf, 1069.000.000.000.CINTA_ANTEBRAZO.CATPart, 1069.000.000.000.CINTA_BICEP.CATPart, 1069B.001.000.000.CHALECO.CATProduct, 1069B.001.000.000.EJES.CATPart, 1069B.001.001.000.SOPORTE_ESPALDA.CATPart, 1069B.001.002.000.TIRANTE_SUP.CATPart, 1069B.001.002.000.TIRANTE_SUP_SIM.CATPart]
2026-03-27 BRAZO HEINEKEN
    [1656.000.000.000.PALLET_BARRIL.CATProduct, 1656.002.001.000.BARRIL.CATPart, 1893.000.000.000.BASTIDOR_PRINCIPAL.CATProduct, 1893.000.000.000.BRAZO.CATProduct, 1893.000.000.000.CAMION.CATProduct, 1893.000.000.000.ENSAMBLE_GENERAL.CATProduct, 1893.000.000.000.SOP_LLANTA.CATPart, 1893.000.000.000.SOP_LLANTA_SIMETRIA.CATPart]
2026-03-27 gravedad cero
    [1074.000.000.000.ENSAMBLE_GENERAL.CATProduct]
2026-03-27 actualizacion junta
    [1656.002.001.000.BARRIL.CATPart, 1893.000.000.000.ANTEBRAZO.CATPart, 1893.000.000.000.BASTIDOR_PRINCIPAL.CATProduct, 1893.000.000.000.BRAZO.CATProduct, 1893.000.000.000.ENSAMBLE_GENERAL.CATProduct, 1893.000.000.000.SOP_LLANTA_SIMETRIA.CATPart, 1893.000.001.000.RIEL_SUP.CATPart, 66-90D326457__00_000_____MANERAL________________________________________.CATPart]
2026-03-28 Revision Heieneken
    [1893.000.000.000.BRAZO.CATProduct, 1893.000.000.000.ENSAMBLE_GENERAL.CATProduct, 66-95D326790__00_000_000_BRAZO_PRIM_PRINCIPAL_DAG_____________________.CATProduct, SR.B.000.000.GRIPPER.CATProduct]
2026-03-31 DAY UPDATE
    [1074.000.000.000.ENSAMBLE_GENERAL.CATProduct, 1074.000.000.000.SOPORTES.CATProduct, 1871.000.002.000.BRAZO.CATPart, 1871.000.003.000.BISAGRA_CODO.CATProduct, 1871.000.003.001.BISAGRA_BUJE.CATPart, 1871.000.007.000.ENSAMBLE_ANTEBRAZO.CATProduct, 1871.000.007.001.SM_ANTEBRAZO.CATPart, 19222 DSNU-25-80-P---(A----0-ZR).CATPart]
2026-04-01 7.14 update
    [1074.000.000.000.ENSAMBLE_GENERAL.CATProduct, 1074.000.000.000.ENSAMBLE_TUBO_ESPALDA.CATProduct, 1074.000.000.000.SOPORTES.CATProduct, 1074.000.025.000.REDONDO_ROTULA.CATPart, 1074.000.025.000.RED_SUP_ROTULA.CATProduct, 1871.000.003.000.BISAGRA_CODO.CATProduct, 1871.000.003.001.BISAGRA_BUJE.CATPart, 1871.000.003.002.BISAGRA_PLACA.CATPart]
2026-04-07 update 060426
    Modificacionde piezas para que pueda abrir y cerrar el antebrazo
    [1074.000.000.000.ENSAMBLE_GENERAL.CATProduct, 1074.000.000.000.ENSAMBLE_TUBO_ESPALDA.CATProduct, 1074.000.000.000.SOPORTES.CATProduct, 1074.000.025.000.REDONDO_ROTULA.CATPart, 1074.000.025.000.RED_SUP_ROTULA.CATProduct, 1871.000.003.000.BISAGRA_CODO.CATProduct, 1871.000.003.001.BISAGRA_BUJE.CATPart, 1871.000.007.000.ENSAMBLE_ANTEBRAZO.CATProduct]
2026-04-08 uodate exo 080426
    [1074.000.000.000.ENSAMBLE_GENERAL.CATProduct, 1074.000.000.000.ENSAMBLE_TUBO_ESPALDA.CATProduct, 1074.000.000.000.SOPORTES.CATProduct, 1074.000.025.000.REDONDO_ROTULA.CATPart, 1074.000.025.000.RED_SUP_ROTULA.CATProduct, 1871.000.003.000.BISAGRA_CODO.CATProduct, 1871.000.003.001.BISAGRA_BUJE.CATPart]
2026-04-10 UPDATE HEINEKEN
    [1893.000.000.000.ANTEBRAZO.CATPart, 1893.000.000.000.BASTIDOR_PRINCIPAL.CATProduct, 1893.000.000.000.BRAZO.CATProduct, 1893.000.000.000.ENSAMBLE_GENERAL.CATProduct, 1893.000.000.000.SOP_LLANTA_SIMETRIA.CATPart, 66-90D326457__00_000_____MANERAL________________________________________.CATPart, 66-95D326790__00_000_000_BRAZO_PRIM_PRINCIPAL_DAG_____________________.CATProduct, 66-95D326790__00_000_00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]
2026-04-13 update 130426
    modifique dimensiones
    [1074.000.000.000.ENSAMBLE_GENERAL.CATProduct, 1074.000.000.000.ENSAMBLE_TUBO_ESPALDA.CATProduct, 1074.000.000.000.SOPORTES.CATProduct, 1074.000.025.000.REDONDO_ROTULA.CATPart, 1074.000.025.000.RED_SUP_ROTULA.CATProduct, 1871.000.002.000.BRAZO.CATPart, 1871.000.003.000.BISAGRA_CODO.CATProduct, 1871.000.003.001.BISAGRA_BUJE.CATPart]
2026-04-13 COPIA ANTEBRAZO
    [1074.000.000.000.ENSAMBLE_TORNILLO_TUERCA_CODO.CATProduct, 1074.000.000.000.SOPORTES.CATProduct, 1074.000.013.000.ARANDELA.CATPart, 1074.000.014.000.BUJE_B_CODO.CATPart, 1074.000.015.000.BUJE_A_CODO.CATPart, 1074.000.026.001.BARRA_BRAZO.CATPart, 1871.000.000.000.ENSAMBLE_SOP_BICEP.CATProduct, 1871.000.000.000.ENSAMBLE_muneca.CATProduct]
2026-04-16 emcanismo bote
    [DS3225MG Servo 25Kg 4.8-6.8V.stp, MECA.CATProduct, Part10.CATPart, Part8.CATPart, Part9.CATPart, Product3.CATProduct, eslabon 0.CATPart, eslabon 1.CATPart]
2026-04-20 VERSION 1.7 SHEET_METAL
    Deje la version de lamina doblada en 1.7 para seguir trabajando 1.6 para fabricar en china
    [1047.000.000.000.SANDWICH_PLACA_CINTURA.CATProduct, 1074.000.000.000.ENSAMBLE_GENERAL.CATProduct, 1074.000.000.000.ENSAMBLE_PLACA_CINTURON.CATProduct, 1074.000.000.000.ENSAMBLE_TORNILLO_TUERCA_CODO.CATProduct, 1074.000.000.000.ENSAMBLE_TUBO_ESPALDA.CATProduct, 1074.000.000.000.MODULO_ASISTENCIA.CATProduct, 1074.000.000.000.SOPORTES.CATProduct, 1074.000.006.000.BASE_FIJ_POT.CATPart]
2026-04-23 Lexa y AwareTrack
    [1074.000.000.000.1_Y01.dxf, 1074.000.000.000.ENSAMBLE_GENERAL.CATProduct, 1074.000.000.000.ENSAMBLE_GENERAL_SIMETRIA.CATProduct, 1074.000.000.000.ENSAMBLE_TUBO_ESPALDA.CATProduct, 1074.000.000.000.SOPORTES.CATProduct, 1074.000.025.000.REDONDO_ROTULA.CATPart, 1074.000.025.000.RED_SUP_ROTULA.CATProduct, 1468347-17ce81c1-81a7-4233-b37e-8e6fe6e909be.stp.CATPart]
2026-04-27 UPDATE
    FINISH 1
    [1880.000.000.000.PCB_B.CATProduct, 1889.000.000.000.ENSAMBLE_GENERAL.CATProduct, 1889.000.001.000.CASE_FEMALE.CATPart, 1889.000.001.000.CASE_MALE_B.CATPart, 1889.000.001.000.CASE_MALE_C.CATPart, Corps.CATPart, IRFZ44N-4d37f16c-336c-42d5-8360-7415362b12d3.CATPart, LED_1206_3216Metric-485a2445-00ce-3ac5-f31c-eaeb511a541f.CATPart]
2026-04-27 update
    coloque barrenos para una base
    [1889.000.001.000.CASE_FEMALE.CATPart, 1889.000.001.000.CASE_FEMALE.stp, 1889.000.001.000.CASE_MALE_B.CATPart, 1889.000.001.000.CASE_MALE_B.stp]
2026-04-30 NUIEVA VERSION 1.8
    Se agrega nueva version para trabajar un modelo comrecial ligero y pasivo
    [1047.000.000.000.SANDWICH_PLACA_CINTURA.CATProduct, 1074.000.000.000.1_Y01.dxf, 1074.000.000.000.ENSAMBLE_GENERAL.CATProduct, 1074.000.000.000.ENSAMBLE_GENERAL_SIMETRIA.CATProduct, 1074.000.000.000.ENSAMBLE_PLACA_CINTURON.CATProduct, 1074.000.000.000.ENSAMBLE_TORNILLO_TUERCA_CODO.CATProduct, 1074.000.000.000.ENSAMBLE_TUBO_ESPALDA.CATProduct, 1074.000.000.000.MODULO_ASISTENCIA.CATProduct]
2026-04-30 daba problemas de sincronizacio
    esta respaldado en escritorio de multivac
    [005.CATPart, 006.CATPart, 1.CATPart, 1069.001.000.ENSAMBLE_ESPALDA.CATProduct, 1069.001.000.ESPALDA.CATPart, 1069.101.003.001.PLACA_PRINCIPAL_AJUSTE.CATPart, 1069.101.003.002.SOPORTE_GUITARRA.CATPart, 1069.102.001.000.SALIDA_BISAGRA.CATPart]
2026-05-03 UODATE
    base privisional montaje
    [1889.000.000.000.ENSAMBLE_GENERAL.CATProduct, 1889.000.002.000.CASE_MALE_B.CATPart, 1889.000.003.000.CALCOMANIA.CATPart, 1889.000.004.000.PCB_PROVISIONAL.CATPart, 1889.000.005.000.BASE_PCB_PROVISIONAL.CATPart, 1889.000.006.000.BASE_PCB_MONTAJE.CATPart, 1889.000.006.000.BASE_PCB_PROVISIONAL.CATPart]
2026-05-13 Soporte nuevo
    Diseño de nuevo soporte para canal U
    [1889.000.000.000.ENSAMBLE_GENERAL.CATProduct, 1889.000.007.000.BASE_2_PCB_MONTAJE.CATPart, CANAL_U.CATPart]
2026-10-06 update exo
    case nuevo
    [1.54 i2c oled.CATPart, 1047.000.000.000.SANDWICH_PLACA_CINTURA.CATProduct, 1074.000.000.000.CONTROL.CATProduct, 1074.000.000.000.ENSAMBLE_BRAZO.CATProduct, 1074.000.000.000.ENSAMBLE_BUJES_CODO.CATProduct, 1074.000.000.000.ENSAMBLE_GENERAL.CATProduct, 1074.000.000.000.ENSAMBLE_GENERAL_SIMETRIA.CATProduct, 1074.000.000.000.ENSAMBLE_PLACA_CINTURON.CATProduct]
2026-10-09 cover update
    [1074.000.000.000.CONTROL.CATProduct, 1074.000.028.000.COVER.CATPart, PANTALLA OLED.CATPart, bouton_12x12mm.CATProduct]
