koteos/RANDOM/(notices)

Notices in the files:
10-EKOT-1074-170619A-UBF-PI/V1.6_PANACEA/2674_SG-M10.stp:
author */ ('License CC BY-ND 4.0'),
